fsnitz/ATLAS-ITk-MOPS-Hub-readout-prototype/Miscellaneous/Figures/PhysicaleLinkSetup.jpeg

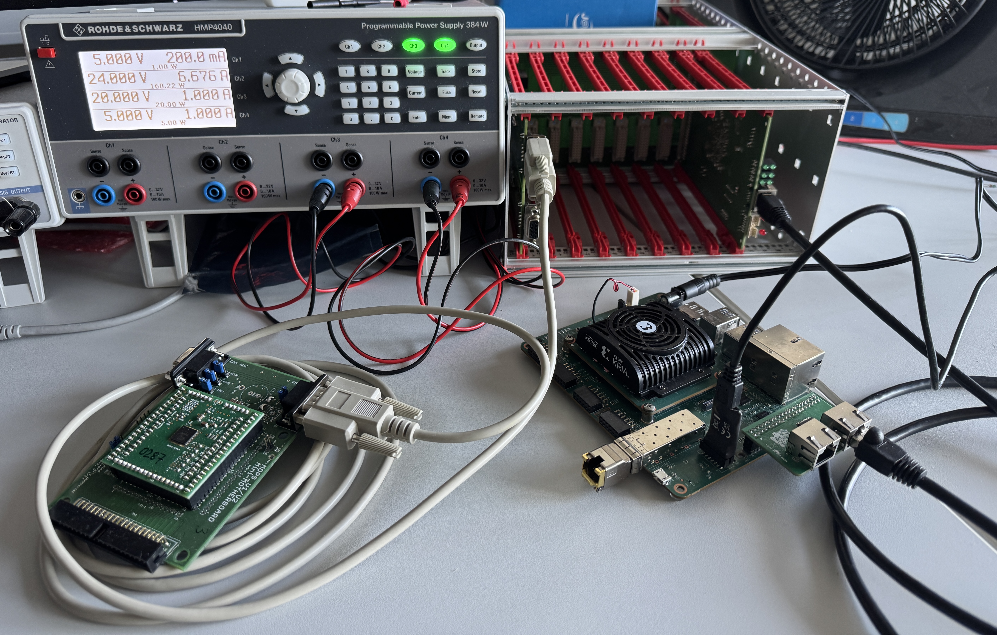
Miscellaneous/Figures/PhysicaleLinkSetup.jpeg
