fsnitz/ATLAS-ITk-MOPS-Hub-readout-prototype/Miscellaneous/Figures/backplane_3D.png

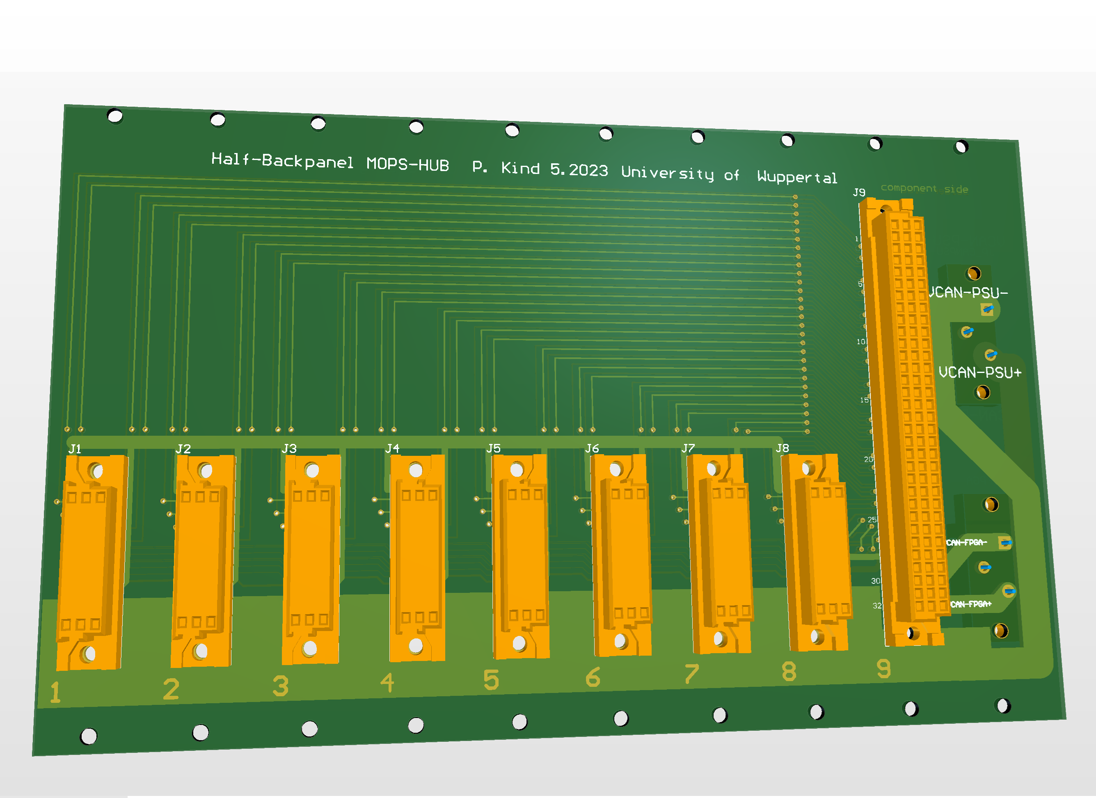
Miscellaneous/Figures/backplane_3D.png
