fsnitz/ATLAS-ITk-MOPS-Hub-readout-prototype/Miscellaneous/Figures/8b10b.png

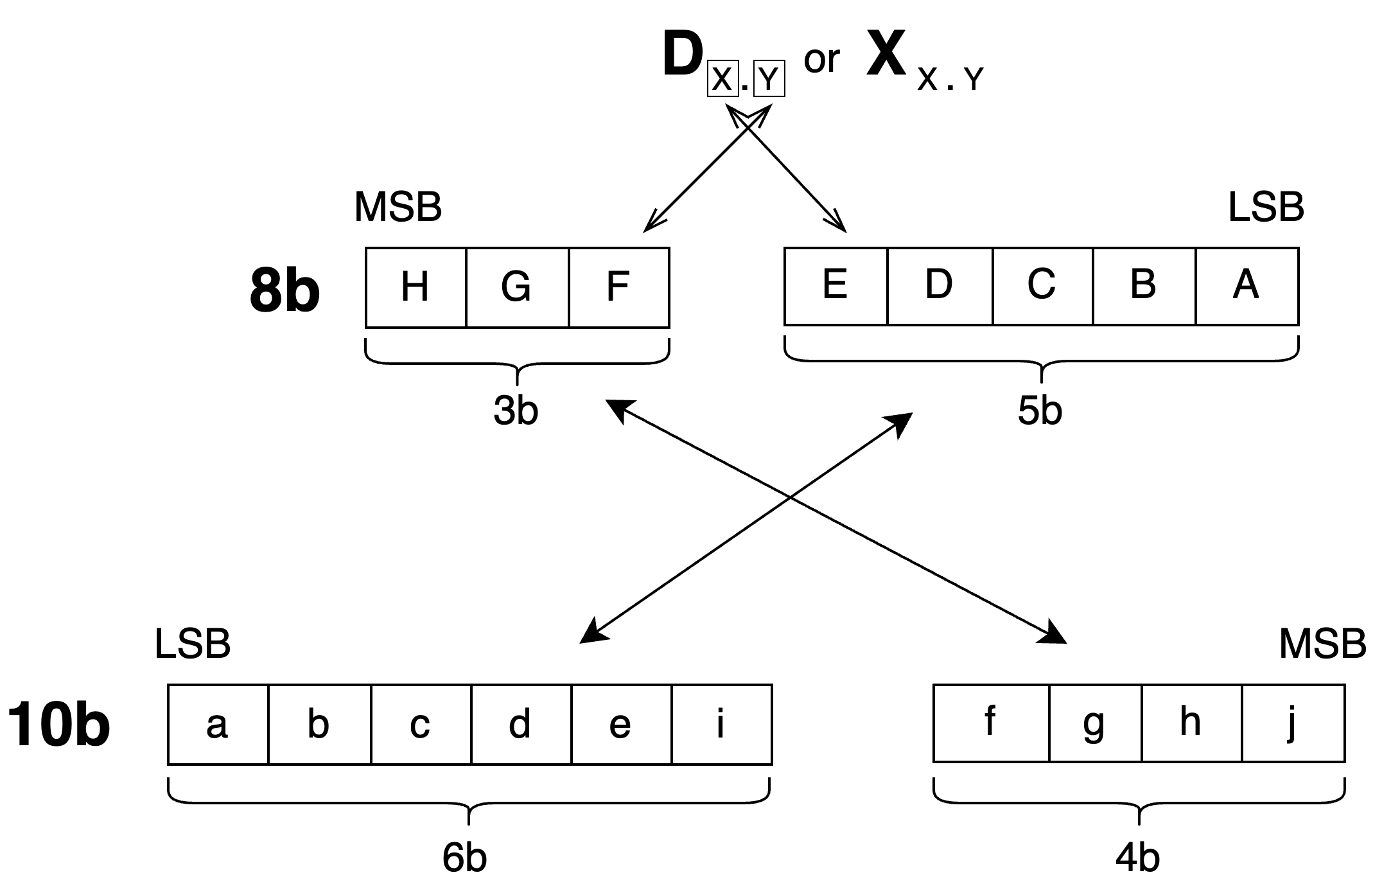
Miscellaneous/Figures/8b10b.png
