fsnitz/ATLAS-ITk-MOPS-Hub-readout-prototype/Miscellaneous/Figures/BaseAddressSetting.png

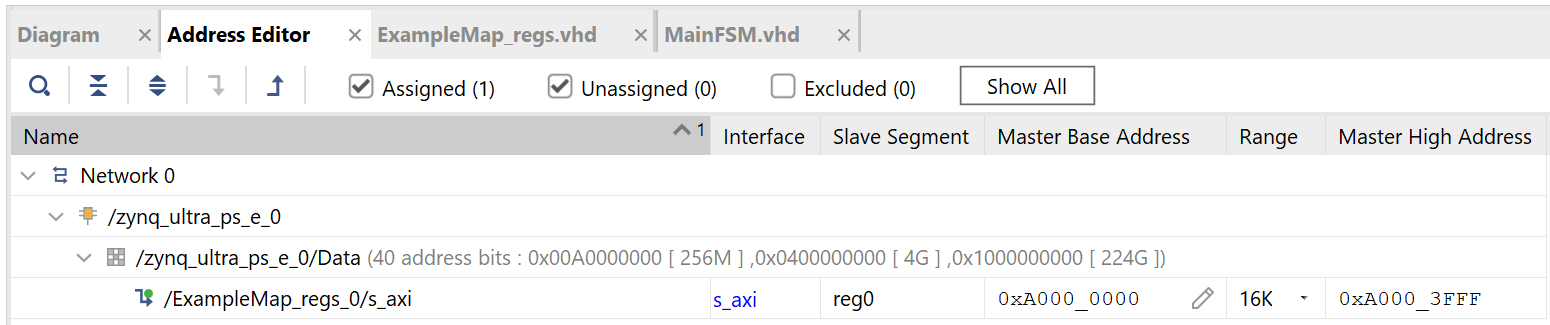
Miscellaneous/Figures/BaseAddressSetting.png
