fsnitz/ATLAS-ITk-MOPS-Hub-readout-prototype/Miscellaneous/Figures/BlockDiagramAirhdlExample.png

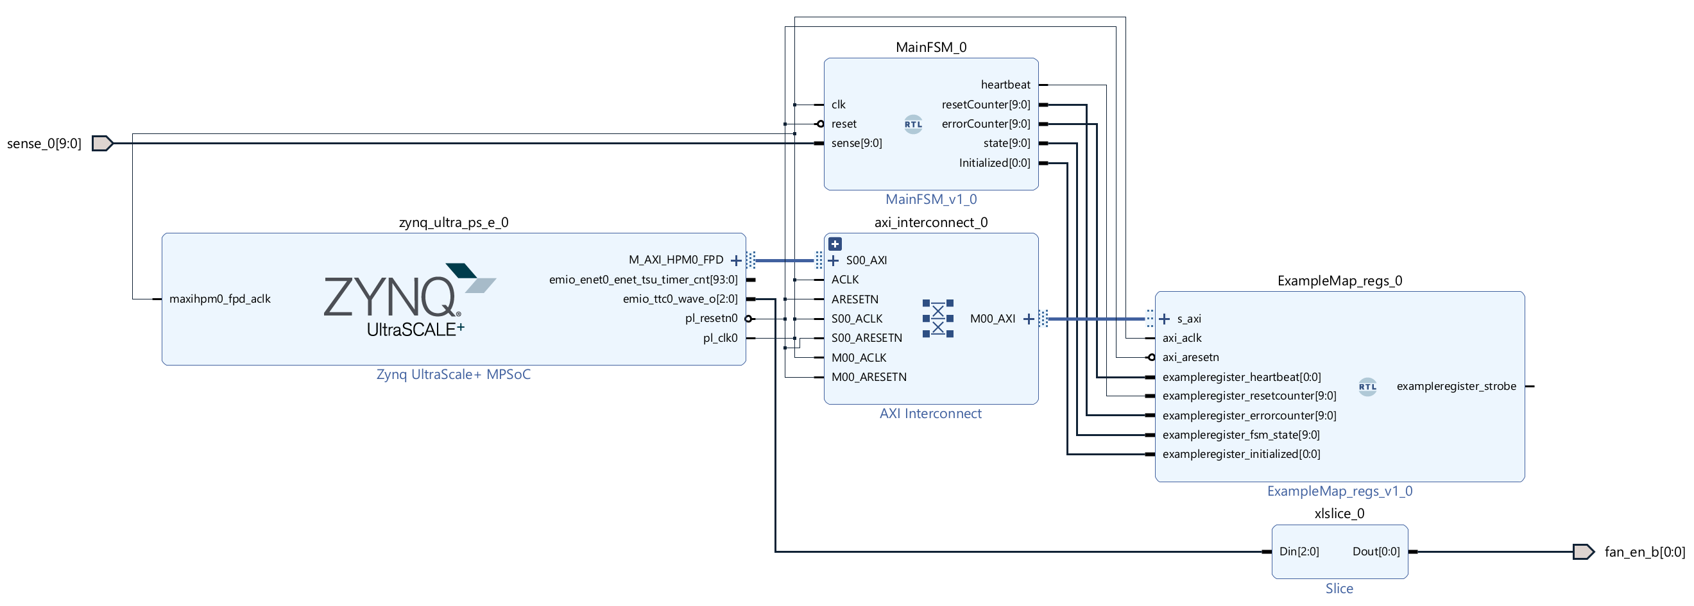
Miscellaneous/Figures/BlockDiagramAirhdlExample.png
