fsnitz/ATLAS-ITk-MOPS-Hub-readout-prototype/Miscellaneous/Figures/CIC_3d.png

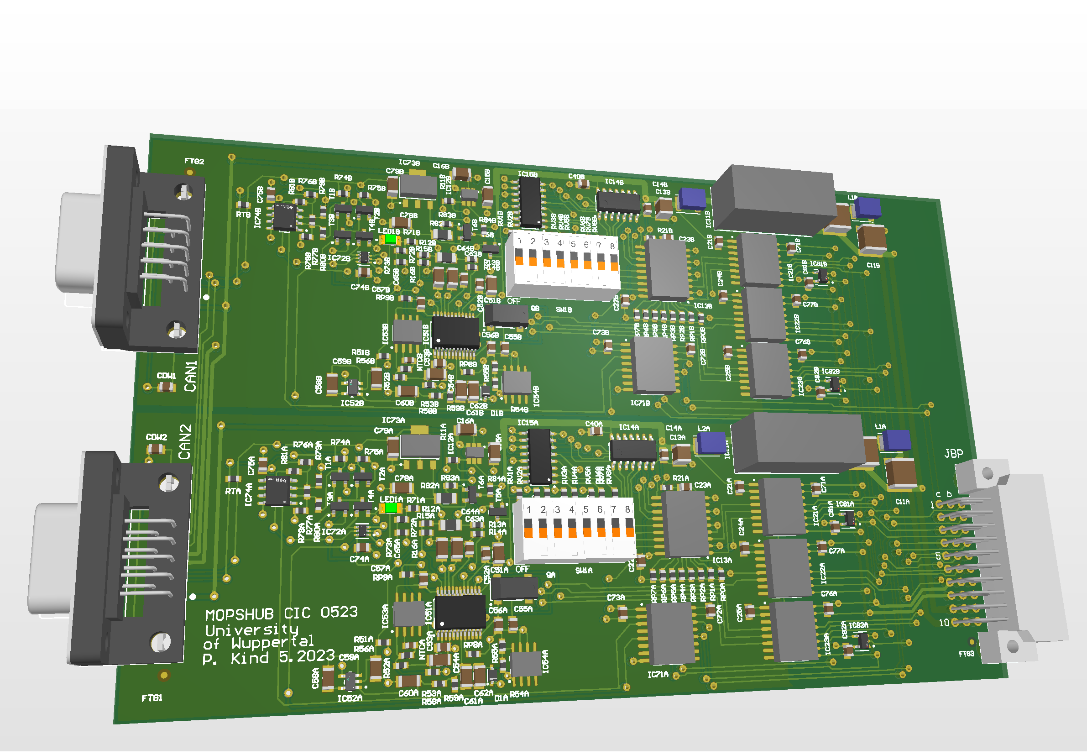
Miscellaneous/Figures/CIC_3d.png
