fsnitz/ATLAS-ITk-MOPS-Hub-readout-prototype/Miscellaneous/Figures/ClpsMultipleDrop.png

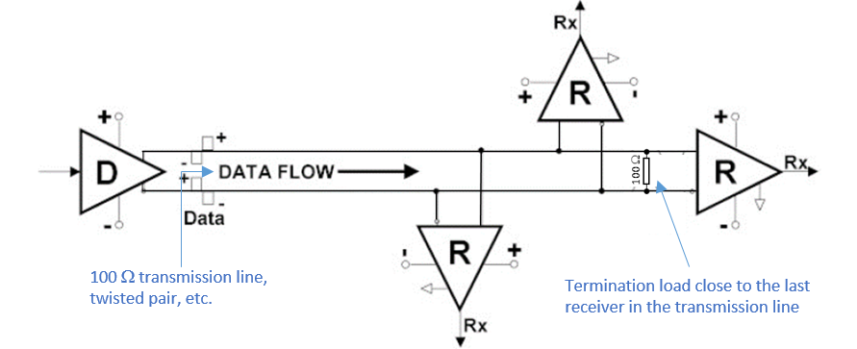
Miscellaneous/Figures/ClpsMultipleDrop.png
