fsnitz/ATLAS-ITk-MOPS-Hub-readout-prototype/Miscellaneous/Figures/ClpsSignalLevelsDefinition.png

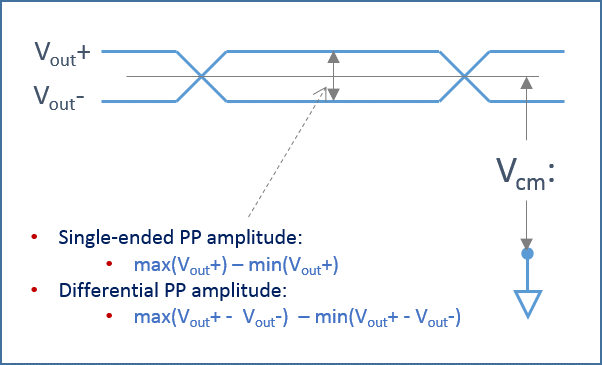
Miscellaneous/Figures/ClpsSignalLevelsDefinition.png
