fsnitz/ATLAS-ITk-MOPS-Hub-readout-prototype/Miscellaneous/Figures/CommonVoltageShift.png

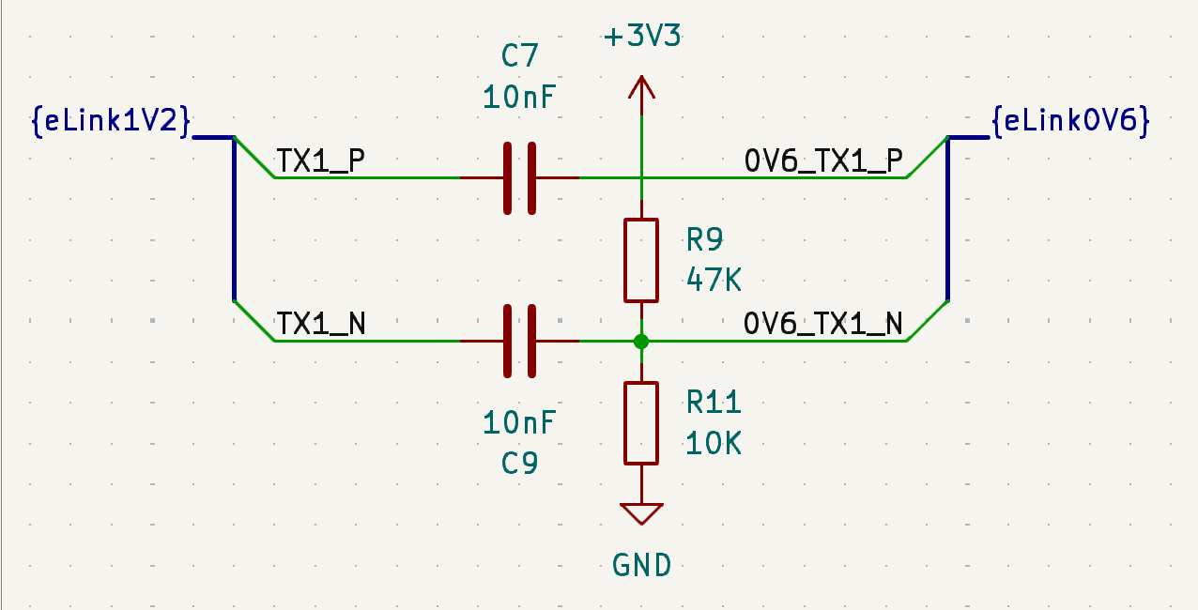
Miscellaneous/Figures/CommonVoltageShift.png
