fsnitz/ATLAS-ITk-MOPS-Hub-readout-prototype/Miscellaneous/Figures/crate_mopshub_top.png

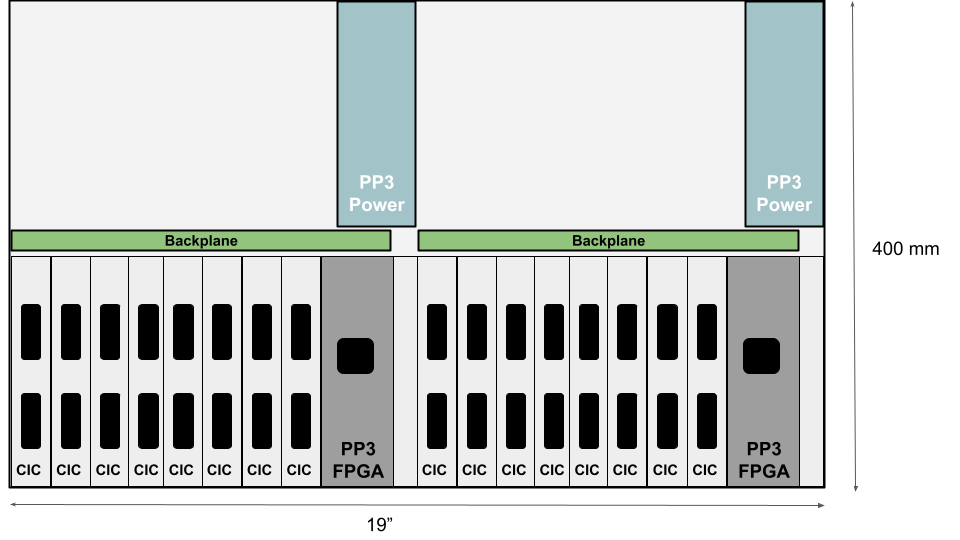
Miscellaneous/Figures/crate_mopshub_top.png
