fsnitz/ATLAS-ITk-MOPS-Hub-readout-prototype/Miscellaneous/Figures/eLinkHatRender.png

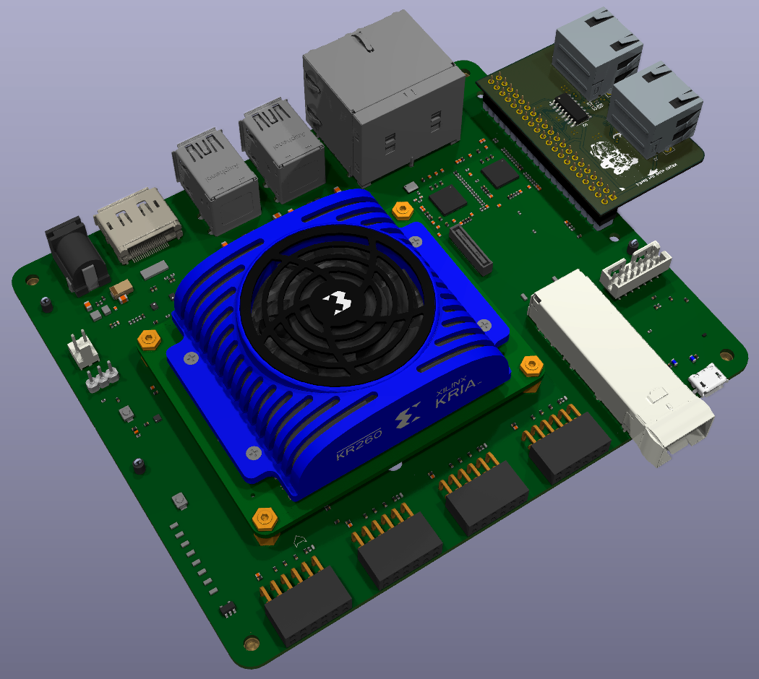
Miscellaneous/Figures/eLinkHatRender.png
