fsnitz/ATLAS-ITk-MOPS-Hub-readout-prototype/Miscellaneous/Figures/ExampleRegisterAirhdl.png

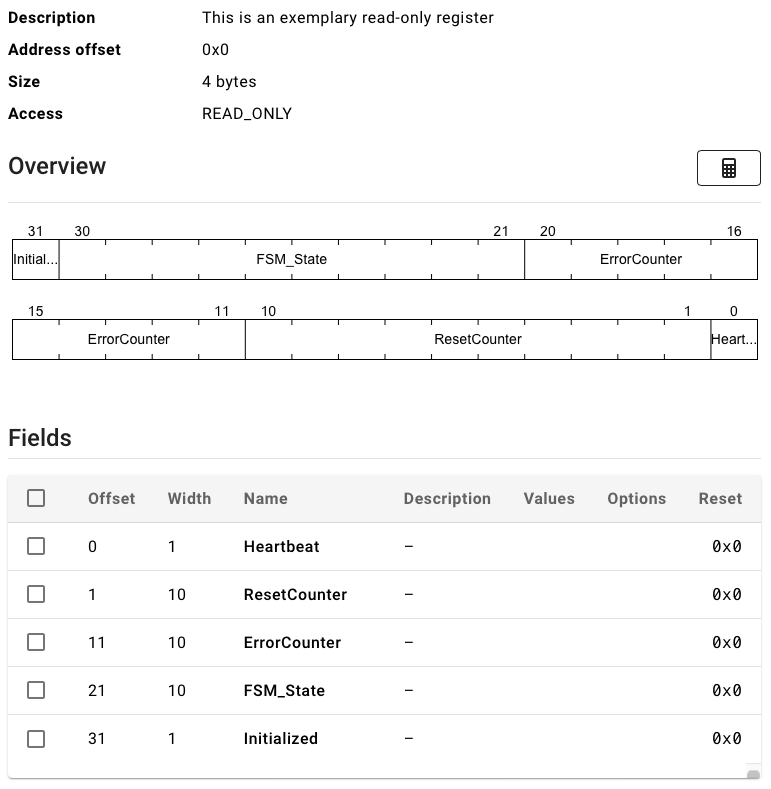
Miscellaneous/Figures/ExampleRegisterAirhdl.png
