fsnitz/ATLAS-ITk-MOPS-Hub-readout-prototype/Miscellaneous/Figures/IDDR.jpeg

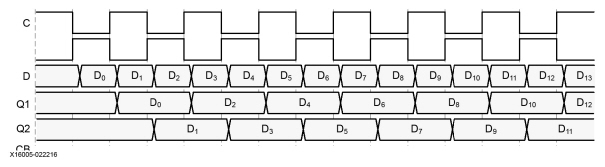
Miscellaneous/Figures/IDDR.jpeg
