fsnitz/ATLAS-ITk-MOPS-Hub-readout-prototype/Miscellaneous/Figures/IlaAfterChangeTo40MHz.png

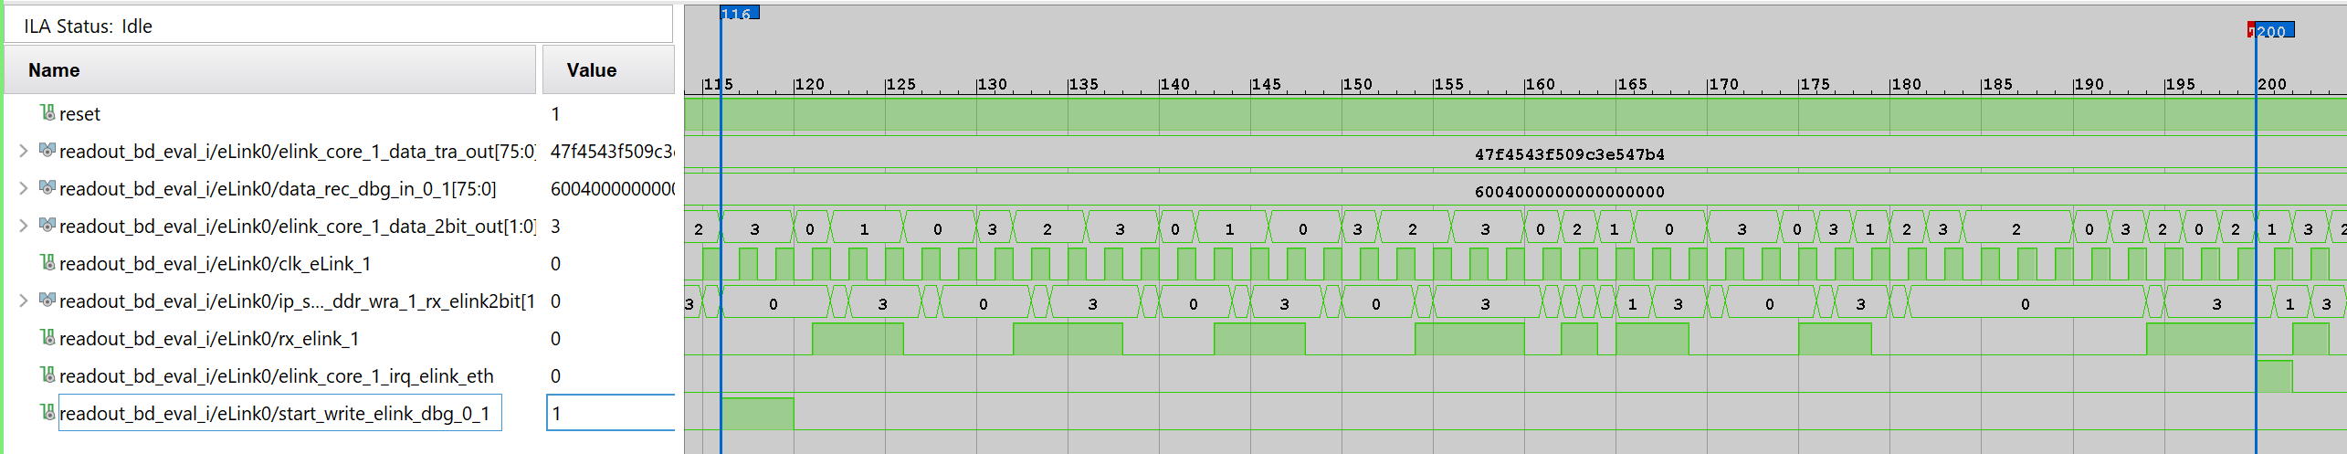
Miscellaneous/Figures/IlaAfterChangeTo40MHz.png
