fsnitz/ATLAS-ITk-MOPS-Hub-readout-prototype/Miscellaneous/Figures/IlaWithTimingError.png

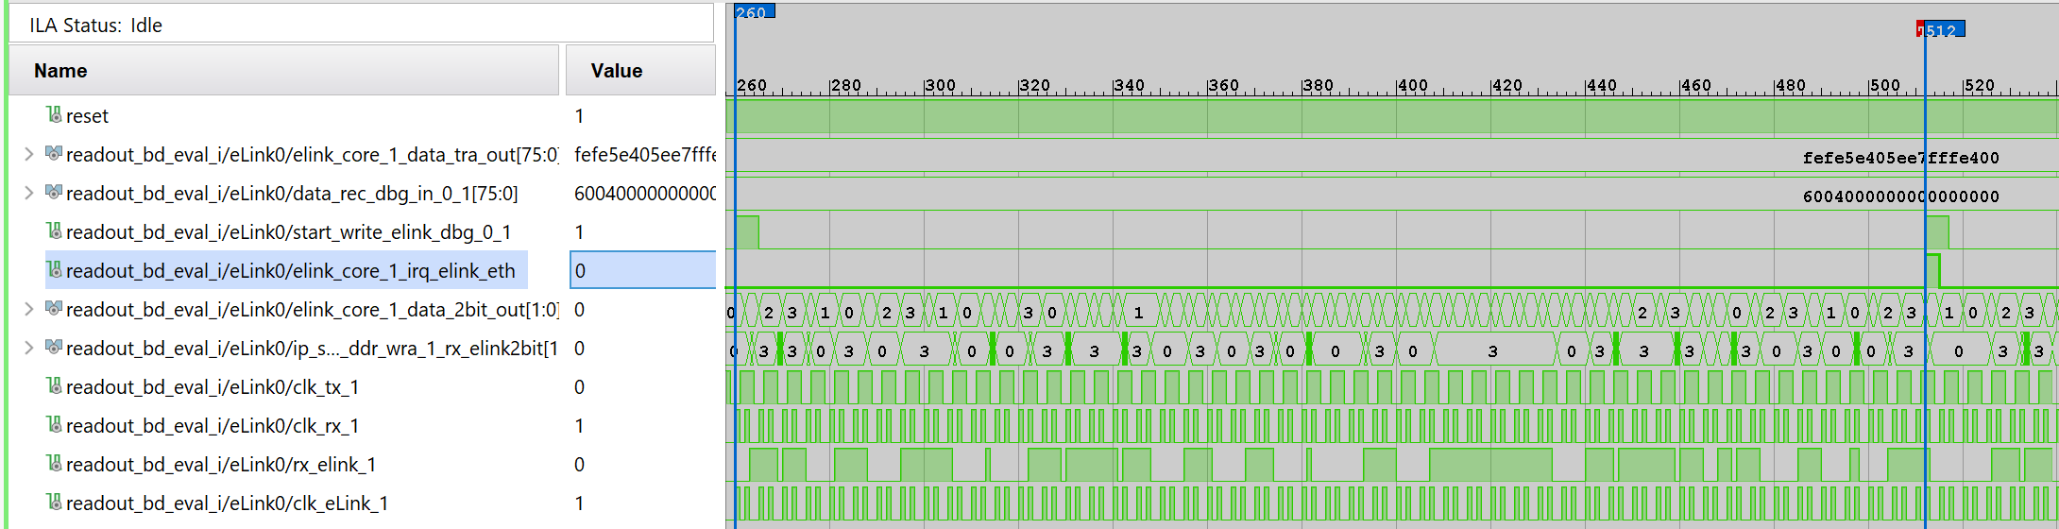
Miscellaneous/Figures/IlaWithTimingError.png
