fsnitz/ATLAS-ITk-MOPS-Hub-readout-prototype/Miscellaneous/Figures/InnerDetector.png

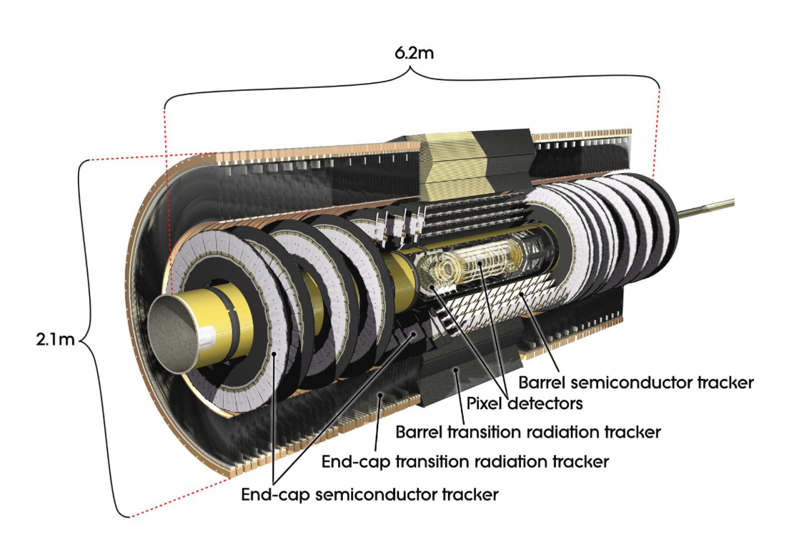
Miscellaneous/Figures/InnerDetector.png
