fsnitz/ATLAS-ITk-MOPS-Hub-readout-prototype/Miscellaneous/Figures/Loopback_biasing.jpeg

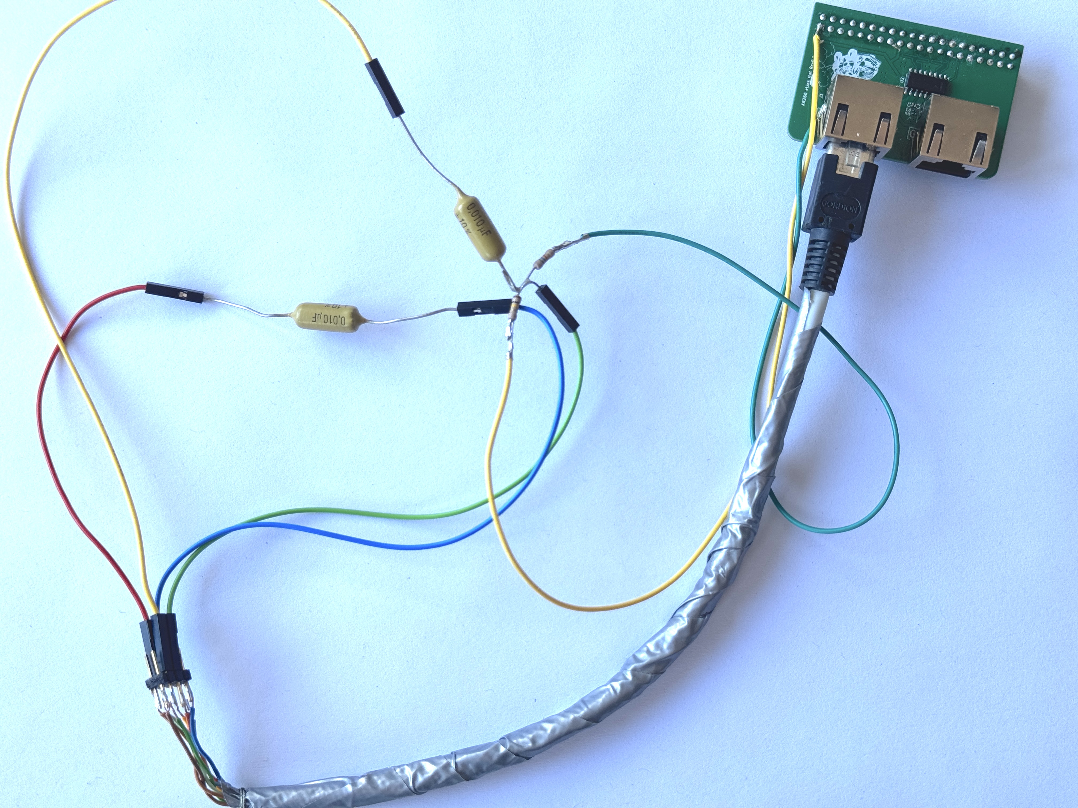
Miscellaneous/Figures/Loopback_biasing.jpeg
