fsnitz/ATLAS-ITk-MOPS-Hub-readout-prototype/Miscellaneous/Figures/ManagerConcept.png

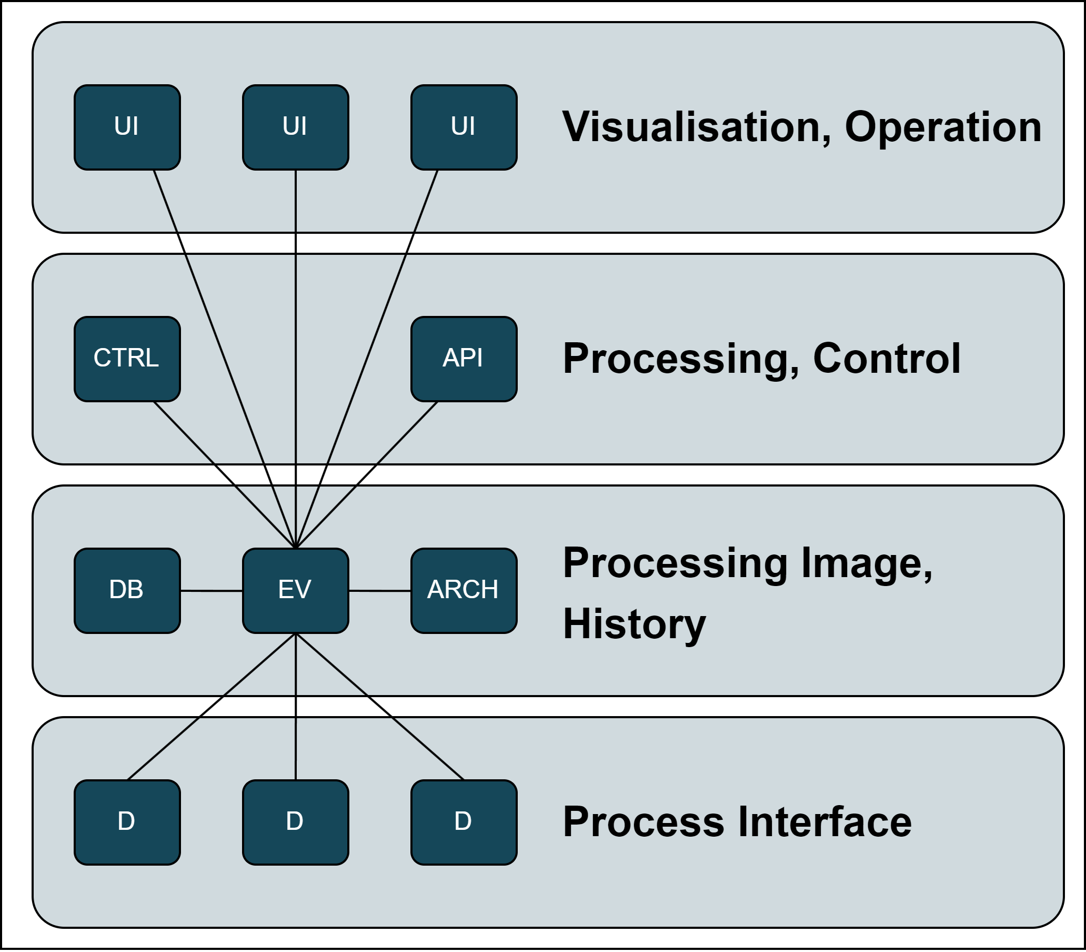
Miscellaneous/Figures/ManagerConcept.png
