fsnitz/ATLAS-ITk-MOPS-Hub-readout-prototype/Miscellaneous/Figures/MopsBlock.png

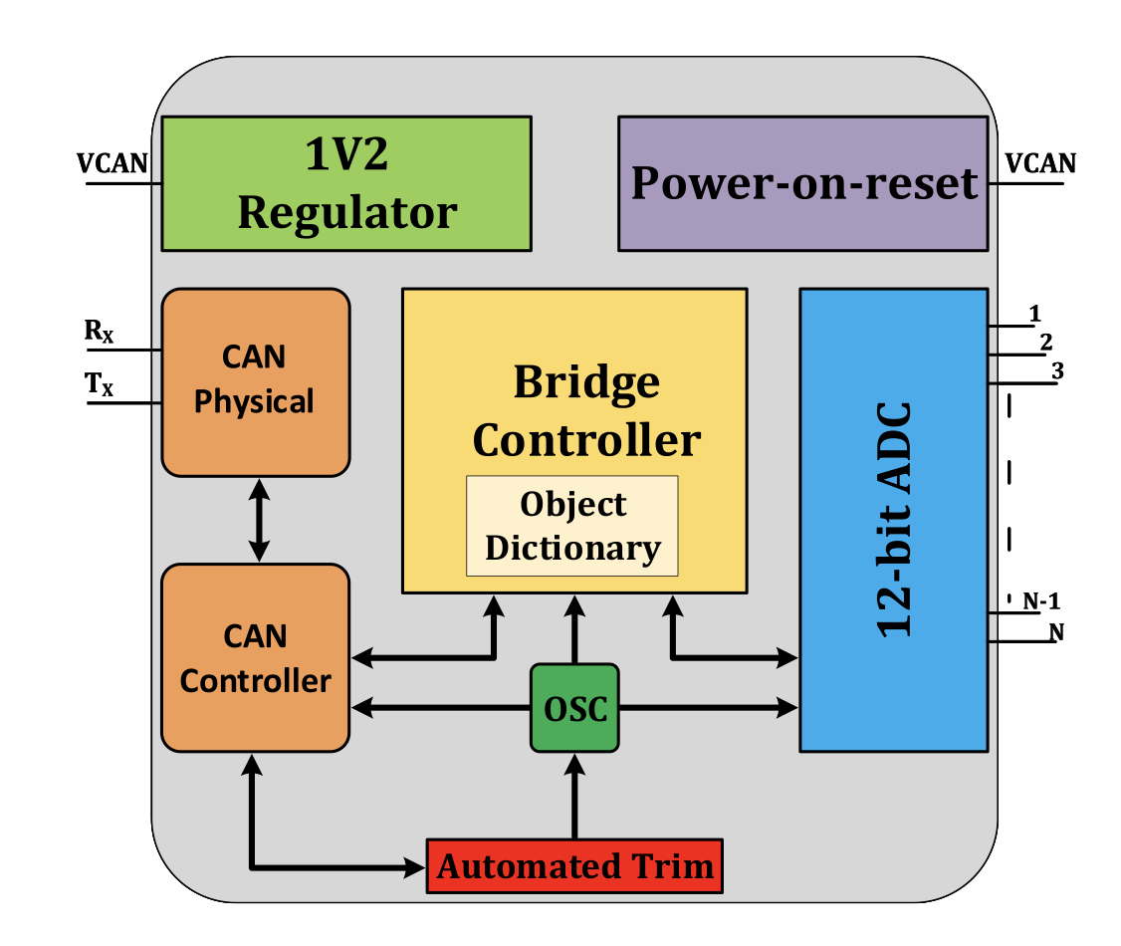
Miscellaneous/Figures/MopsBlock.png
