fsnitz/ATLAS-ITk-MOPS-Hub-readout-prototype/Miscellaneous/Figures/OpcUseCase.png

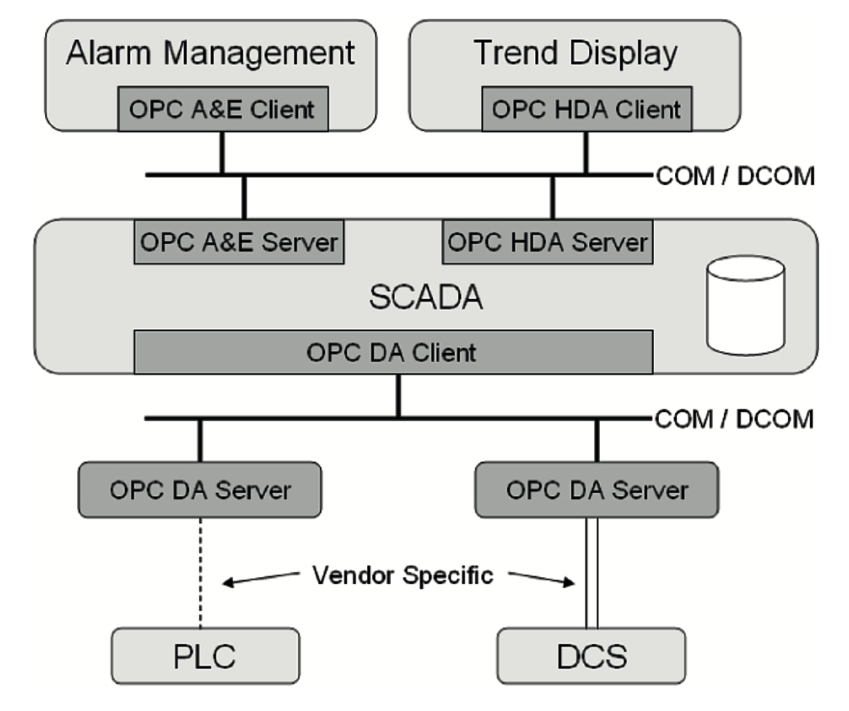
Miscellaneous/Figures/OpcUseCase.png
