fsnitz/ATLAS-ITk-MOPS-Hub-readout-prototype/Miscellaneous/Figures/OverviewScada.png

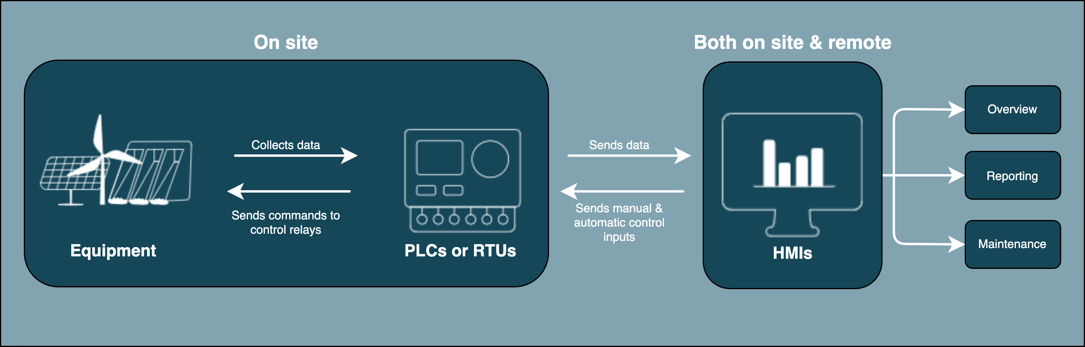
Miscellaneous/Figures/OverviewScada.png
