fsnitz/ATLAS-ITk-MOPS-Hub-readout-prototype/Miscellaneous/Figures/Pixel_DCS.png

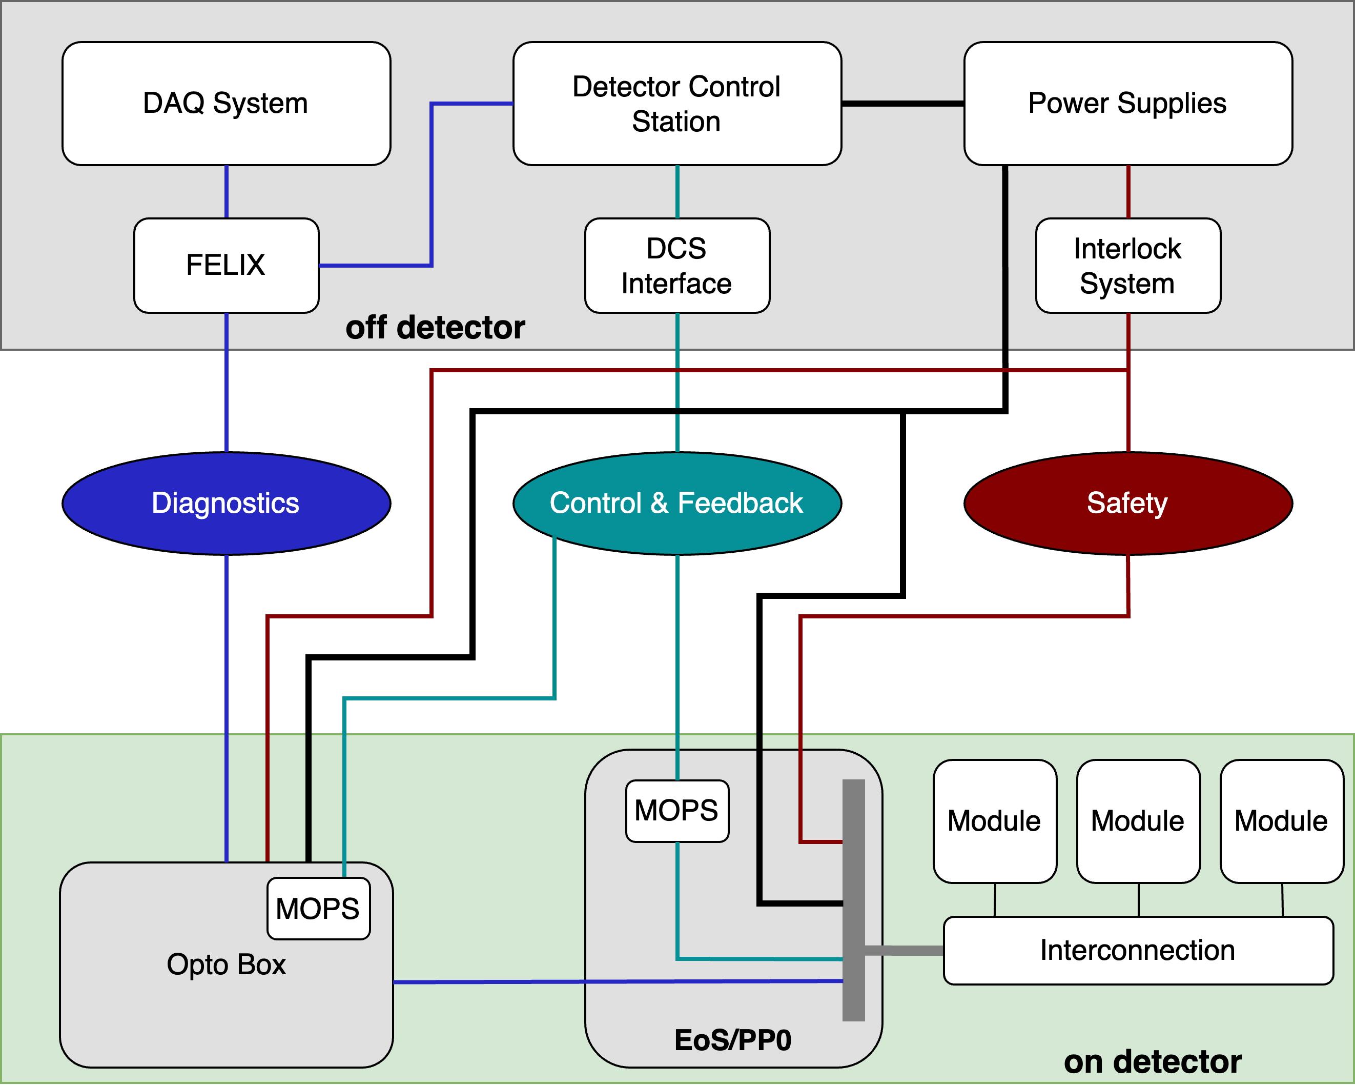
Miscellaneous/Figures/Pixel_DCS.png
