fsnitz/ATLAS-ITk-MOPS-Hub-readout-prototype/Miscellaneous/Figures/powercard_3d.png

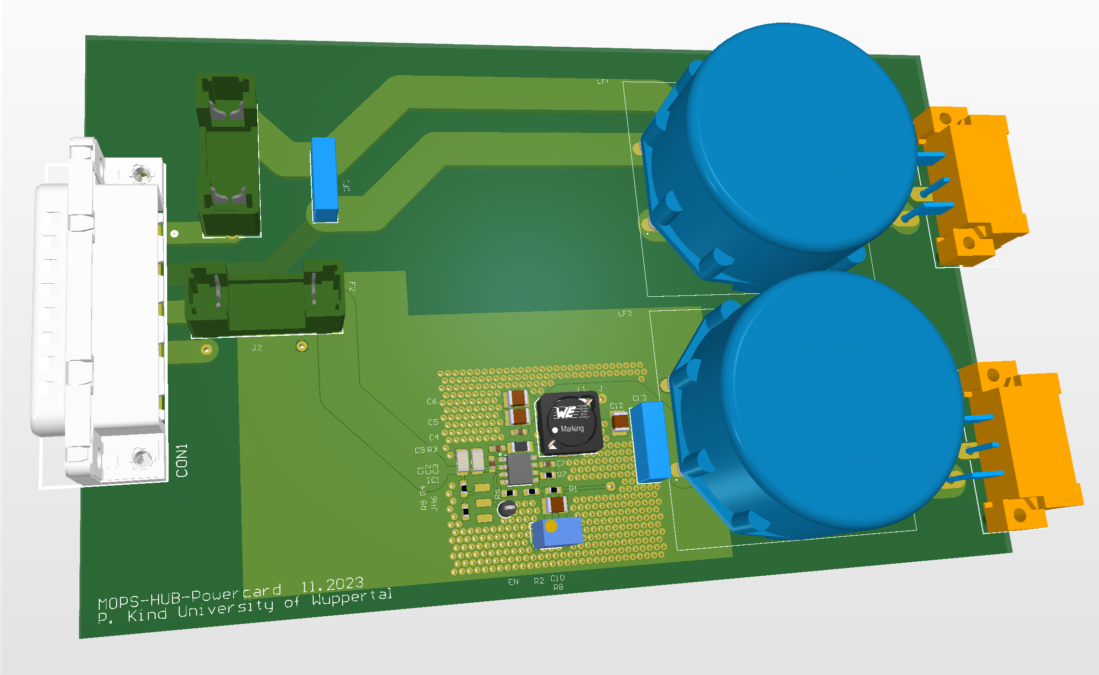
Miscellaneous/Figures/powercard_3d.png
