fsnitz/ATLAS-ITk-MOPS-Hub-readout-prototype/Miscellaneous/Figures/PP3_biasing.jpeg

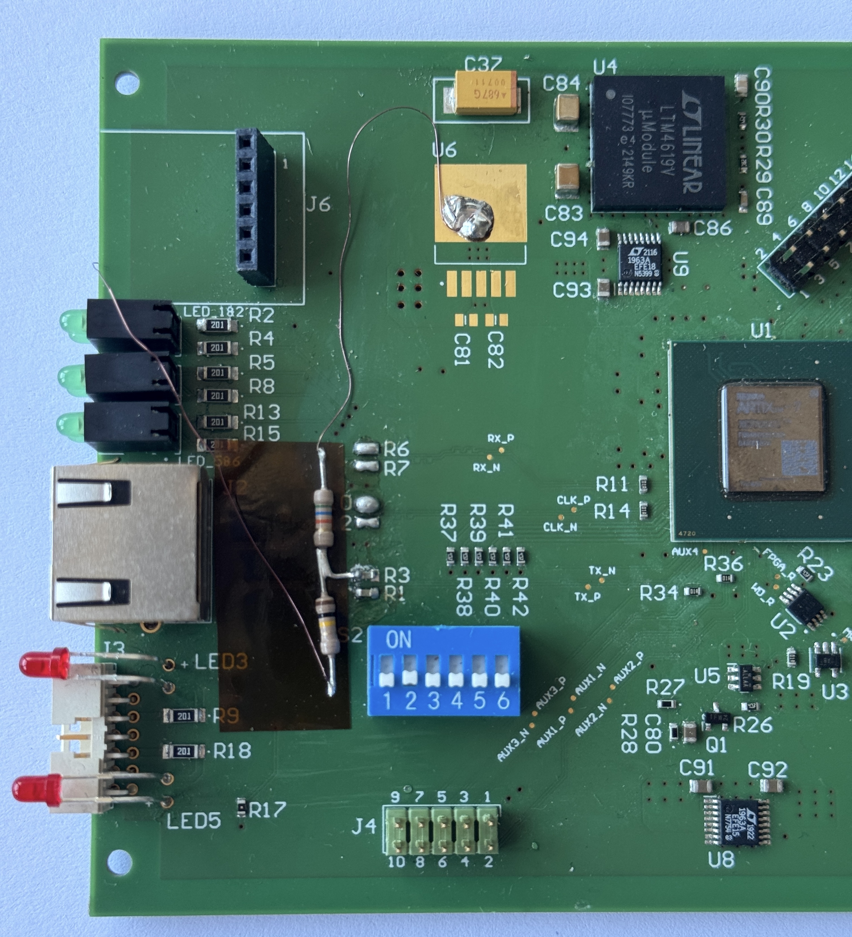
Miscellaneous/Figures/PP3_biasing.jpeg
