fsnitz/ATLAS-ITk-MOPS-Hub-readout-prototype/Miscellaneous/Figures/pp3_fpga_3D.png

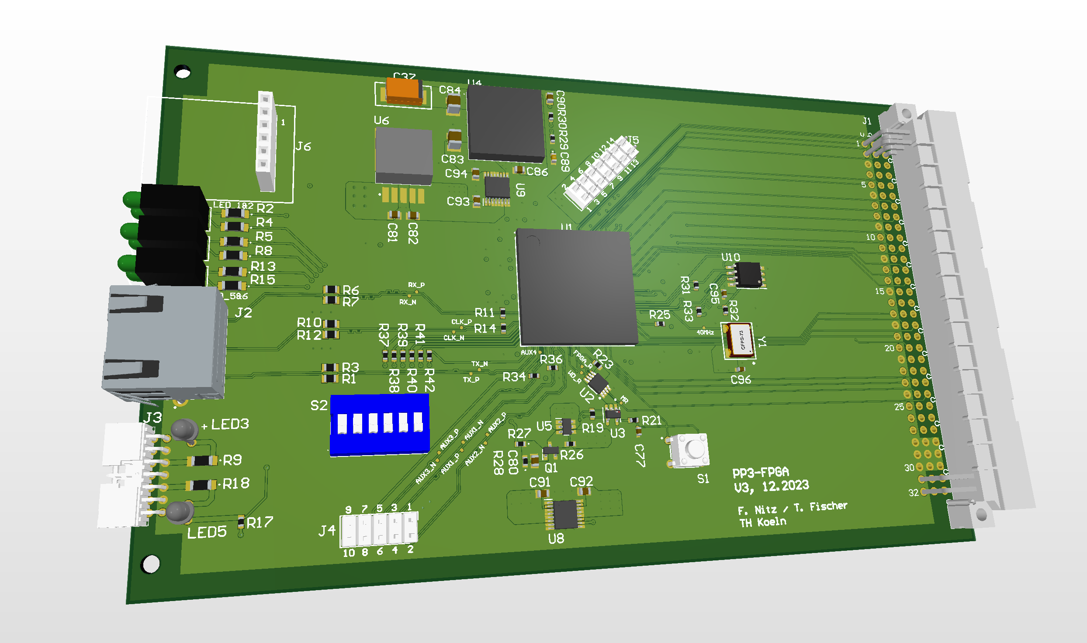
Miscellaneous/Figures/pp3_fpga_3D.png
