fsnitz/ATLAS-ITk-MOPS-Hub-readout-prototype/Miscellaneous/Figures/Readoutchain.png

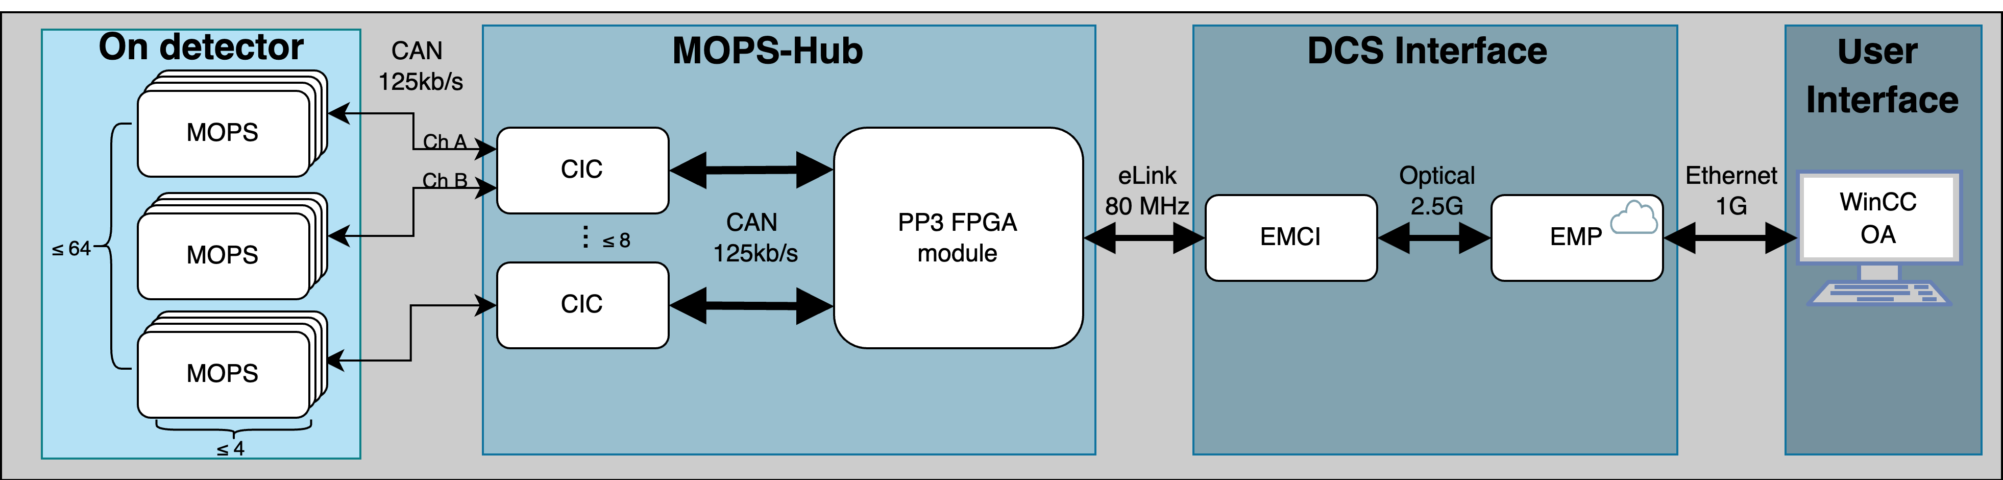
Miscellaneous/Figures/Readoutchain.png
