fsnitz/ATLAS-ITk-MOPS-Hub-readout-prototype/Miscellaneous/Figures/ReadoutchainKRIA.png

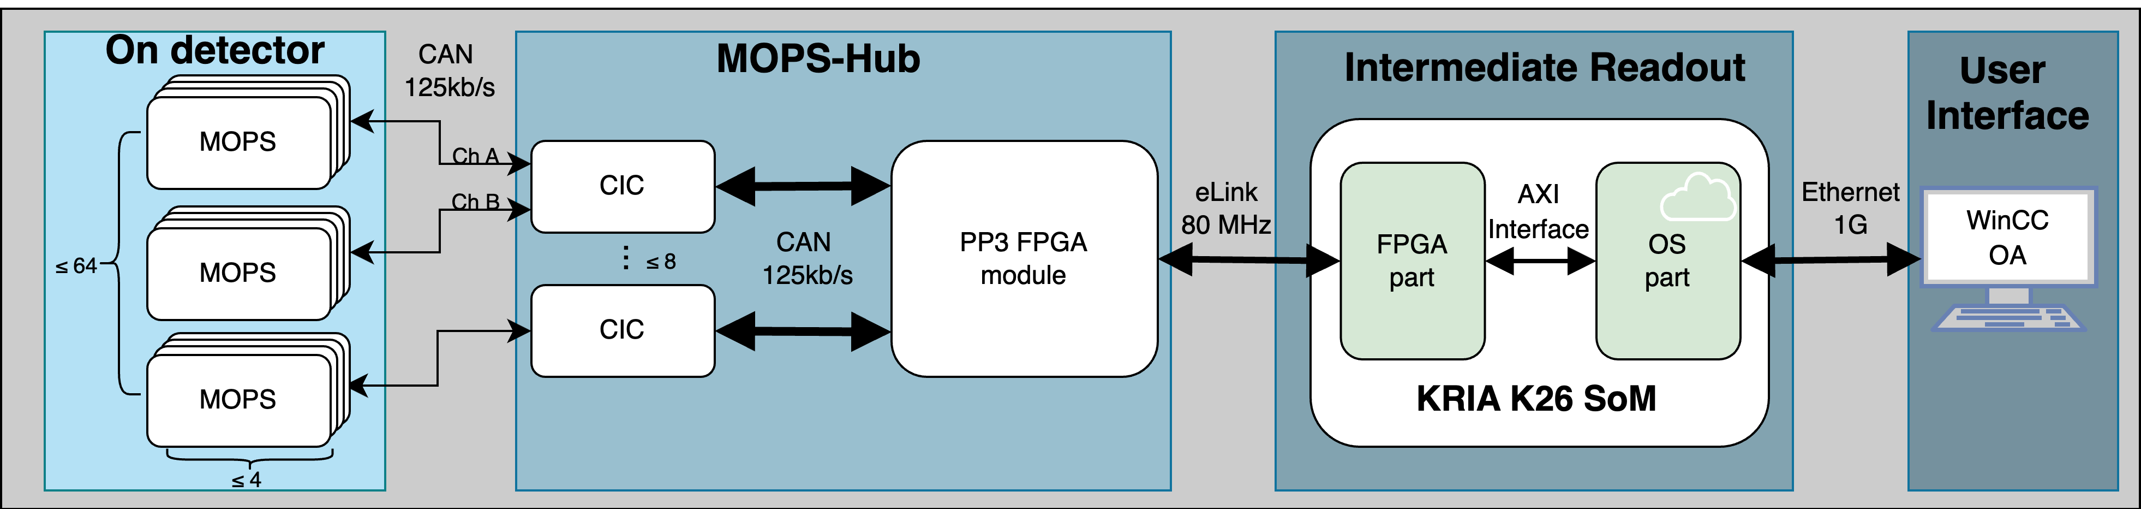
Miscellaneous/Figures/ReadoutchainKRIA.png
