fsnitz/ATLAS-ITk-MOPS-Hub-readout-prototype/Miscellaneous/Figures/ReadoutFirmwareBefor.png

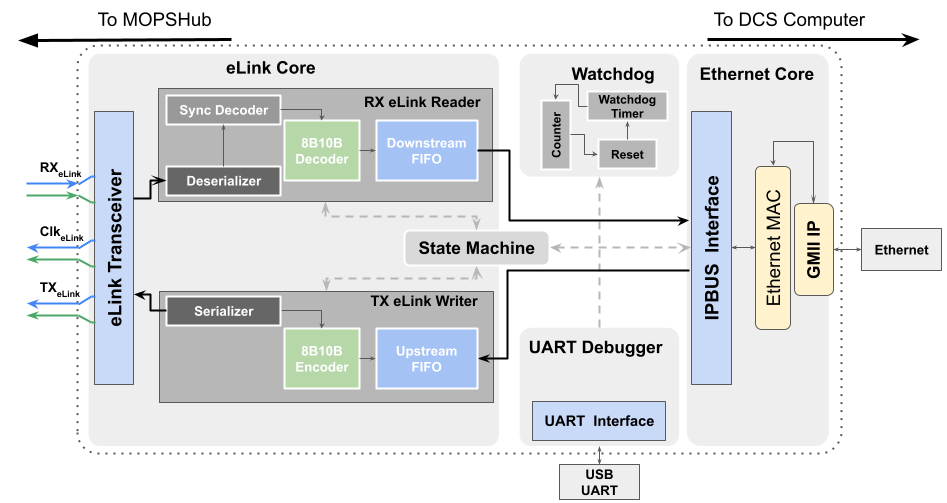
Miscellaneous/Figures/ReadoutFirmwareBefor.png
