fsnitz/ATLAS-ITk-MOPS-Hub-readout-prototype/Miscellaneous/Figures/Relationship.png

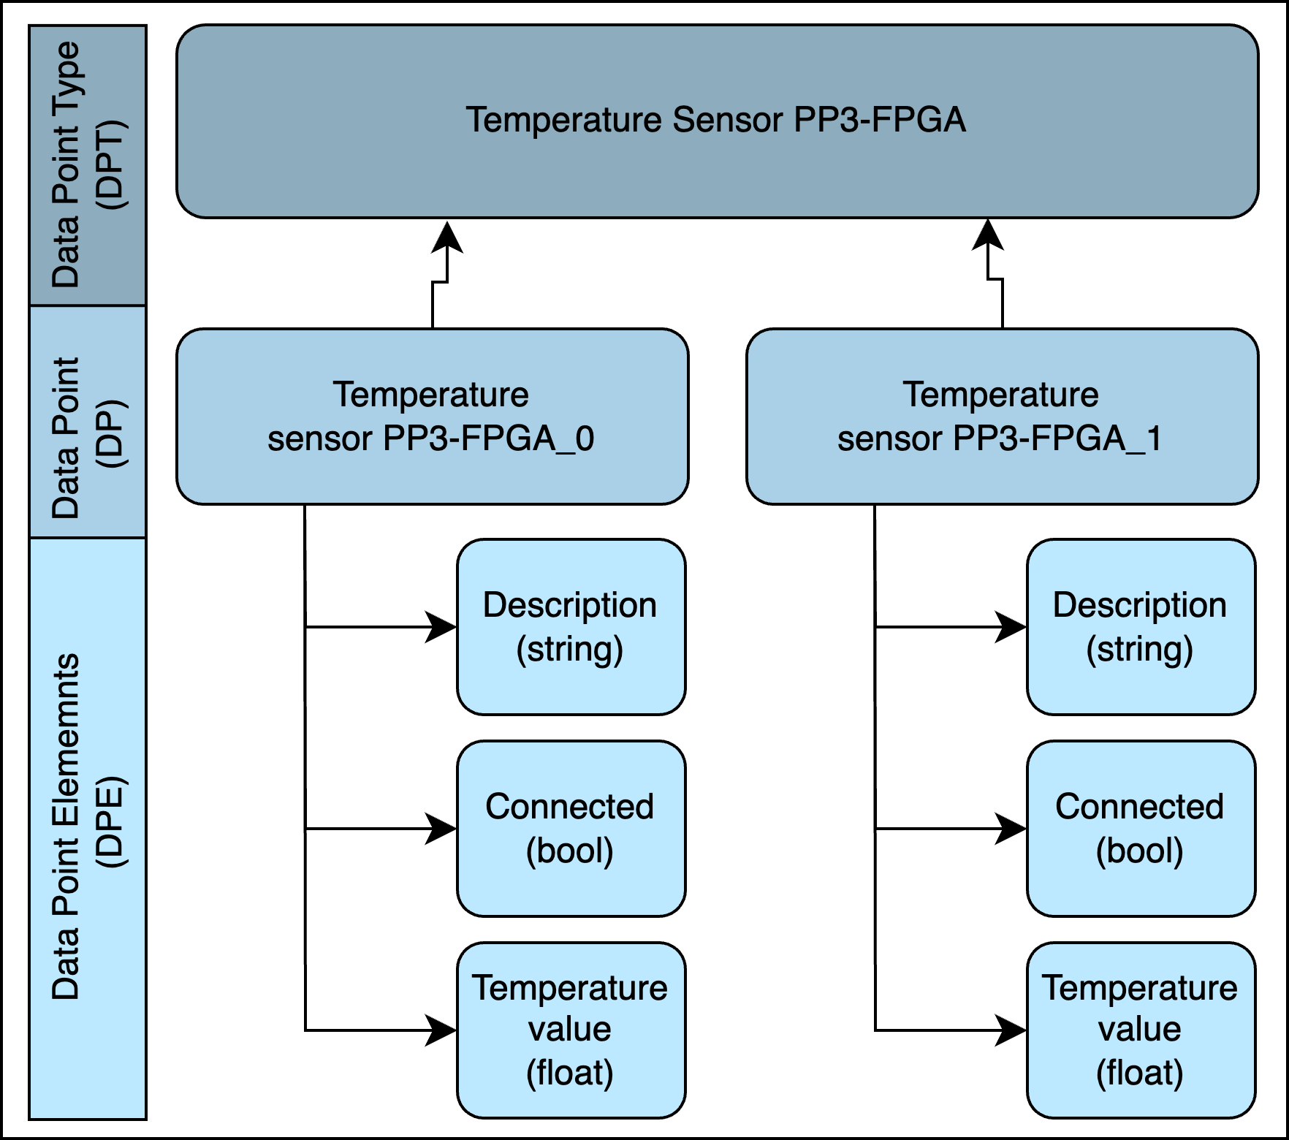
Miscellaneous/Figures/Relationship.png
