fsnitz/ATLAS-ITk-MOPS-Hub-readout-prototype/Miscellaneous/Figures/TimingReportError.png

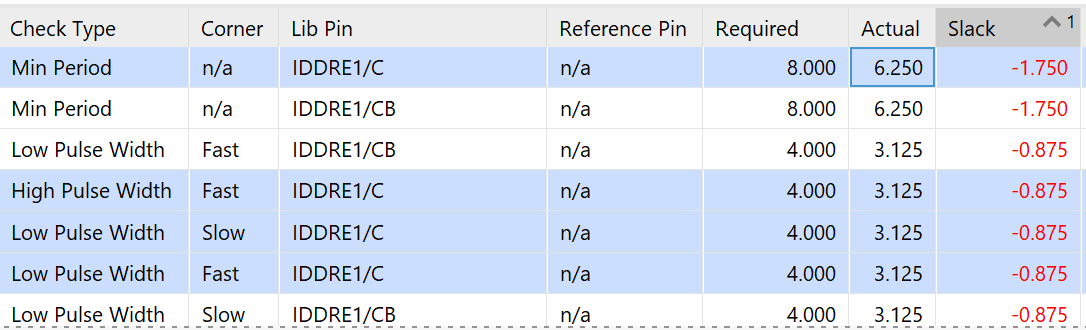
Miscellaneous/Figures/TimingReportError.png
