fsnitz/ATLAS-ITk-MOPS-Hub-readout-prototype/Miscellaneous/Figures/TX_CLK.png

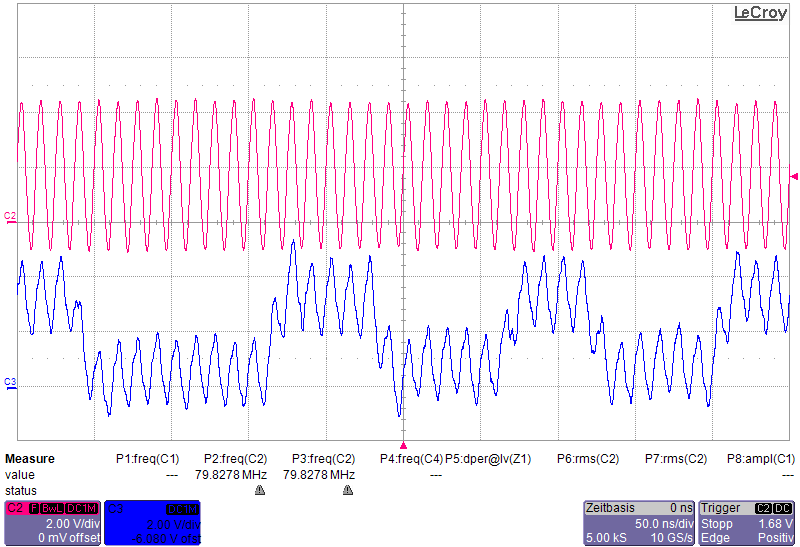
Miscellaneous/Figures/TX_CLK.png
