fsnitz/ATLAS-ITk-MOPS-Hub-readout-prototype/Miscellaneous/Figures/TX_CLK_40MHz.png

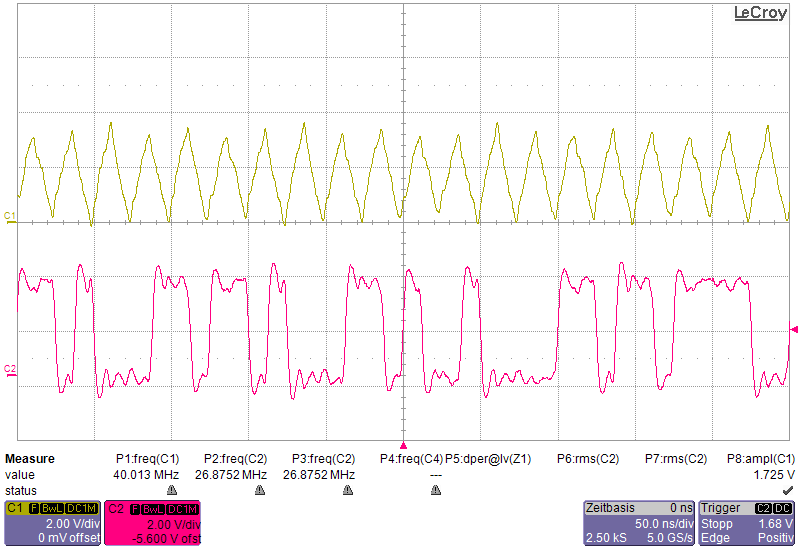
Miscellaneous/Figures/TX_CLK_40MHz.png
