fsnitz/ATLAS-ITk-MOPS-Hub-readout-prototype/Miscellaneous/Figures/TX_RX.png

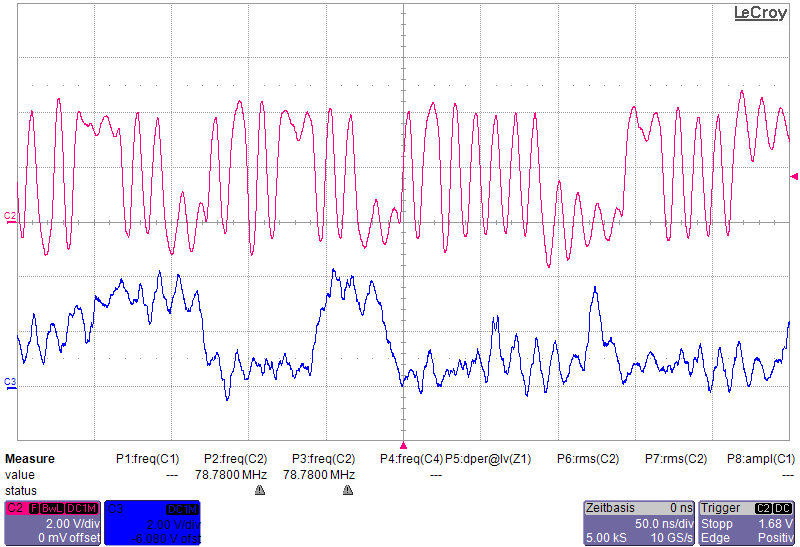
Miscellaneous/Figures/TX_RX.png
