fsnitz/ATLAS-ITk-MOPS-Hub-readout-prototype/Miscellaneous/Figures/TX_RX_BiasedToLVDS_40MHz.png

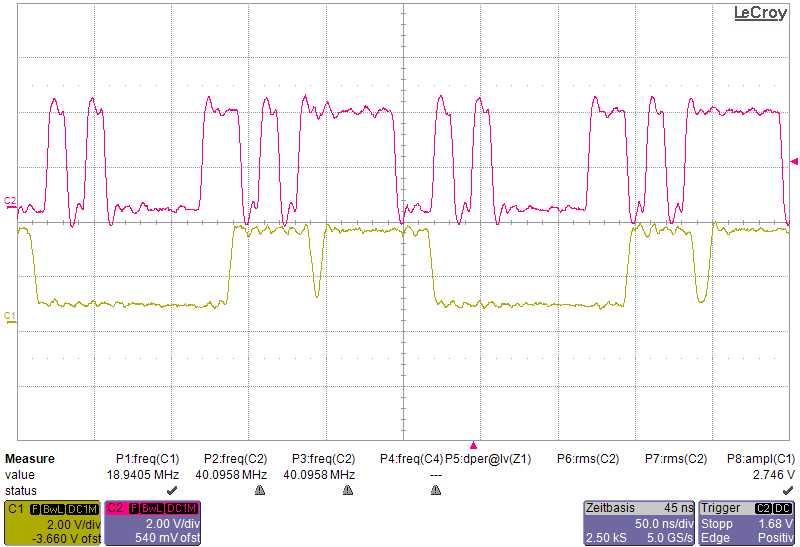
Miscellaneous/Figures/TX_RX_BiasedToLVDS_40MHz.png
