fsnitz/ATLAS-ITk-MOPS-Hub-readout-prototype/Hardware/KR260eLinkHat/rev02/KR260eLinkHatRev02_BOM.csv

Reference | Value | Description | Datasheet | Footprint | Mouser Part Number | Qty
C1,C2,C3,C4,C5,C6,C7,C8,C9,C10 | 10nF | Unpolarized capacitor | https://www.mouser.de/datasheet/2/447/UPY_NP0X5R_01005_4V_to_25V_V10-3003057.pdf | Capacitor_SMD:C_0201_0603Metric | 603-CC0201JX7R6BB103 | 10
J1 | PinSocket_2x20_P2.54mm | Vorhanden im Labor (Schrank 1) |  | ReadoutBoard_Footprints:RpiHat |  | 1
J2,J3 | RJ45_Shielded | 9x vorhanden in der PP3-FPGA Teilekiste | https://www.we-online.com/components/products/datasheet/615008140621.pdf | ReadoutBoard_Footprints:WR-MJ Modular Jack Horizontal Shielded_615008140621 | 710-615008140621 | 2
R1,R2 | 100R | Resistor | https://www.mouser.de/datasheet/2/315/AOA0000C304-1149620.pdf | Resistor_SMD:R_0201_0603Metric | 667-ERJ-1RKD1000C | 2
R3,R5,R6,R9,R10 | 47K | Resistor | https://www.mouser.de/datasheet/2/447/PYu_RE_105_RoHS_L_6-3003059.pdf | Resistor_SMD:R_0201_0603Metric | 603-RE0201BRE0710KL | 5
R4,R7,R8,R11,R12 | 10K | Resistor | https://www.mouser.de/datasheet/2/447/PYu_RE_105_RoHS_L_6-3003059.pdf | Resistor_SMD:R_0201_0603Metric | 603-RE0201BRE0747KL | 5
R13,R15 | 100K | Resistor | https://www.mouser.de/datasheet/2/447/PYu_RE_105_RoHS_L_6-3003059.pdf | Resistor_SMD:R_0201_0603Metric | 603-RE0201BRE0710KL | 2
R14,R16 | 56K | Resistor | https://www.mouser.de/datasheet/2/447/PYu_RE_105_RoHS_L_6-3003059.pdf | Resistor_SMD:R_0201_0603Metric | 603-RE0201BRE0747KL | 2
U2 | SN65LVDS047DR | Quad LVDS Differential Line Driver, 400Mbps, SOIC-16 | http://www.ti.com/lit/ds/symlink/sn65lvds047.pdf | Package_SO:SOIC-16_3.9x9.9mm_P1.27mm | 595-SN65LVDS047DR | 1
U1 | SN65LVDS050DR | Dual LVDS Transmitter/Receiver | http://www.ti.com/lit/gpn/sn65lvds050 | SOIC127P600X175-16N | 595-SN65LVDS050DR | 1
