fsnitz/ATLAS-ITk-MOPS-Hub-readout-prototype/Miscellaneous/BlockDesignPrints/ExampleProject.pdf

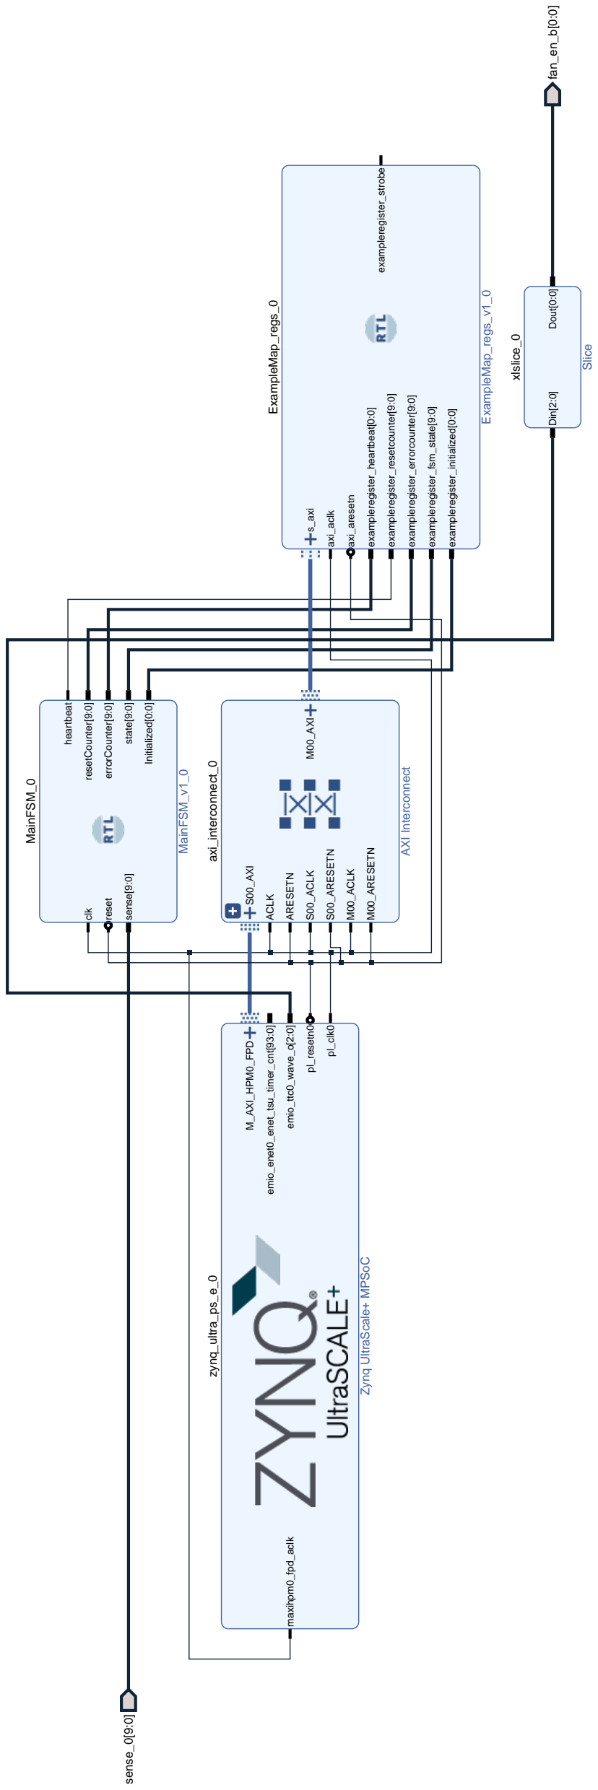
[picture p44: figure]
ExampleMap_regs_0; ExampleMap_regs_v1_0; s_axi; axi_aclk; axi_aresetn; exampleregister_strobe; exampleregister_heartbeat[0:0]; exampleregister_resetcounter[9:0]; exampleregister_errorcounter[9:0]; exampleregister_fsm_state[9:0]; exampleregister_initialized[0:0]; MainFSM_0; MainFSM_v1_0; heartbeat; resetCounter[9:0]; errorCounter[9:0]; state[9:0]; Initialized[0:0]; clk; reset; sense[9:0]; axi_interconnect_0; AXI Interconnect; S00_AXI; M00_AXI; ACLK; ARESETN; S00_ACLK; S00_ARESETN; M00_ACLK; M00_ARESETN; fan_en_b[0:0]; sense_0[9:0]; xlslice_0; Slice; Din[2:0] Dout[0:0]; zynq_ultra_ps_e_0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
