fsnitz/ATLAS-ITk-MOPS-Hub-readout-prototype/Miscellaneous/Figures/eLink_Test_40Mhz_closeUp.png

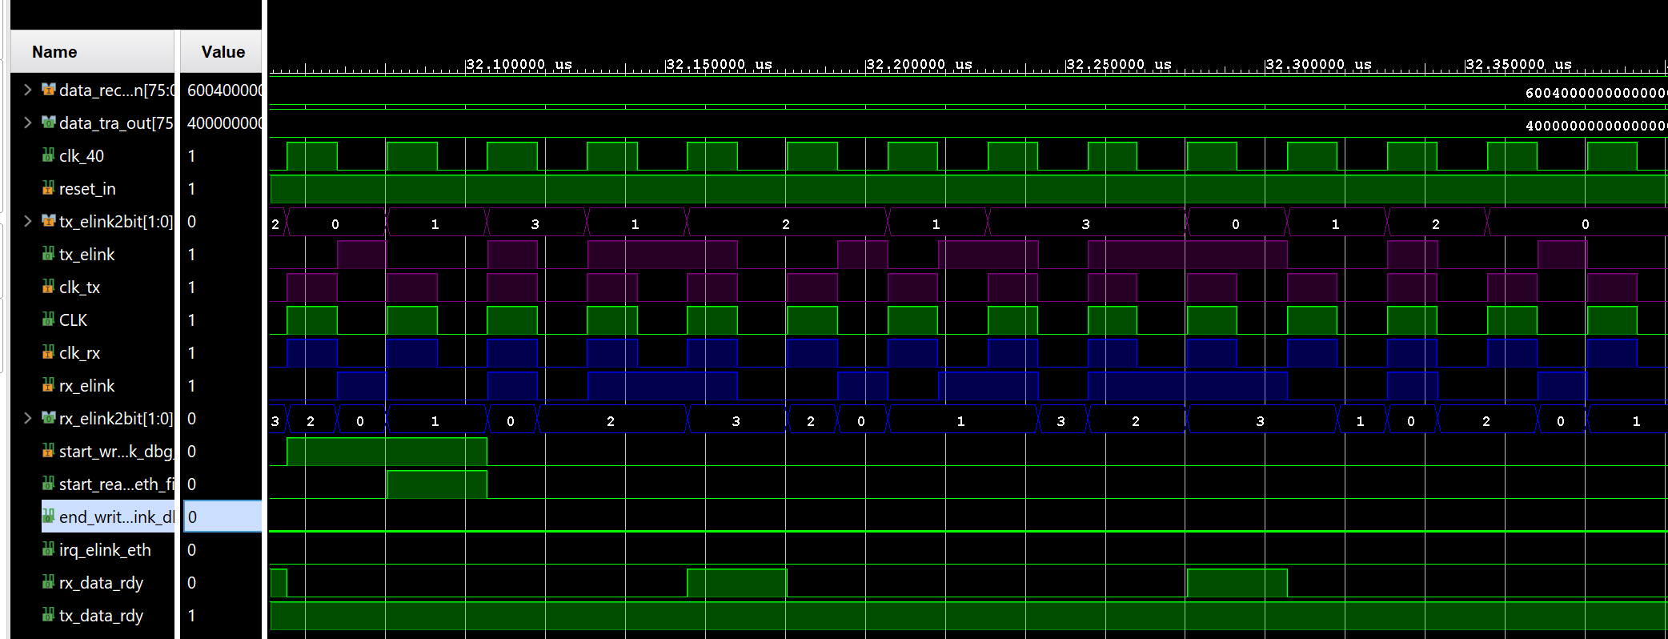
Miscellaneous/Figures/eLink_Test_40Mhz_closeUp.png
