fsnitz/ATLAS-ITk-MOPS-Hub-readout-prototype/Miscellaneous/Figures/eLink_Test_160Mhz.png

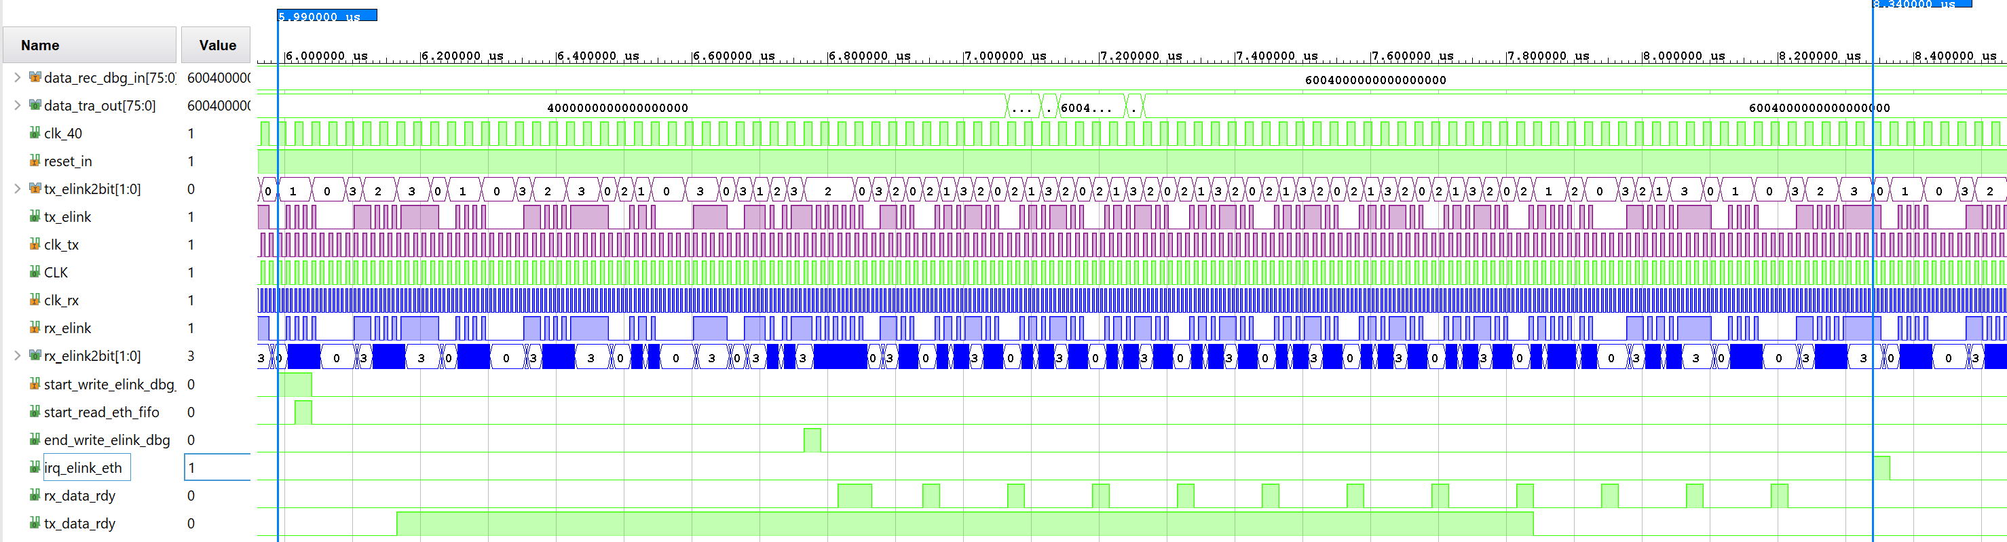
Miscellaneous/Figures/eLink_Test_160Mhz.png
