fsnitz/ATLAS-ITk-MOPS-Hub-readout-prototype/Hardware/MOPS-Hub_Readout_board/MOPS-Hub_Readout_board.pdf

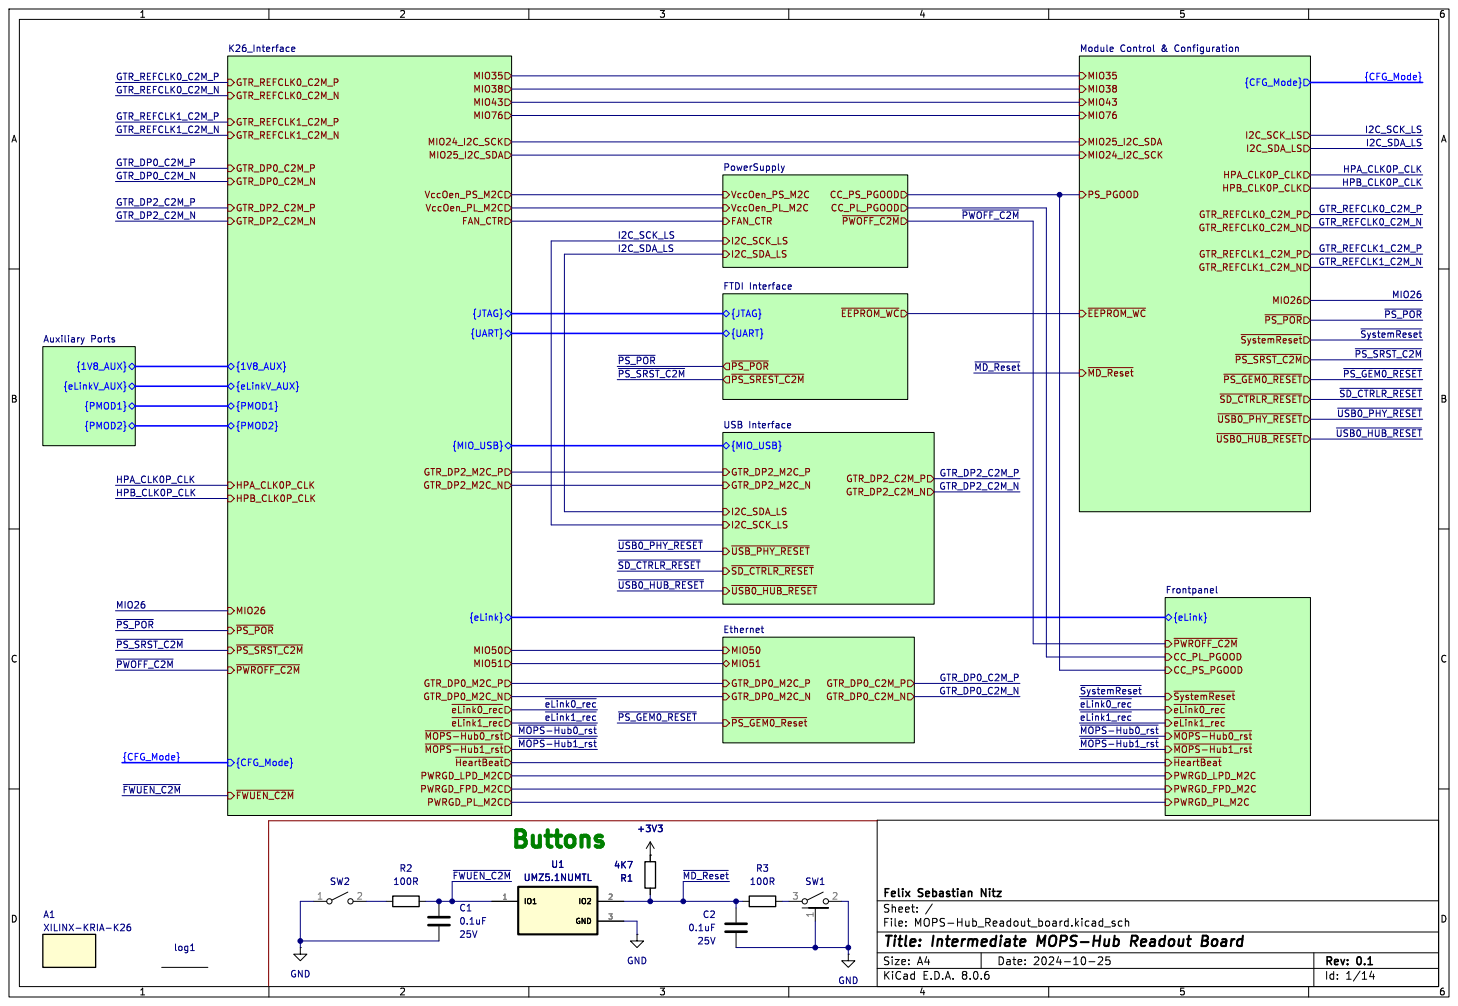
[picture p50: page 1]

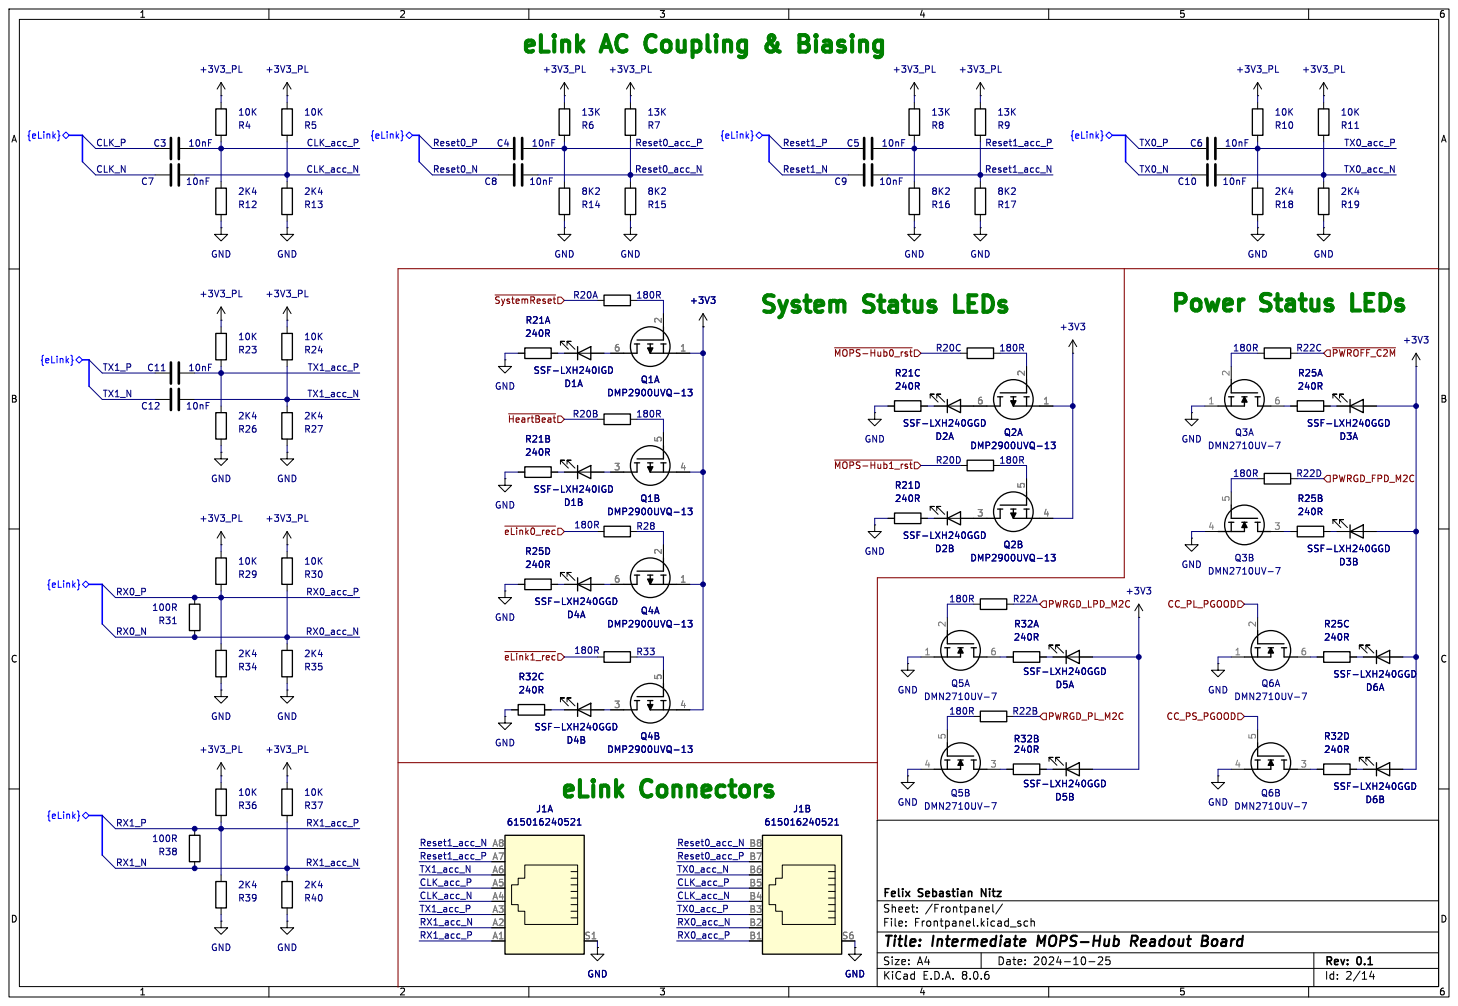
[picture p51: page 2]

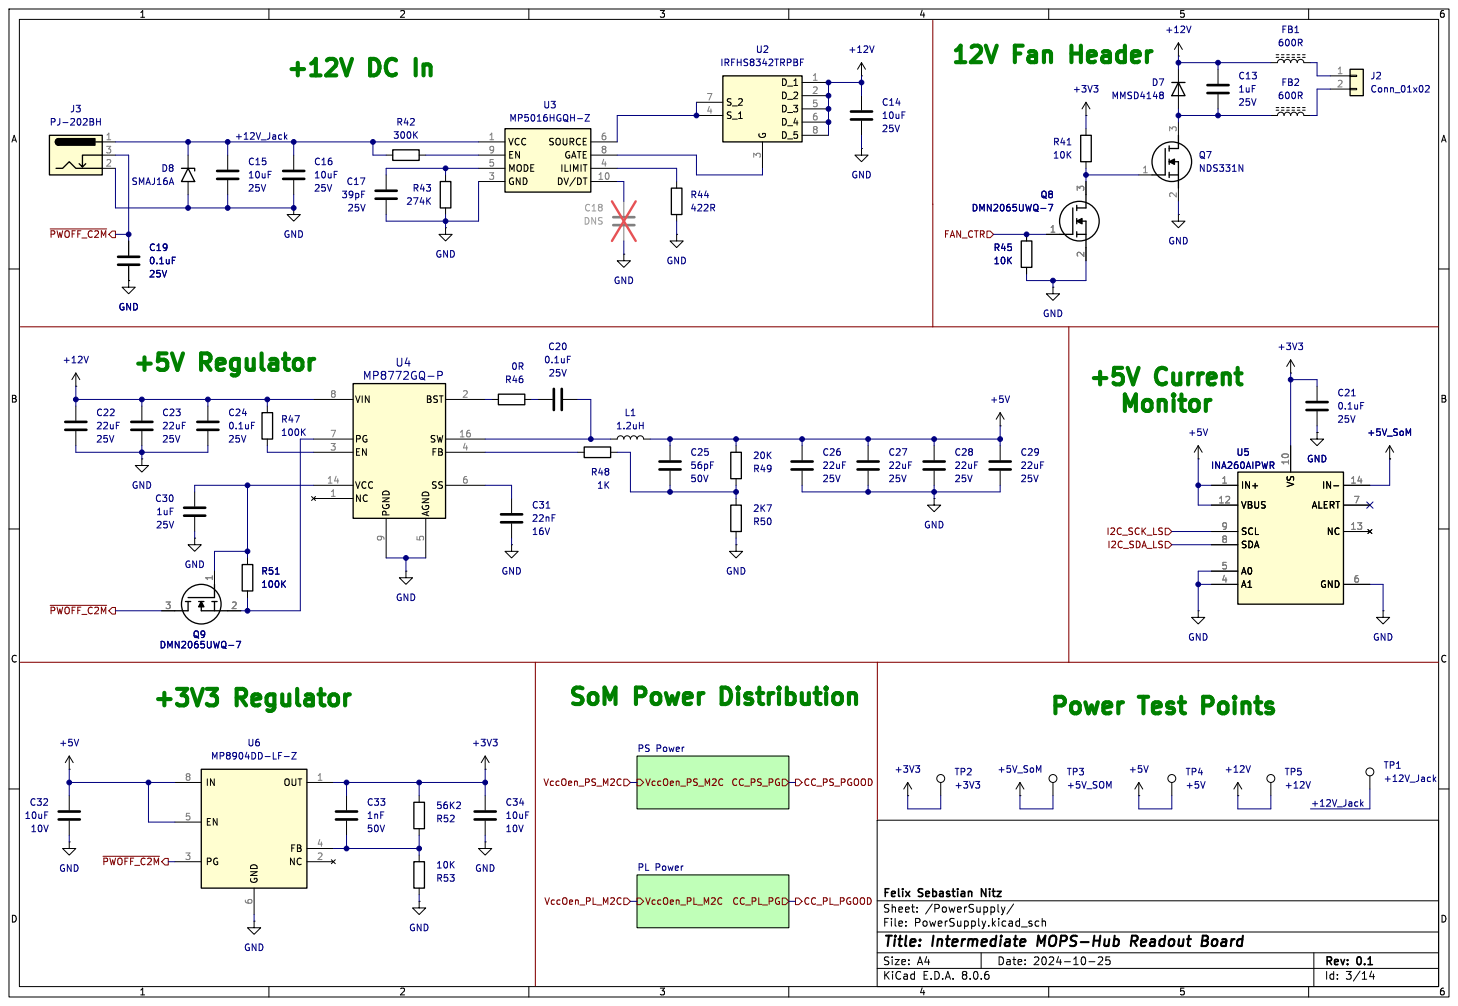
[picture p52: page 3]

5 SS 6 PG 7 VIN 8 PGND

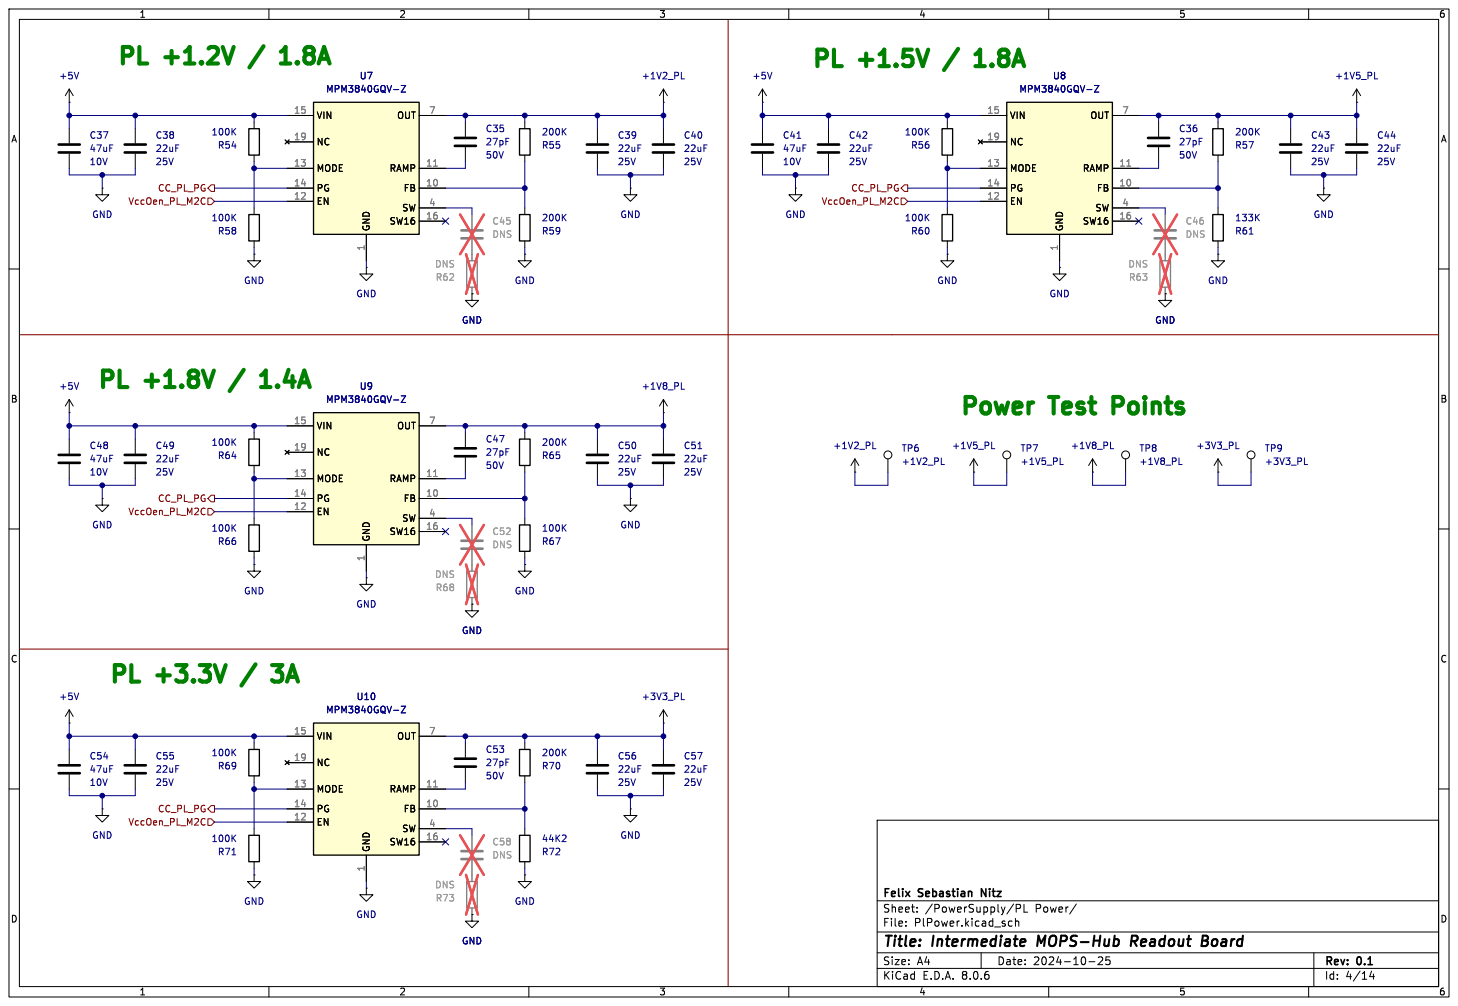
[picture p53: page 4]

1 FB 10 RAMP 11 EN 12 MODE 13 PG 14 VIN 15 SW16 16 NC 19 SW 4 OUT 7 U7 MPM3840GQV-Z R55 C35 200K

1 FB 10 RAMP 11 EN 12 MODE 13 PG 14 VIN 15 SW16 16 NC 19 SW 4 OUT 7 U8 MPM3840GQV-Z
+1V2_PL GND

1 FB 10 RAMP 11 EN 12 MODE 13 PG 14 VIN 15 SW16 16 NC 19 SW 4 OUT 7 R62 DNS R68 DNS GND

1 FB 10 RAMP 11 EN 12 MODE 13 PG 14 VIN 15 SW16 16 NC 19 SW 4 OUT 7 R63 DNS GND GND

1 FB 10 RAMP 11 EN 12 MODE 13 PG 14 VIN 15 SW16 16 NC 19 SW 4 OUT 7 U9 MPM3840GQV-Z R54 C38 100K

1 FB 10 RAMP 11 EN 12 MODE 13 PG 14 VIN 15 SW16 16 NC 19 SW 4 OUT 7 C46 DNS C52 DNS GND

1 FB 10 RAMP 11 EN 12 MODE 13 PG 14 VIN 15 SW16 16 NC 19 SW 4 OUT 7 U10 MPM3840GQV-Z GND

1 FB 10 RAMP 11 EN 12 MODE 13 PG 14 VIN 15 SW16 16 NC 19 SW 4 OUT 7 C58 DNS R73 DNS

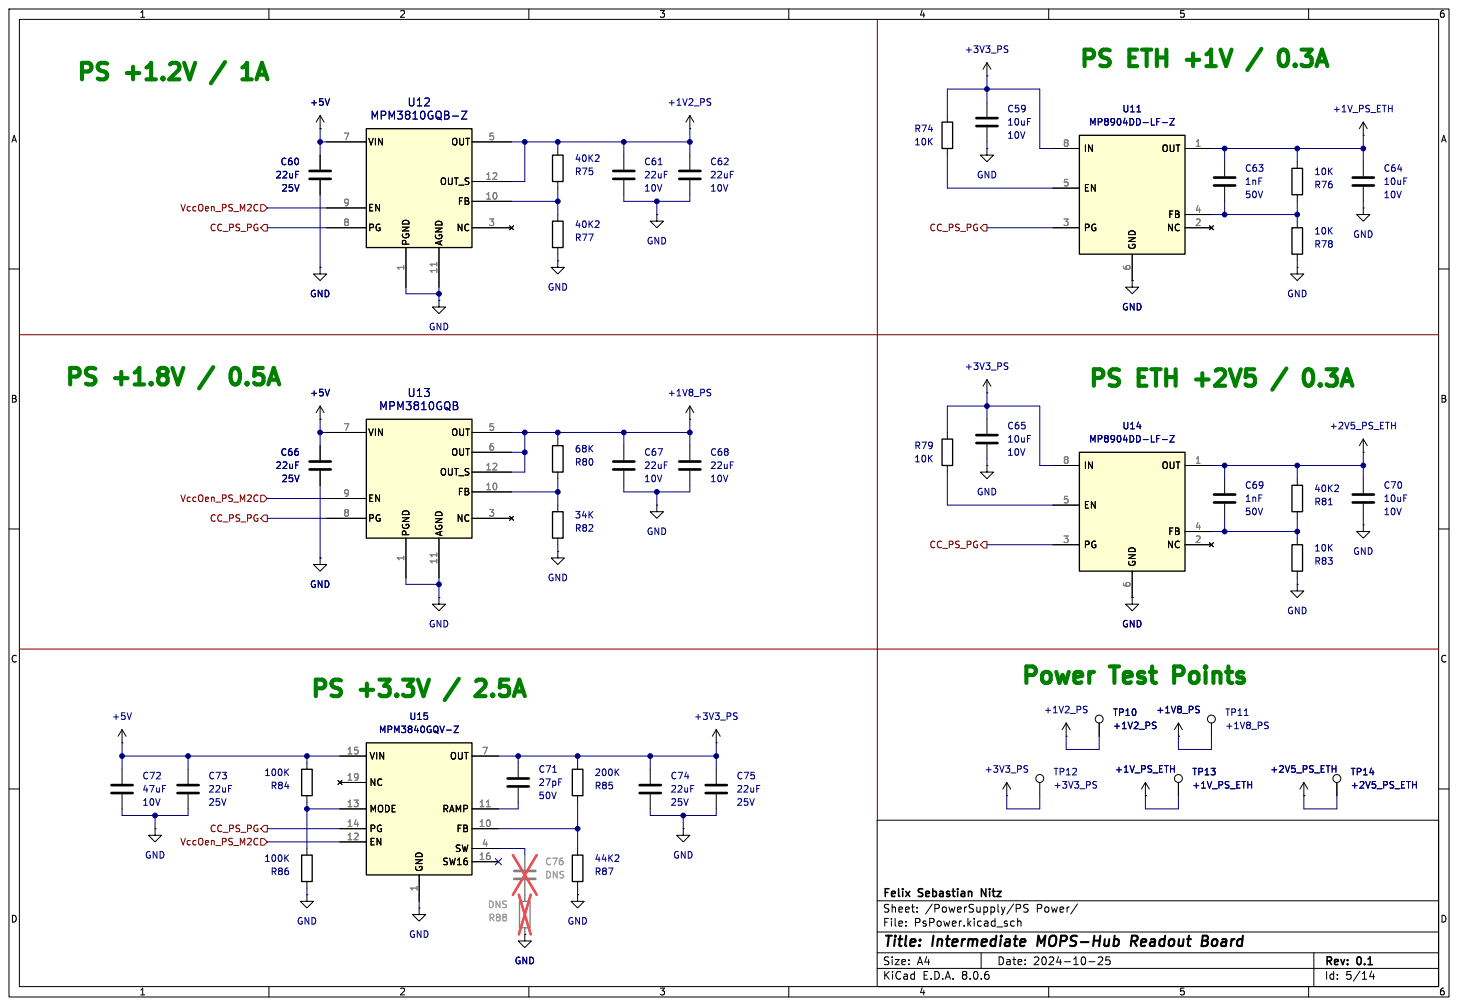
[picture p54: page 5]

1 FB 10 AGND 11 OUT_S 12 NC 3 OUT 5 VIN 7 PG 8 EN 9 U12 MPM3810GQB-Z PGND

1 FB 10 AGND 11 OUT_S 12 NC 3 OUT 5 VIN 7 PG 8 EN 9 GND

1 FB 10 AGND 11 OUT_S 12 NC 3 OUT 5 OUT 6 VIN 7 PG 8 EN 9 U13 MPM3810GQB

1 FB 10 AGND 11 OUT_S 12 NC 3 OUT 5 OUT 6 VIN 7 PG 8 EN 9 GND

1 FB 10 RAMP 11 EN 12 MODE 13 PG 14 VIN 15 SW16 16 NC 19 SW 4 OUT 7 C66

1 FB 10 RAMP 11 EN 12 MODE 13 PG 14 VIN 15 SW16 16 NC 19 SW 4 OUT 7 U15 MPM3840GQV-Z R81

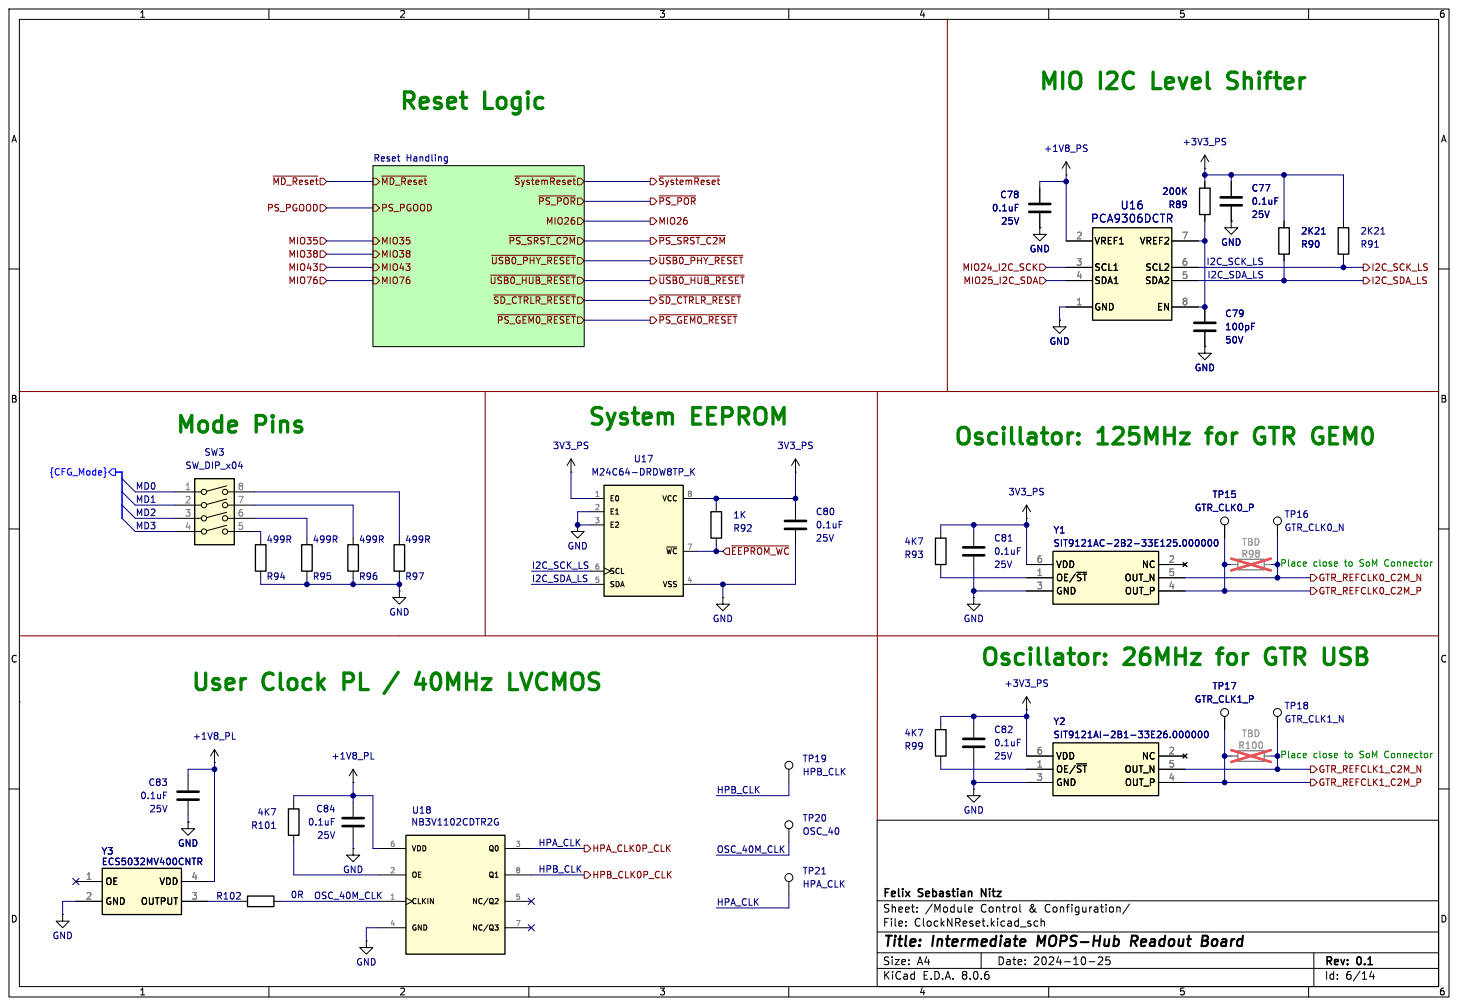
[picture p55: page 6]

Place close to SoM Connector Mode Pins

Place close to SoM Connector System EEPROM

User Clock PL / 40MHz LVCMOS

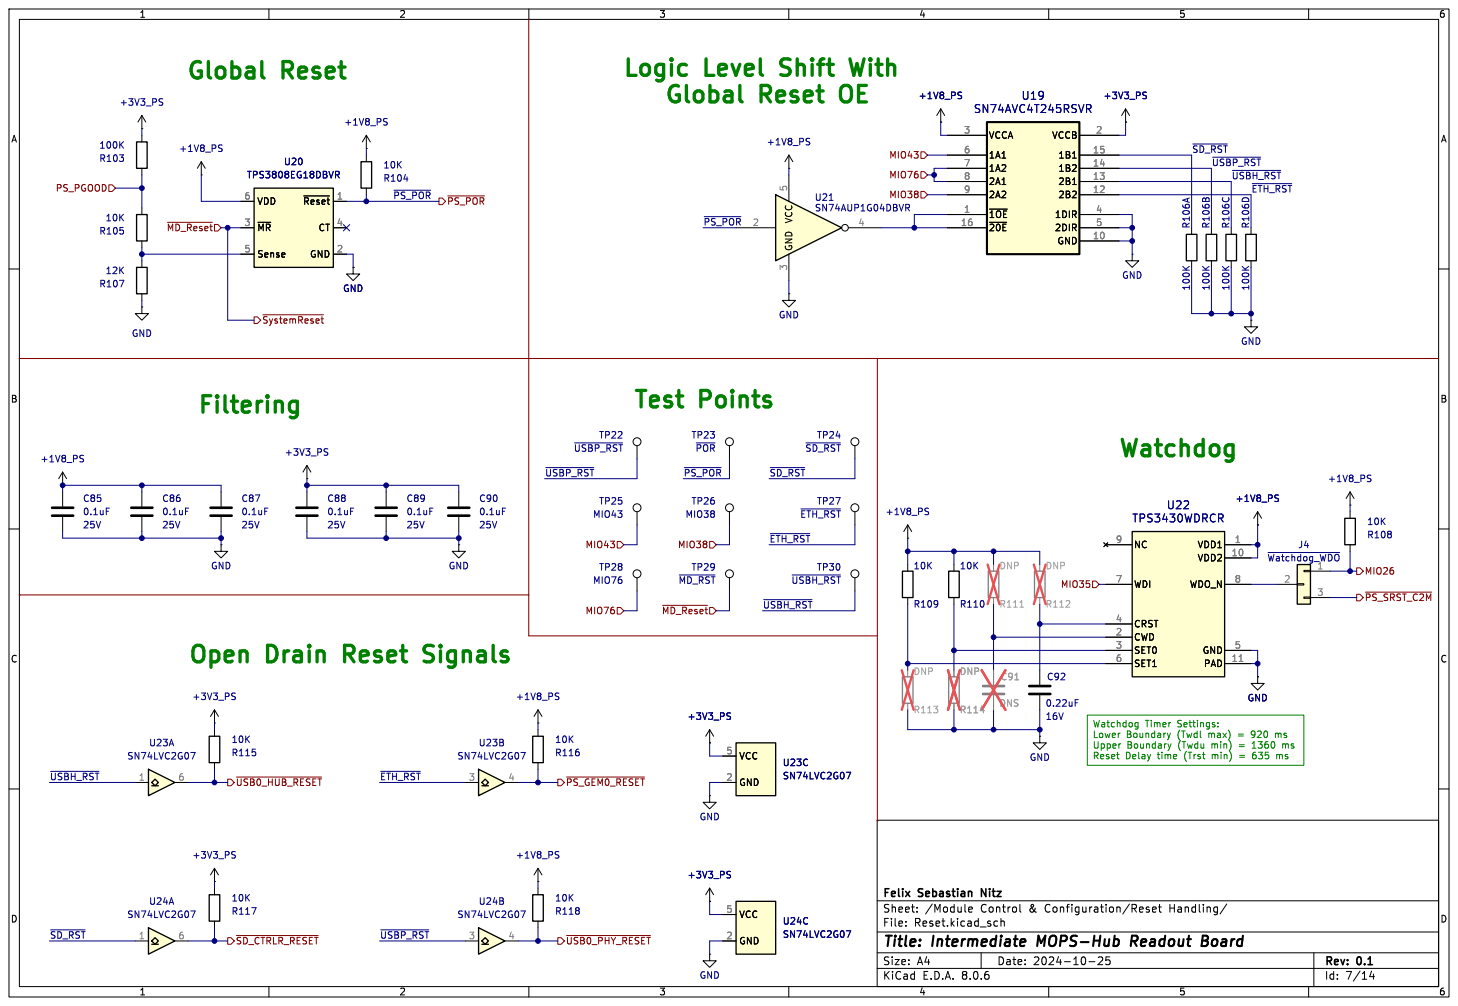
[picture p56: page 7]

Logic Level Shift With
Global Reset OE

Watchdog Timer Settings: Lower Boundary (Twdl max) = 920 ms Upper Boundary (Twdu min) = 1360 ms Reset Delay time (Trst min) = 635 ms U22 TPS3430WDRCR

Open Drain Reset Signals

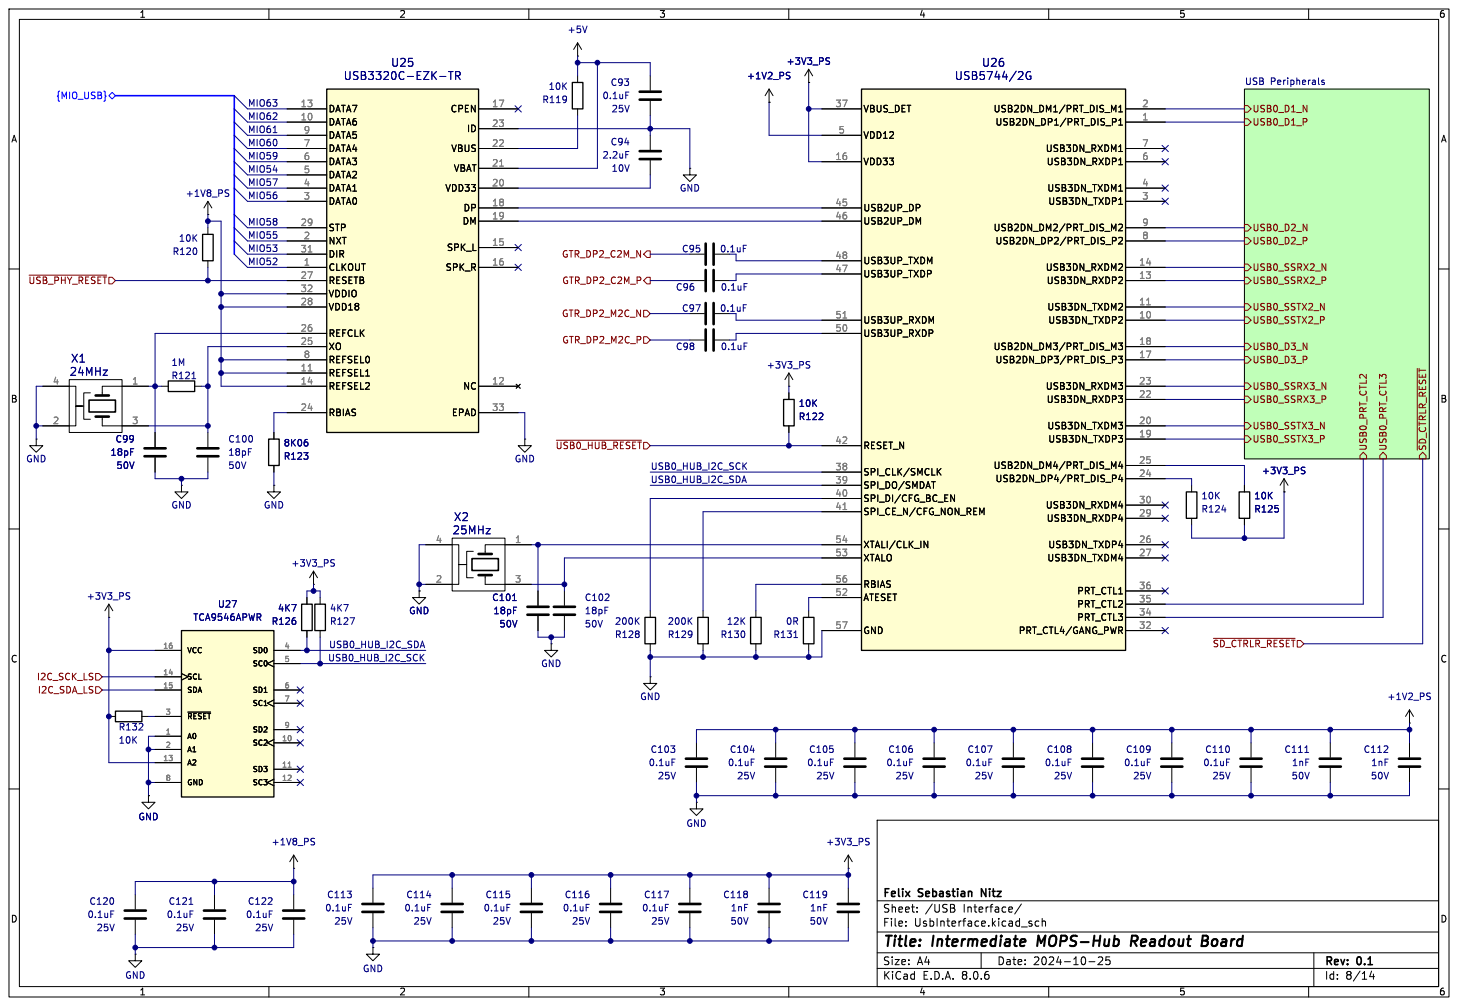
[picture p57: page 8]

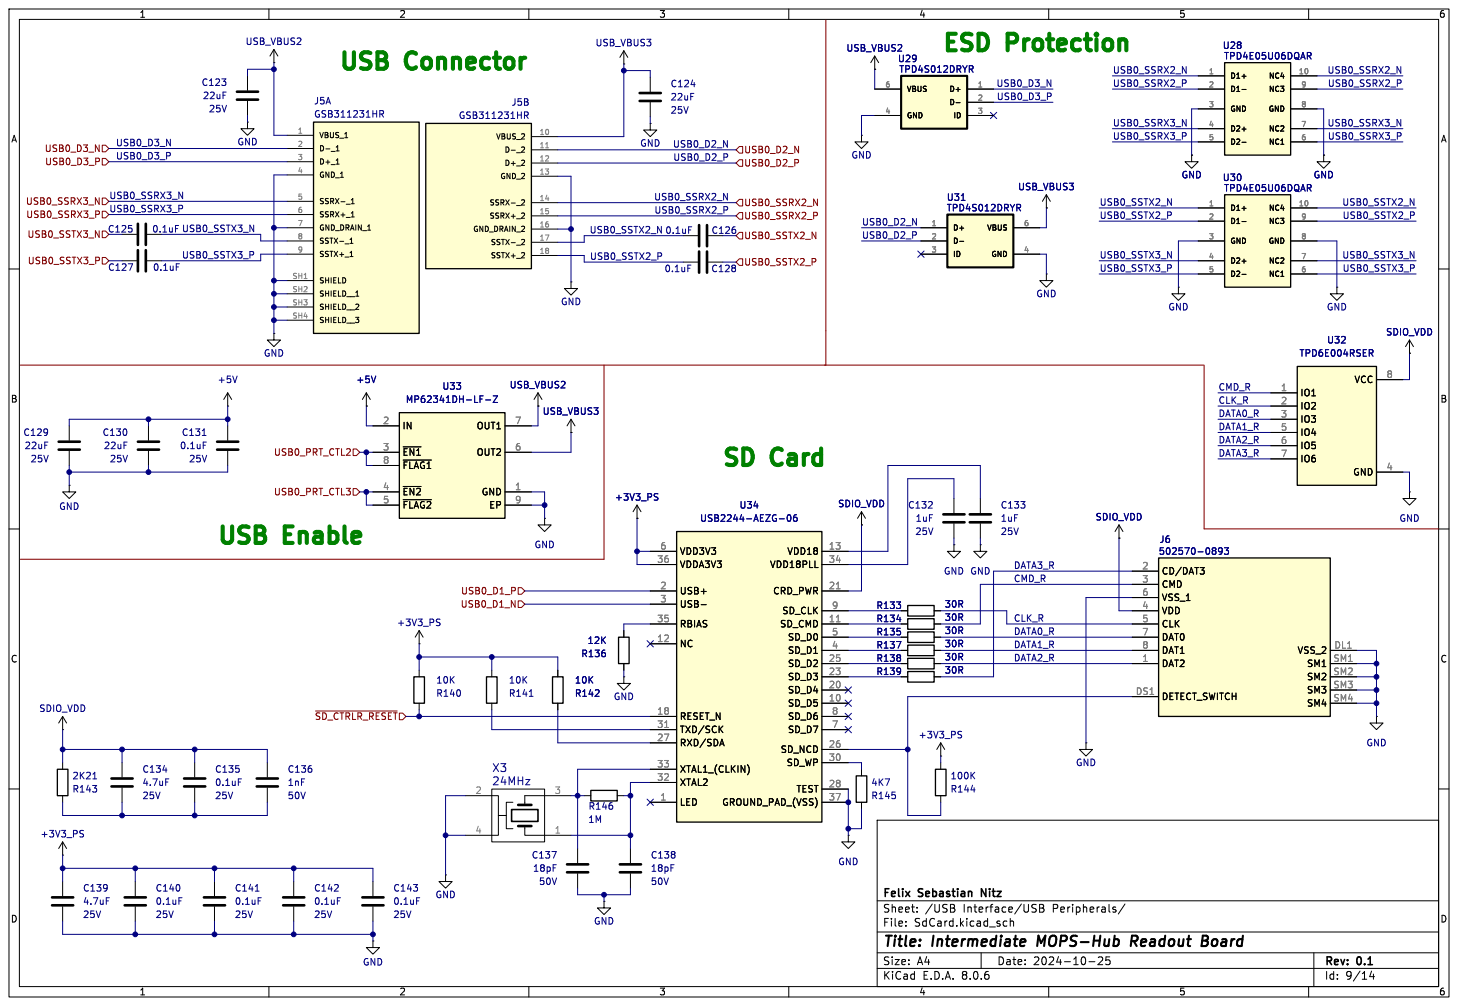
[picture p58: page 9]

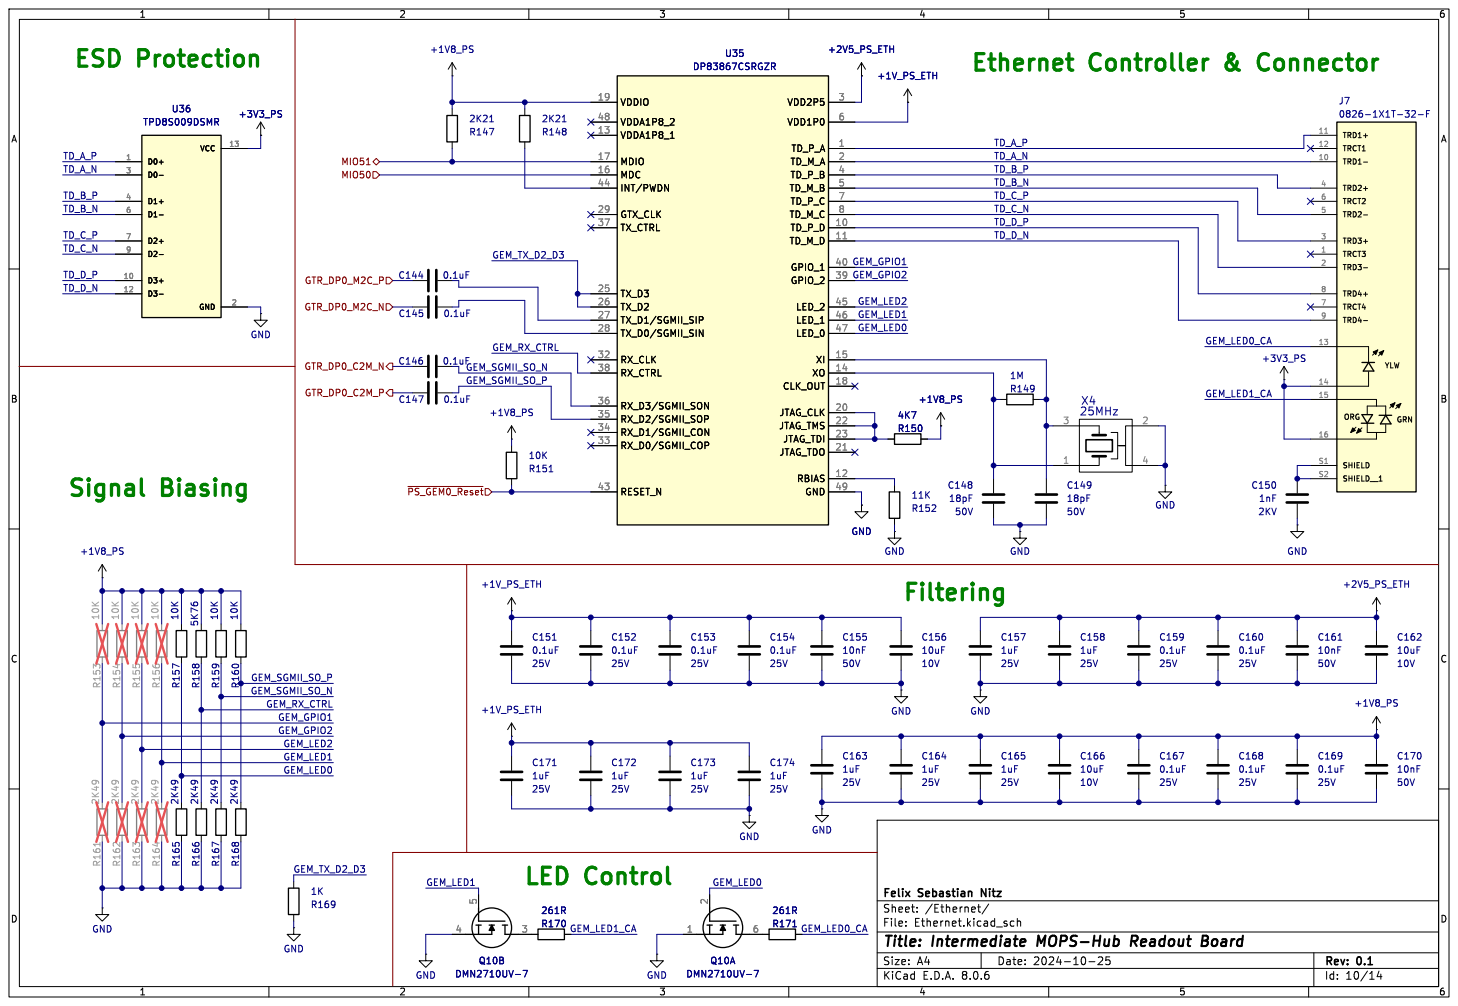
[picture p59: page 10]

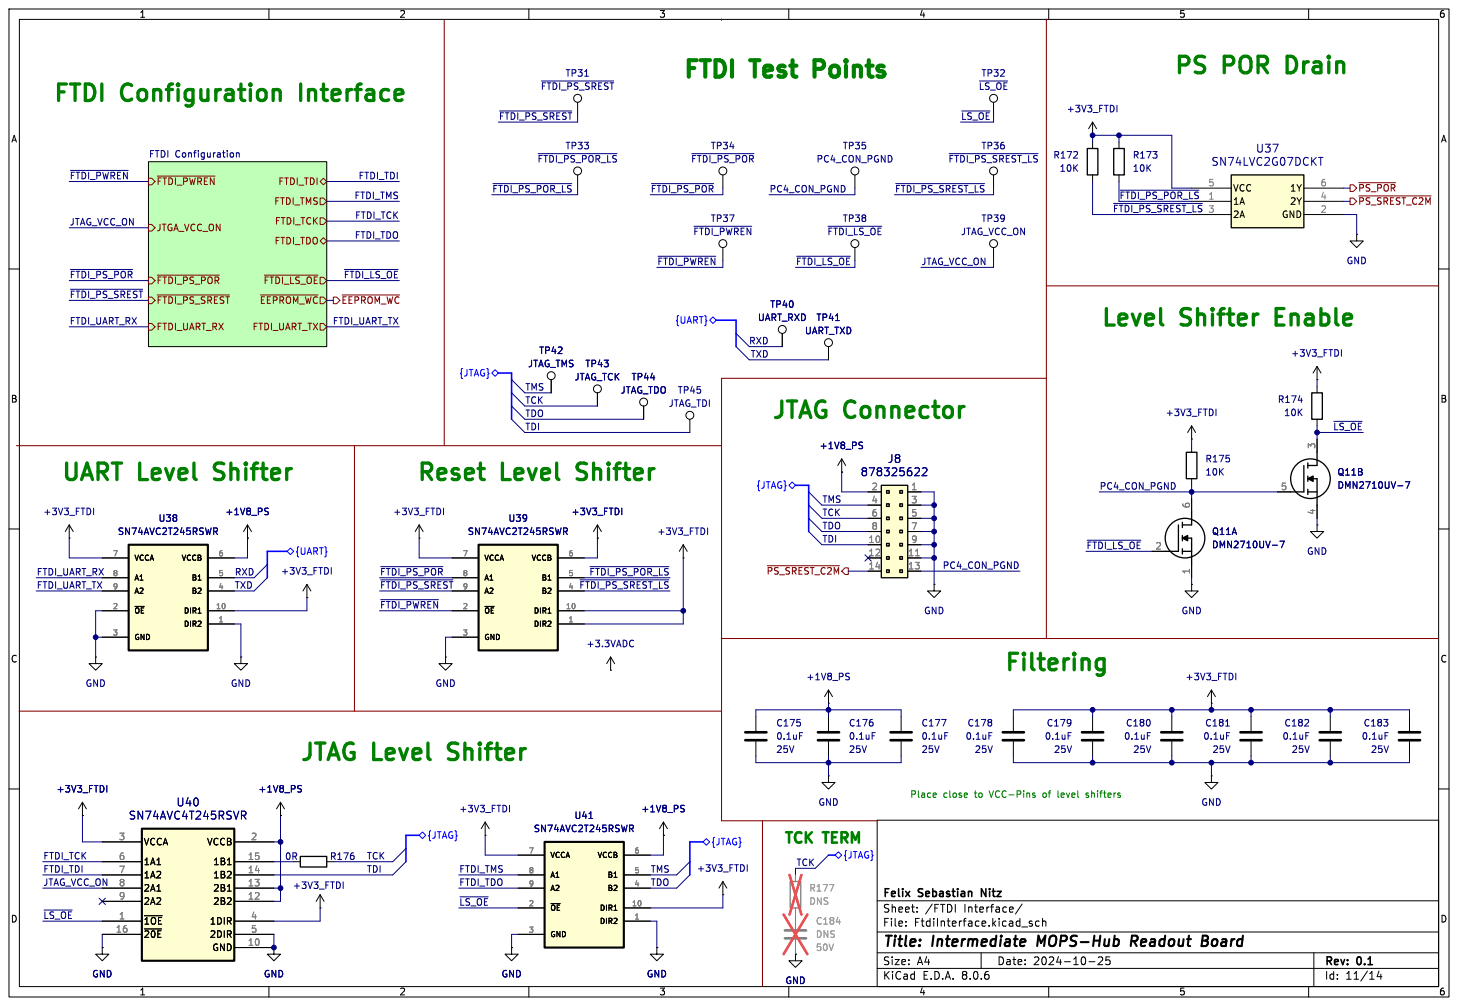
[picture p60: page 11]

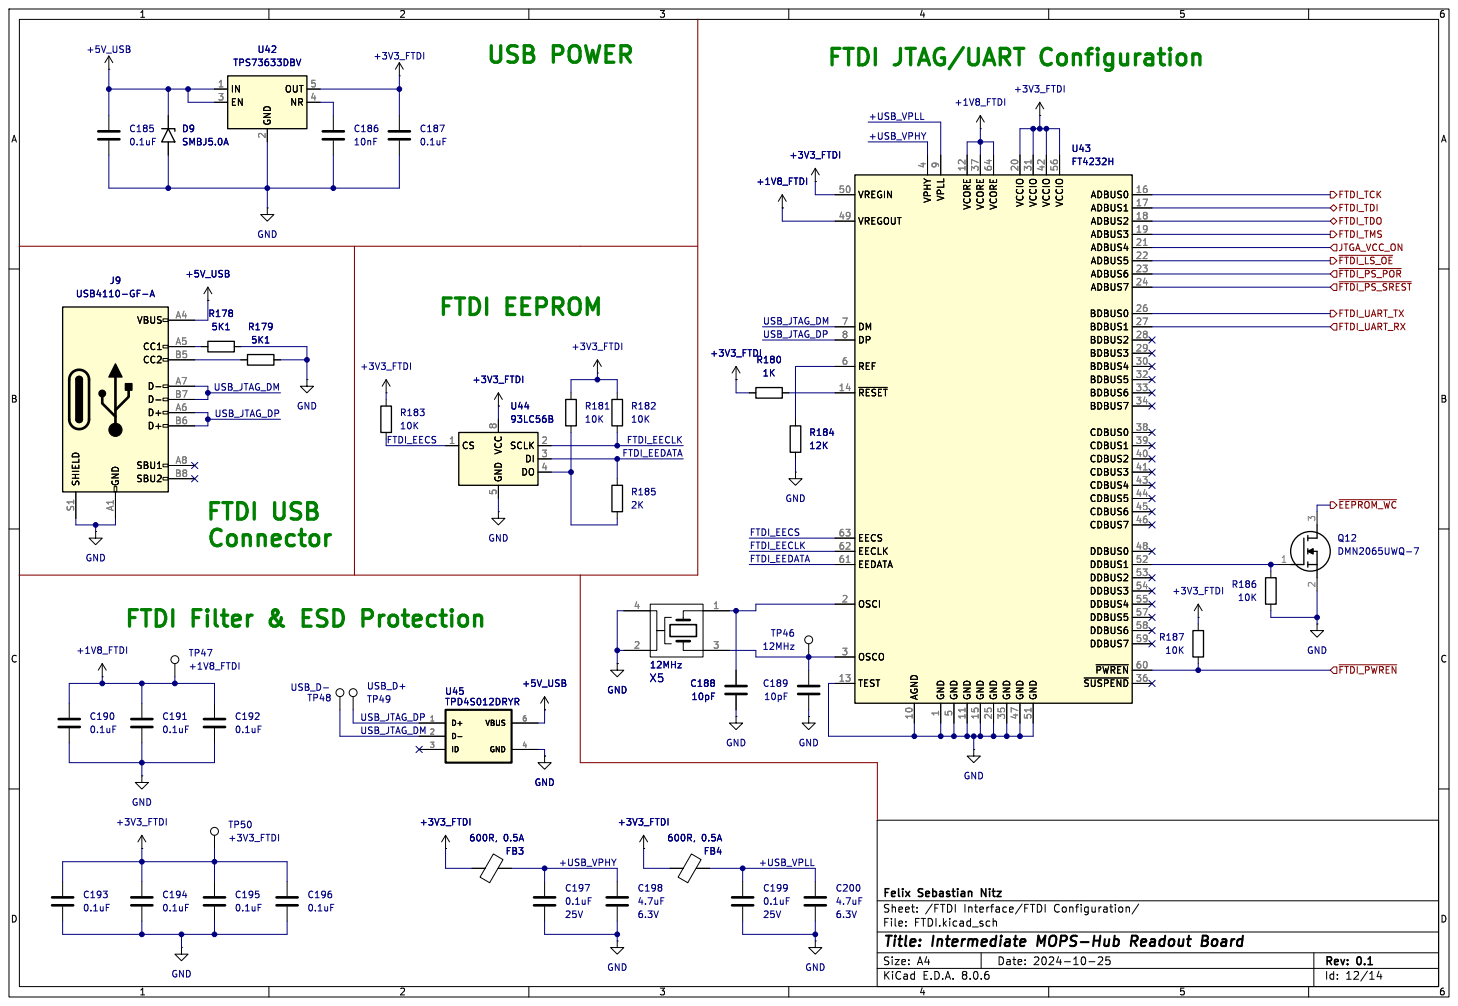
[picture p61: page 12]

2 EN 3 NR 4 OUT 5 U42 TPS73633DBV GND

2 EN 3 NR 4 OUT 5 U43 FT4232H GND

1 AGND 10 GND 11 VCORE 12 TEST 13 ~{RESET} 14 GND 15 ADBUS0 16 ADBUS1 17 ADBUS2 18 ADBUS3 19 OSCI 2 VCCIO 20 ADBUS4 21 ADBUS5 22 ADBUS6 23 ADBUS7 24 GND 25 BDBUS0 26 BDBUS1 27 BDBUS2 28 BDBUS3 29 OSCO 3 BDBUS4 30 VCCIO 31 BDBUS5 32 BDBUS6 33 BDBUS7 34 GND 35

4 CDBUS2 40 CDBUS3 41 VCCIO 42 CDBUS4 43 CDBUS5 44 CDBUS6 45 CDBUS7 46 GND 47 DDBUS0 48 VREGOUT 49 GND

5 VREGIN 50 GND 51 DDBUS1 52 DDBUS2 53 DDBUS3 54 DDBUS4 55 VCCIO 56 DDBUS5 57 DDBUS6 58 DDBUS7 59 REF 6 ~{PWREN}60 EEDATA 61 EECLK 62 EECS 63 VCORE 64 DM 7 DP 8 VPLL

FTDI Filter & ESD Protection

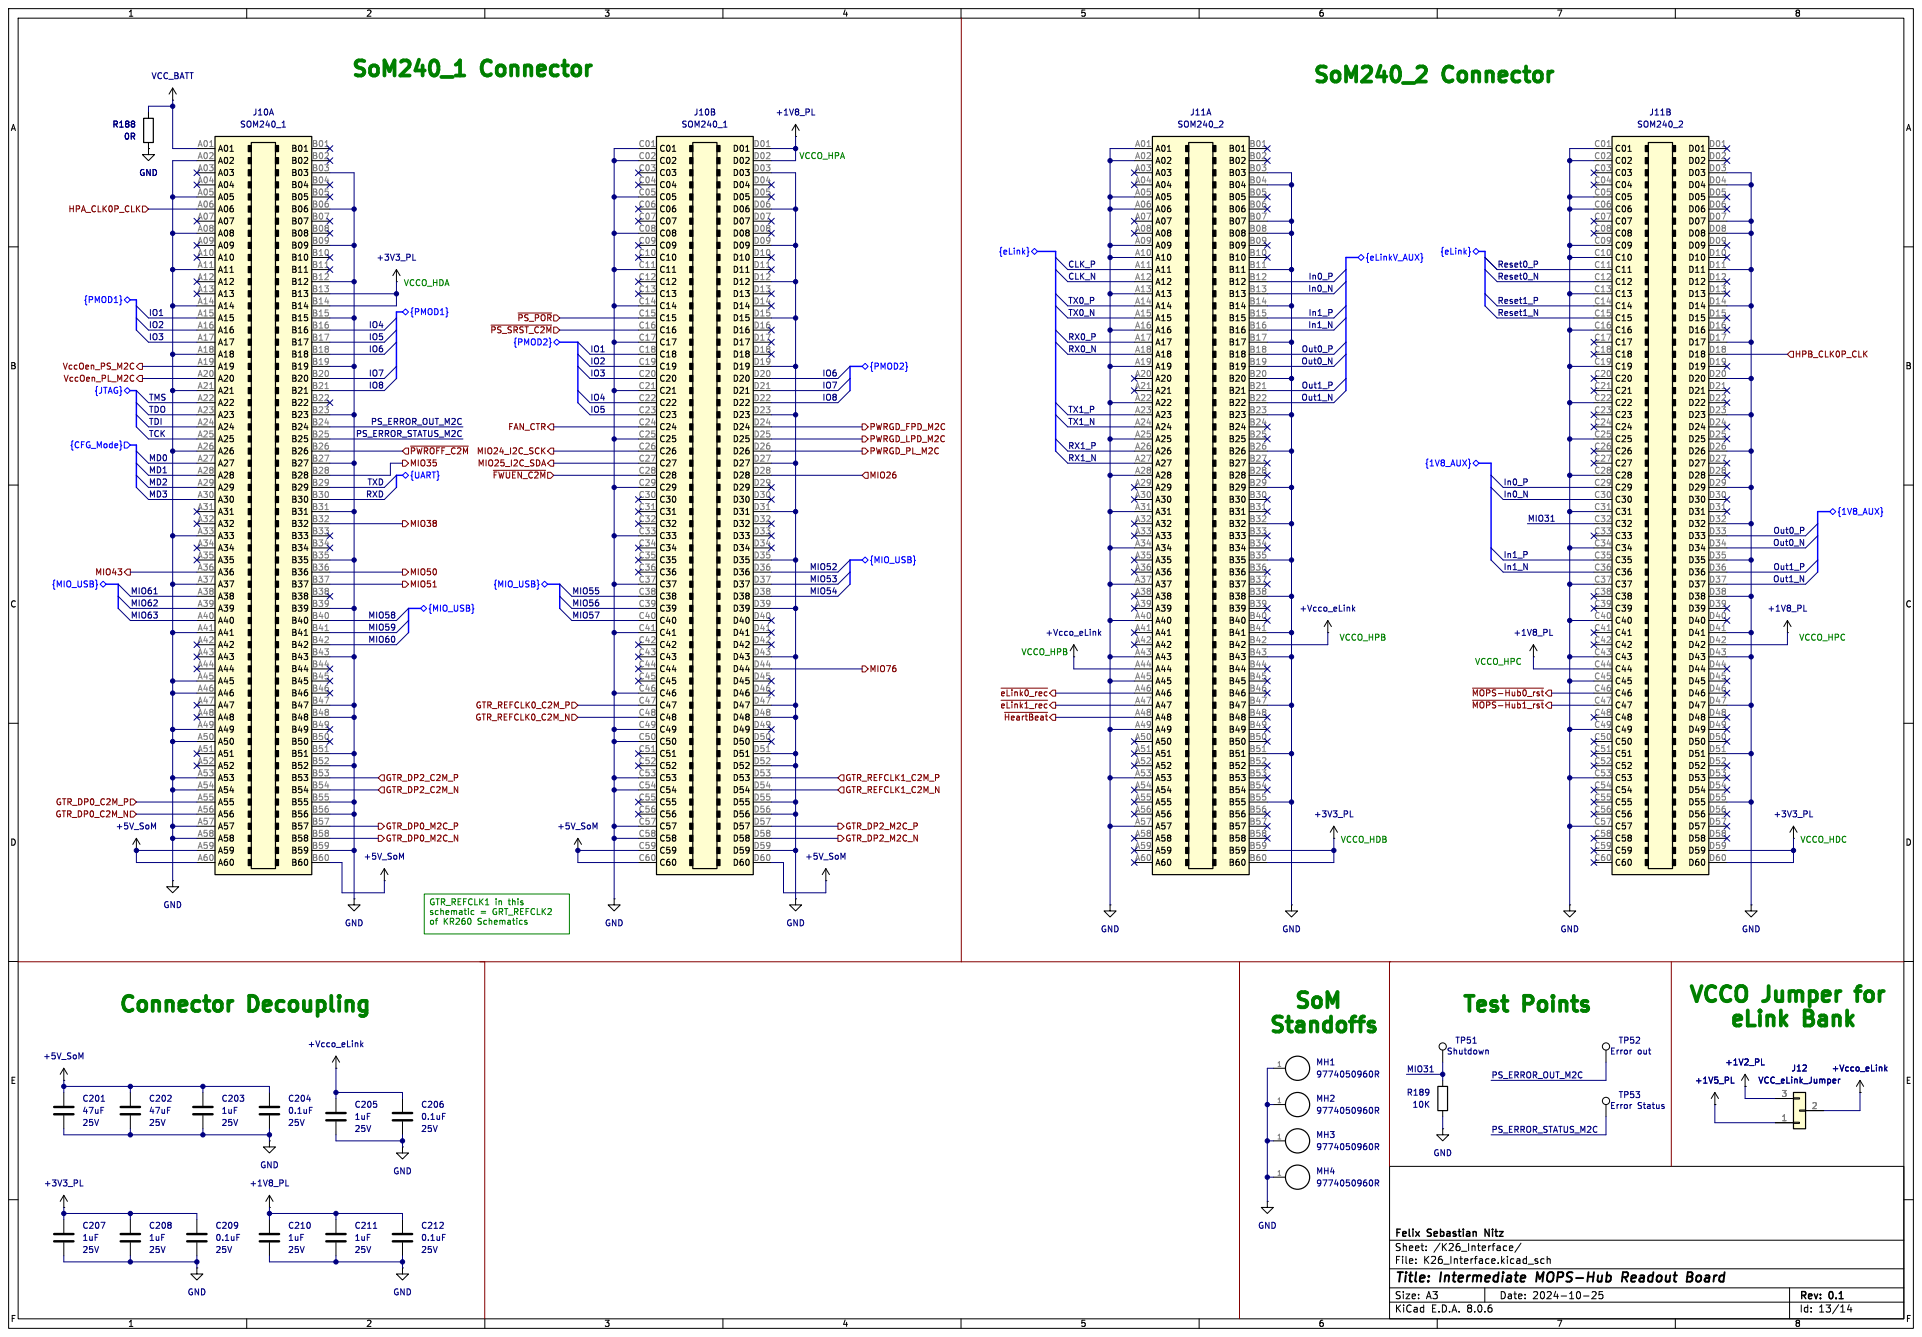
[picture p62: page 13]

TP52 Error out TP53 Error Status TP51 Shutdown

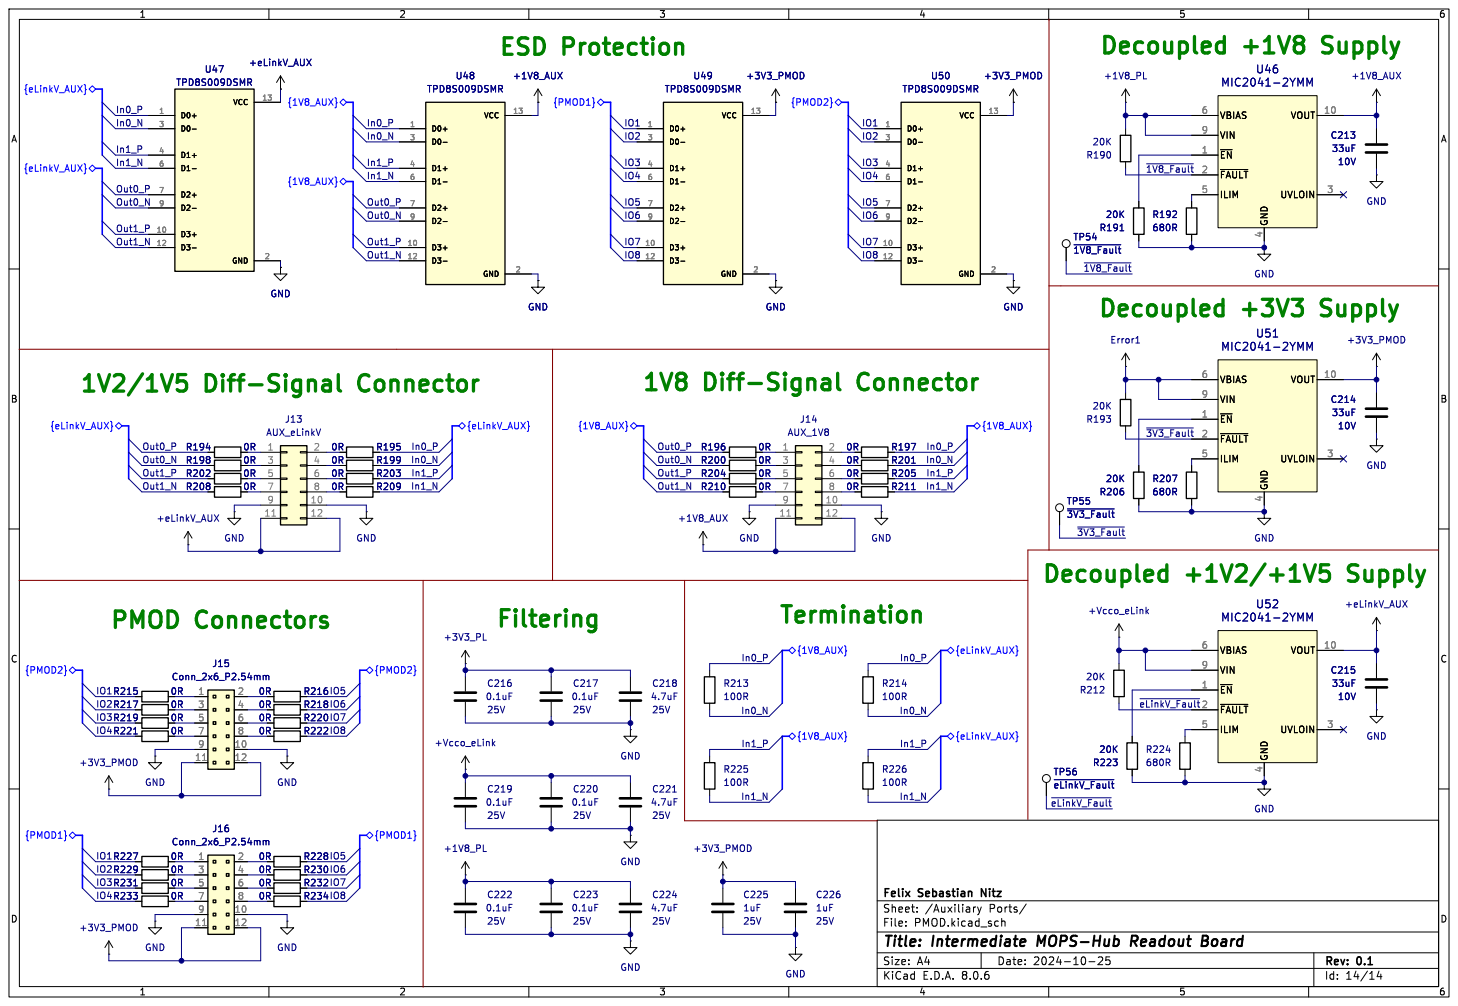
[picture p63: page 14]
