fsnitz/ATLAS-ITk-MOPS-Hub-readout-prototype/Miscellaneous/BlockDesignPrints/PLtoPS_BD.pdf

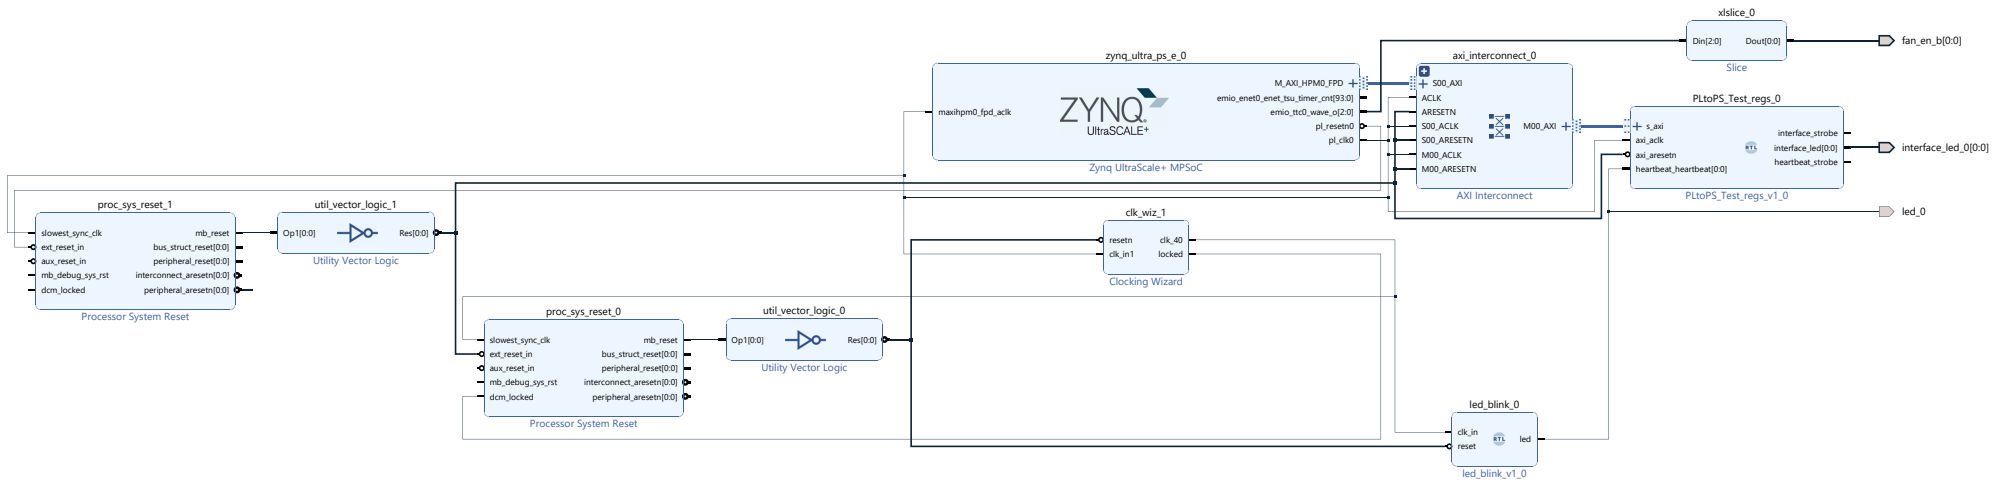
[picture p64: page 1]
PLtoPS_Test_regs_0 PLtoPS_Test_regs_v1_0 s_axi axi_aclk axi_aresetn; interface_strobe interface_led[0:0] heartbeat_strobe heartbeat_heartbeat[0:0] axi_interconnect_0 AXI Interconnect S00_AXI; M00_AXI ACLK ARESETN S00_ACLK S00_ARESETN M00_ACLK M00_ARESETN clk_wiz_1 Clocking Wizard resetn clk_in1; clk_40 locked; fan_en_b[0:0] interface_led_0[0:0] led_blink_0 led_blink_v1_0 clk_in reset; led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
