fsnitz/ATLAS-ITk-MOPS-Hub-readout-prototype/Hardware/KR260eLinkHat/rev02/KR260eLinkHatSchematics_Rev02.pdf

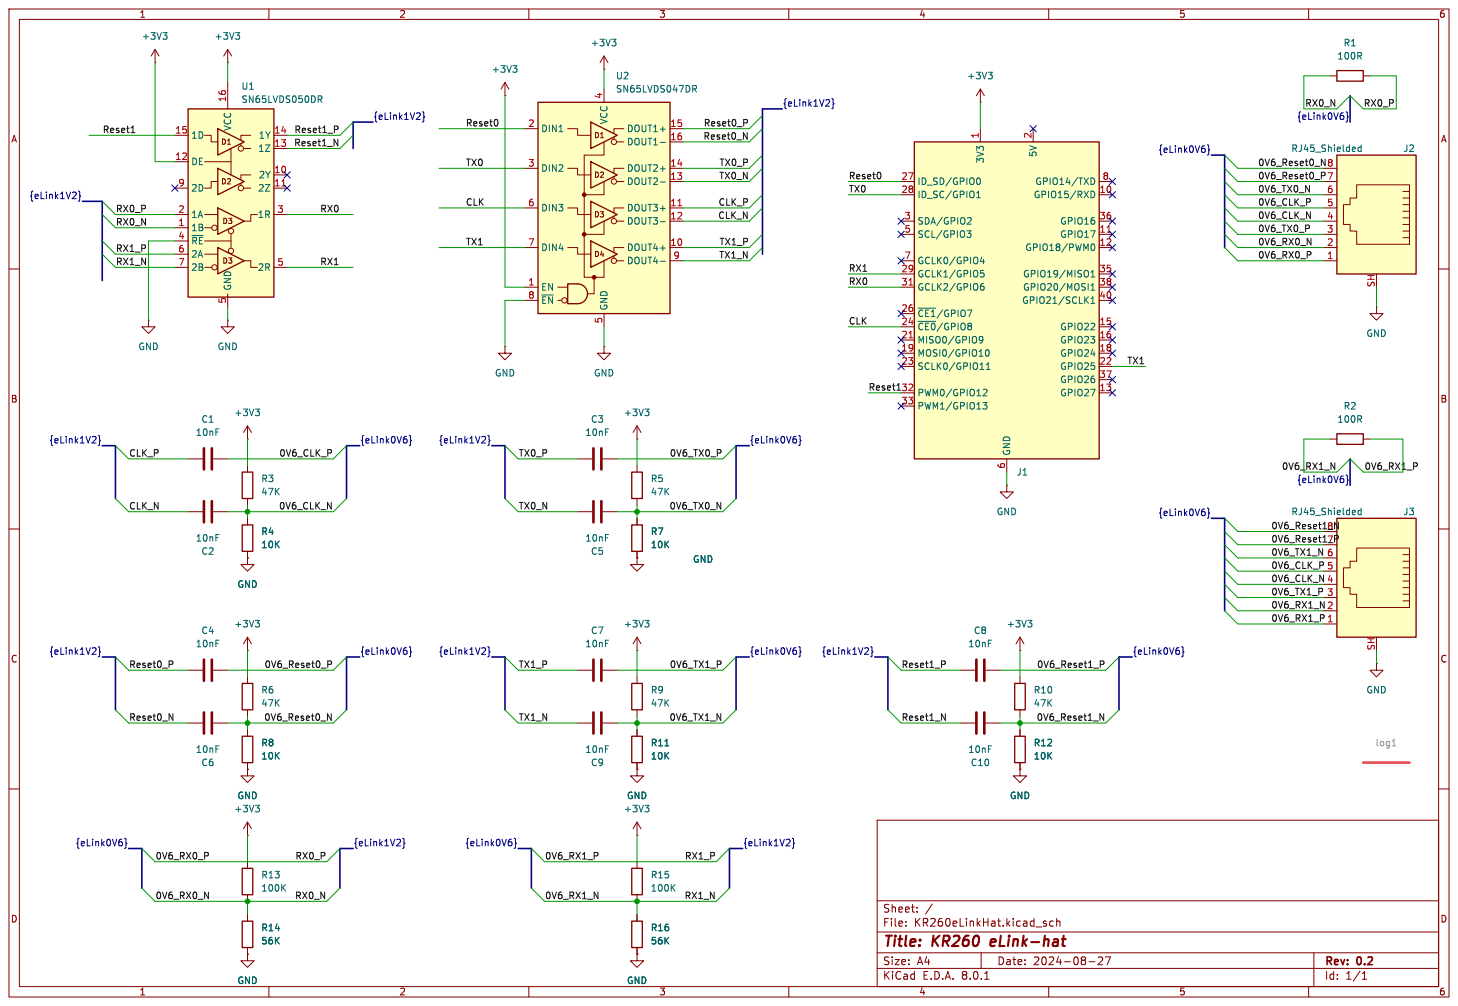
[picture p65: page 1]

Id: 1/1 Title: KR260 eLink-hat File: KR260eLinkHat.kicad_sch Sheet: / GND
