fsnitz/ATLAS-ITk-MOPS-Hub-readout-prototype/Miscellaneous/BlockDesignPrints/eLink0.pdf

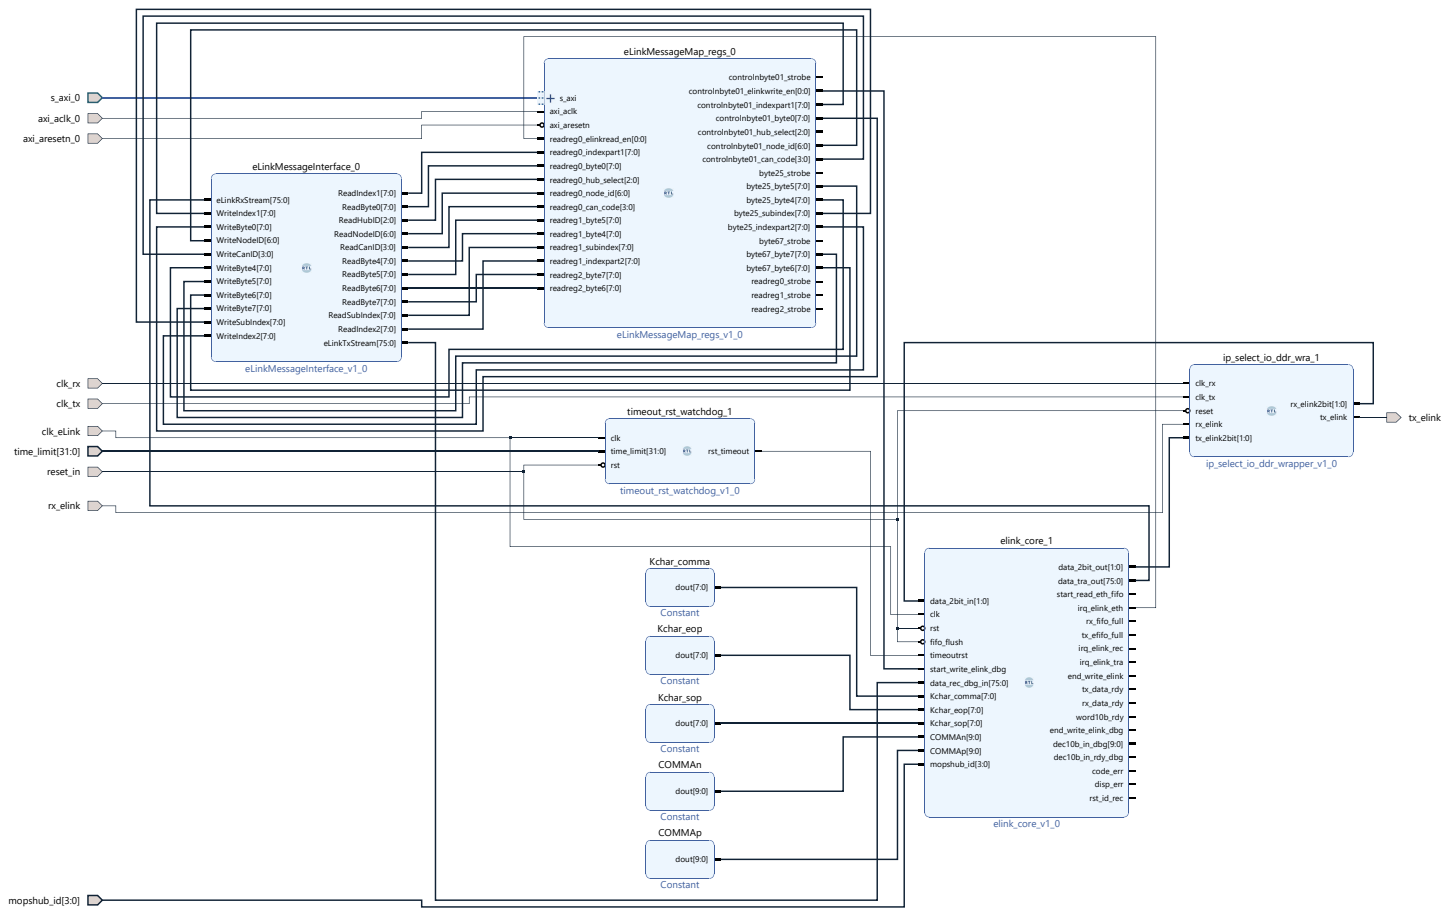
[picture p66: page 1]
s_axi_0 axi_aclk_0 axi_aresetn_0 clk_rx clk_tx clk_eLink time_limit[31:0] reset_in rx_elink mopshub_id[3:0]; eLinkMessageInterface_0 eLinkMessageInterface_v1_0 eLinkRxStream[75:0]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
