fsnitz/ATLAS-ITk-MOPS-Hub-readout-prototype/Miscellaneous/BlockDesignPrints/eLinkStrippedBD.pdf

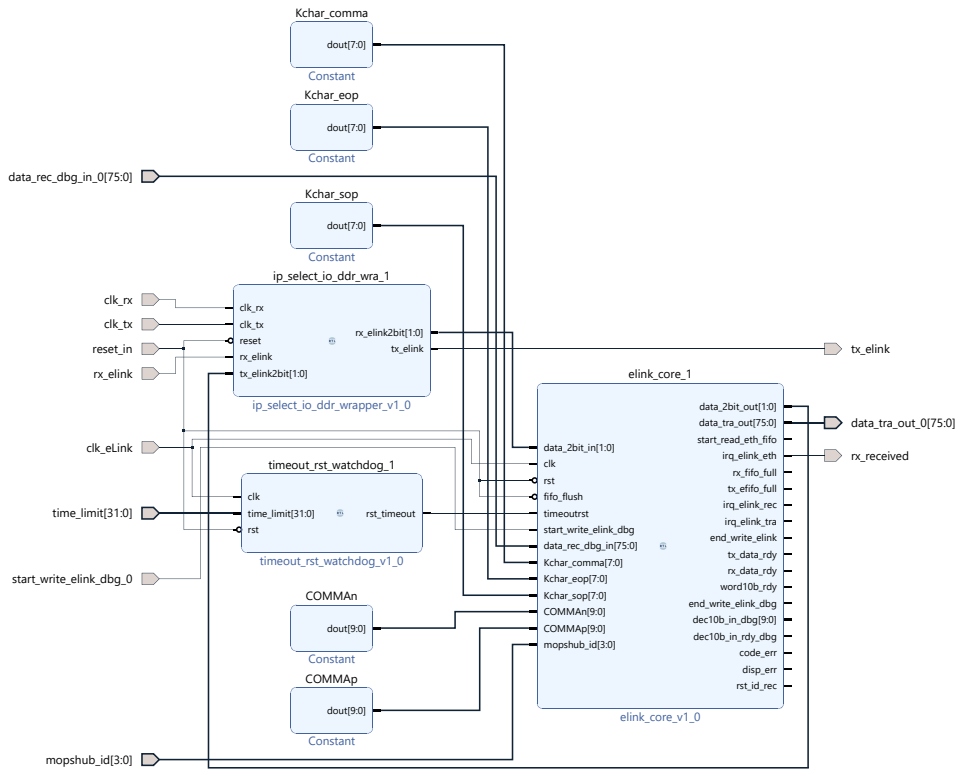
[picture p67: page 1]
data_rec_dbg_in_0[75:0] clk_rx clk_tx reset_in rx_elink clk_eLink time_limit[31:0] start_write_elink_dbg_0 mopshub_id[3:0]; Kchar_comma Constant dout[7:0] Kchar_eop Constant dout[7:0] Kchar_sop Constant dout[7:0] ip_select_io_ddr_wra_1 ip_select_io_ddr_wrapper_v1_0 clk_rx clk_tx reset rx_elink; rx_elink2bit[1:0] tx_elink2bit[1:0]; tx_elink timeout_rst_watchdog_1 timeout_rst_watchdog_v1_0 clk time_limit[31:0] rst; rst_timeout COMMAn Constant dout[9:0] COMMAp Constant dout[9:0]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
