fsnitz/ATLAS-ITk-MOPS-Hub-readout-prototype/Miscellaneous/BlockDesignPrints/eLinkTestBD.pdf

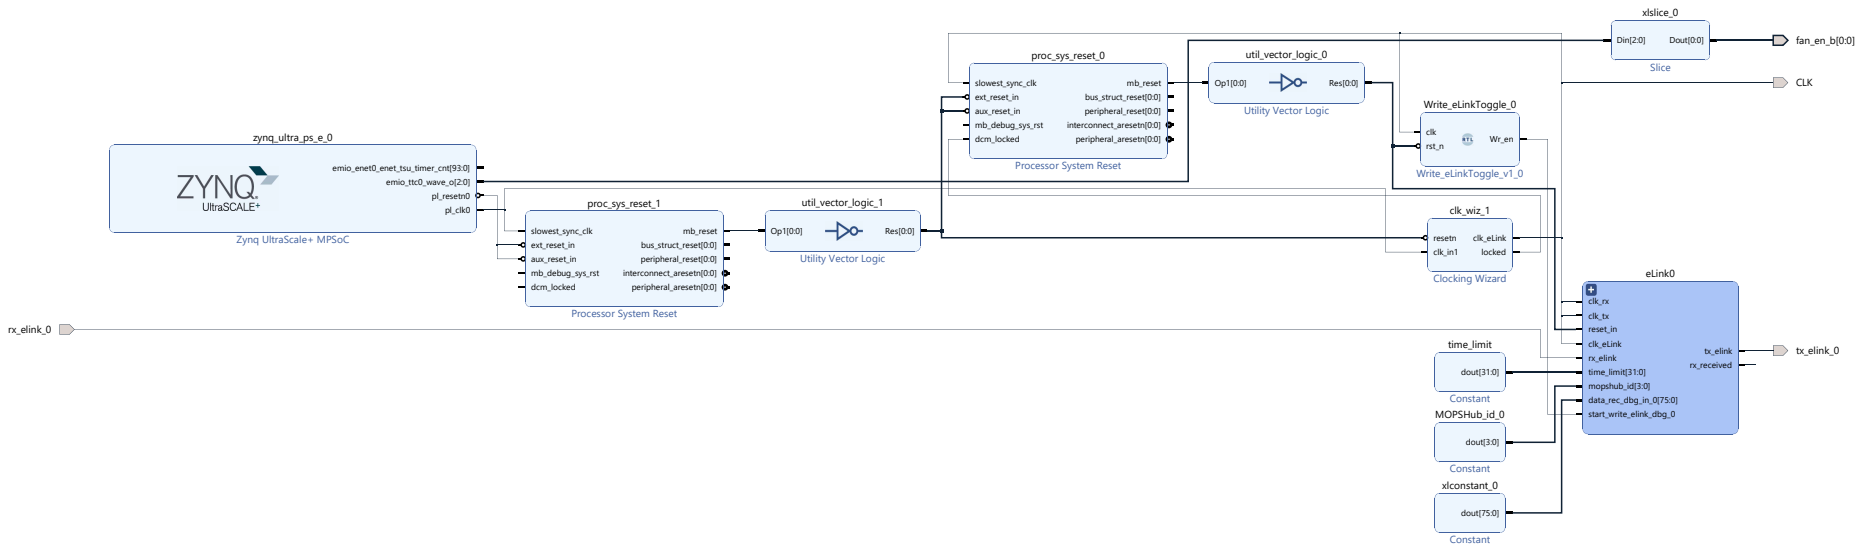
[picture p68: page 1]
MOPSHub_id_0 Constant dout[3:0] Write_eLinkToggle_0 Write_eLinkToggle_v1_0 clk rst_n; Wr_en clk_wiz_1 Clocking Wizard resetn clk_in1; clk_eLink locked; eLink0; tx_elink clk_rx clk_tx reset_in clk_eLink rx_elink time_limit[31:0] mopshub_id[3:0] data_rec_dbg_in_0[75:0] start_write_elink_dbg_0; rx_received; fan_en_b[0:0] CLK rx_elink_0; tx_elink_0 proc_sys_reset_0 Processor System Reset slowest_sync_clk ext_reset_in aux_reset_in mb_debug_sys_rst dcm_locked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
