fsnitz/ATLAS-ITk-MOPS-Hub-readout-prototype/Miscellaneous/BlockDesignPrints/eLinkTestBDAlt2.pdf

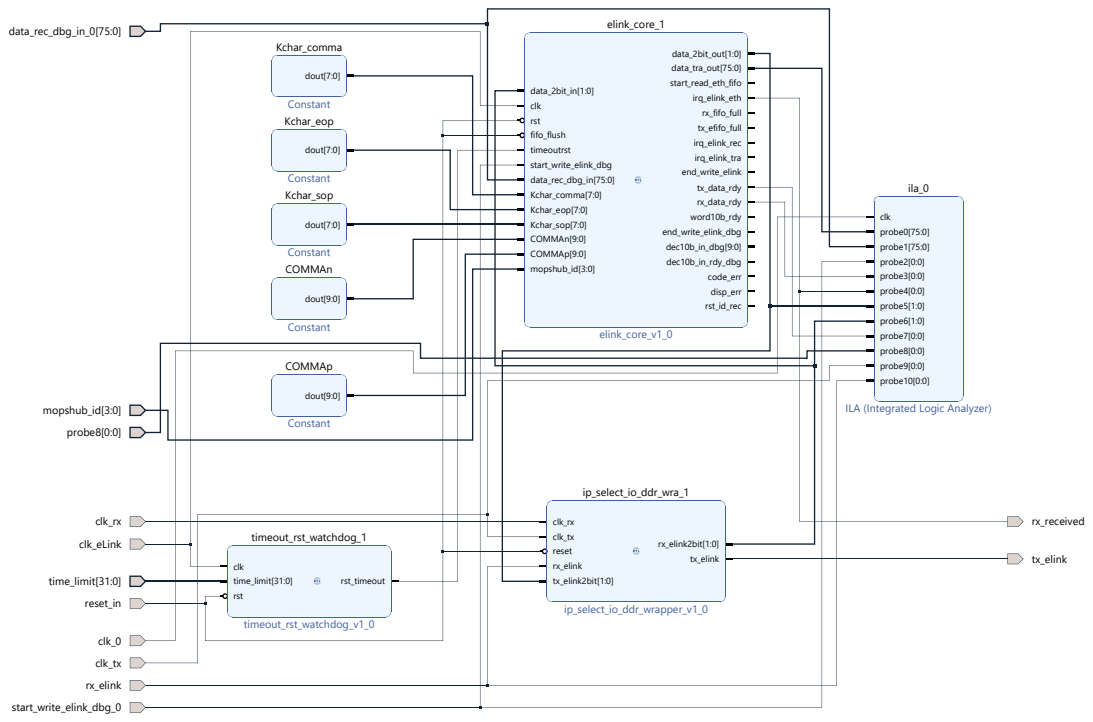
[picture p69: page 1]
data_rec_dbg_in_0[75:0] mopshub_id[3:0] probe8[0:0] clk_rx clk_eLink time_limit[31:0] reset_in clk_0 clk_tx rx_elink start_write_elink_dbg_0; Kchar_comma Constant dout[7:0] Kchar_eop Constant dout[7:0] Kchar_sop Constant dout[7:0] COMMAn Constant dout[9:0] COMMAp Constant dout[9:0] timeout_rst_watchdog_1 timeout_rst_watchdog_v1_0 clk time_limit[31:0] rst; rst_timeout; elink_core_1 elink_core_v1_0 data_2bit_in[1:0]; data_2bit_out[1:0] data_tra_out[75:0] start_read_eth_fifo irq_elink_eth clk rst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
