fsnitz/ATLAS-ITk-MOPS-Hub-readout-prototype/Miscellaneous/BlockDesignPrints/InitialBD.pdf

### gig_ethernet_pcs_pma_0

### sfp_0

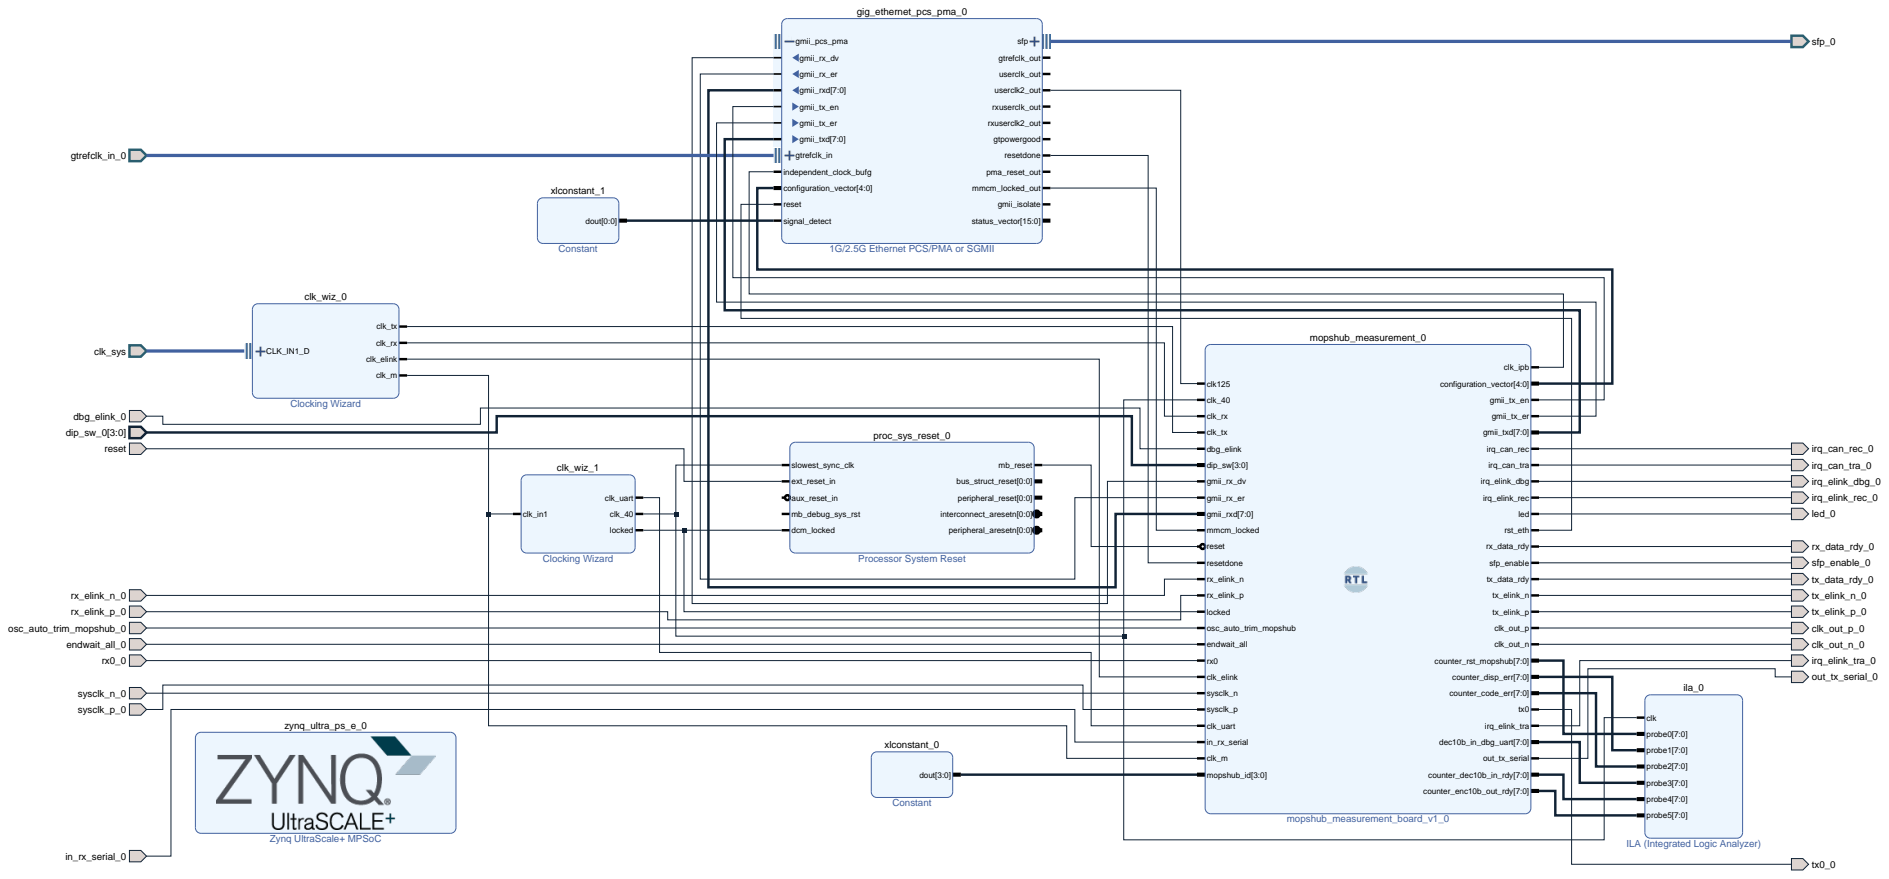
[picture p71: page 1]
gtrefclk_in_0; clk_sys; dbg_elink_0 dip_sw_0[3:0] reset; rx_elink_n_0 rx_elink_p_0 osc_auto_trim_mopshub_0 endwait_all_0 rx0_0; sysclk_n_0 sysclk_p_0; in_rx_serial_0; clk_wiz_0; Clocking Wizard; CLK_IN1_D; clk_tx; clk_rx; clk_elink; clk_m; zynq_ultra_ps_e_0; xlconstant_1; Constant; dout[0:0]; clk_wiz_1; clk_in1; clk_uart; clk_40; locked; gmii_pcs_pma; gmii_rx_dv; gmii_rx_er; gmii_rxd[7:0]; gmii_tx_en; gmii_tx_er; gmii_txd[7:0]; sfp; gtrefclk_in; gtrefclk_out; independent_clock_bufg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

1G/2.5G Ethernet PCS/PMA or SGMII

Processor System Reset

Zynq UltraScale+ MPSoC

ILA (Integrated Logic Analyzer)
