fsnitz/ATLAS-ITk-MOPS-Hub-readout-prototype/Miscellaneous/BlockDesignPrints/InitialBDstripped.pdf

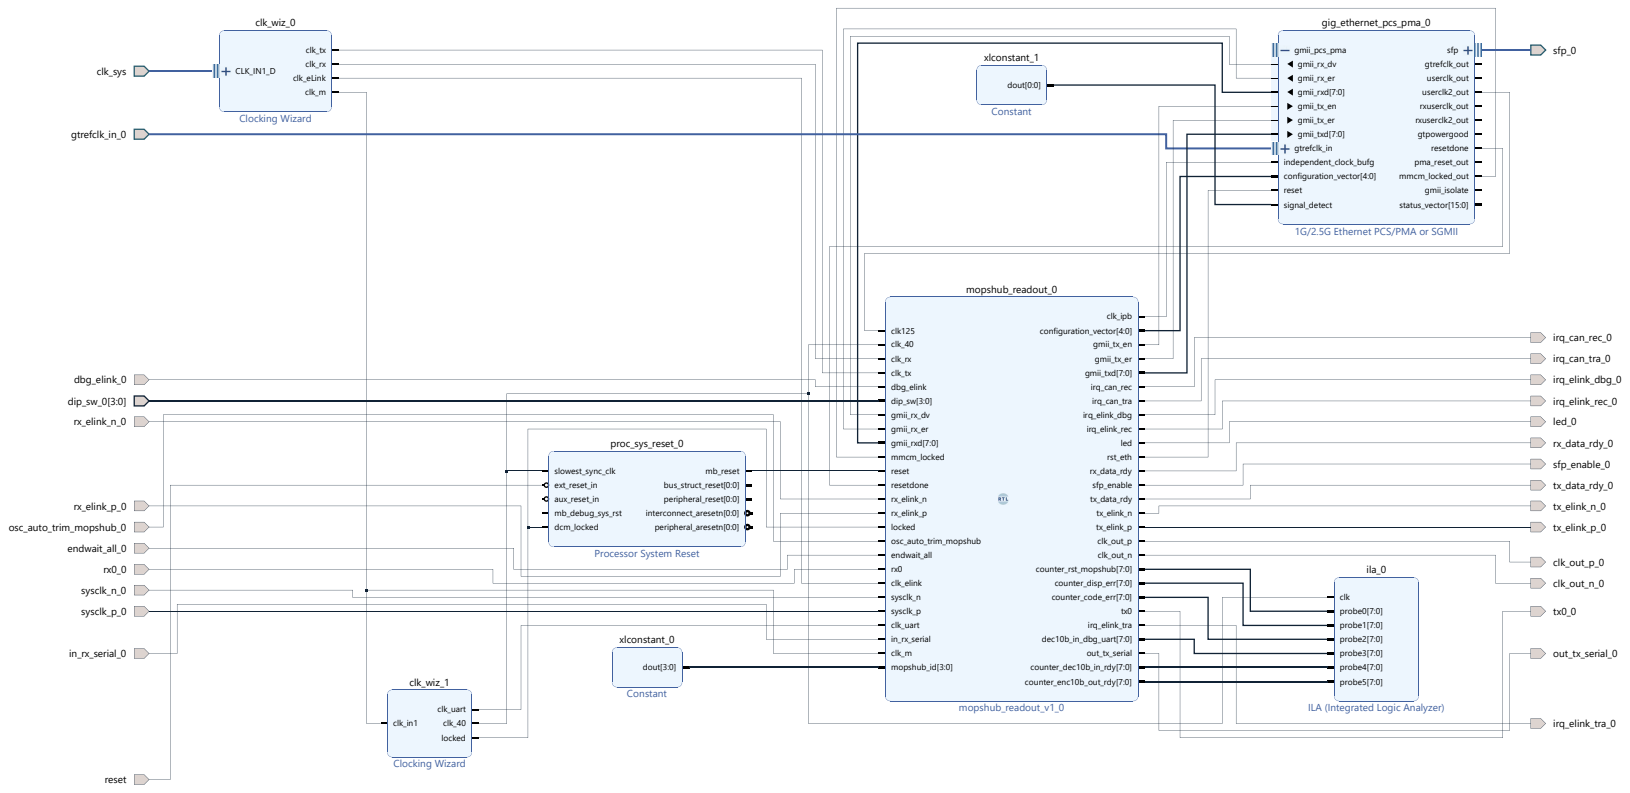
[picture p72: page 1]
clk_sys gtrefclk_in_0 dbg_elink_0 dip_sw_0[3:0] rx_elink_n_0 rx_elink_p_0 osc_auto_trim_mopshub_0 endwait_all_0 rx0_0 sysclk_n_0 sysclk_p_0 in_rx_serial_0 reset; clk_wiz_0 Clocking Wizard CLK_IN1_D; clk_tx clk_rx clk_eLink clk_m; clk_wiz_1 Clocking Wizard clk_in1; clk_uart clk_40 locked; proc_sys_reset_0 Processor System Reset slowest_sync_clk ext_reset_in aux_reset_in mb_debug_sys_rst dcm_locked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
