fsnitz/ATLAS-ITk-MOPS-Hub-readout-prototype/Miscellaneous/BlockDesignPrints/SystemOverview.pdf

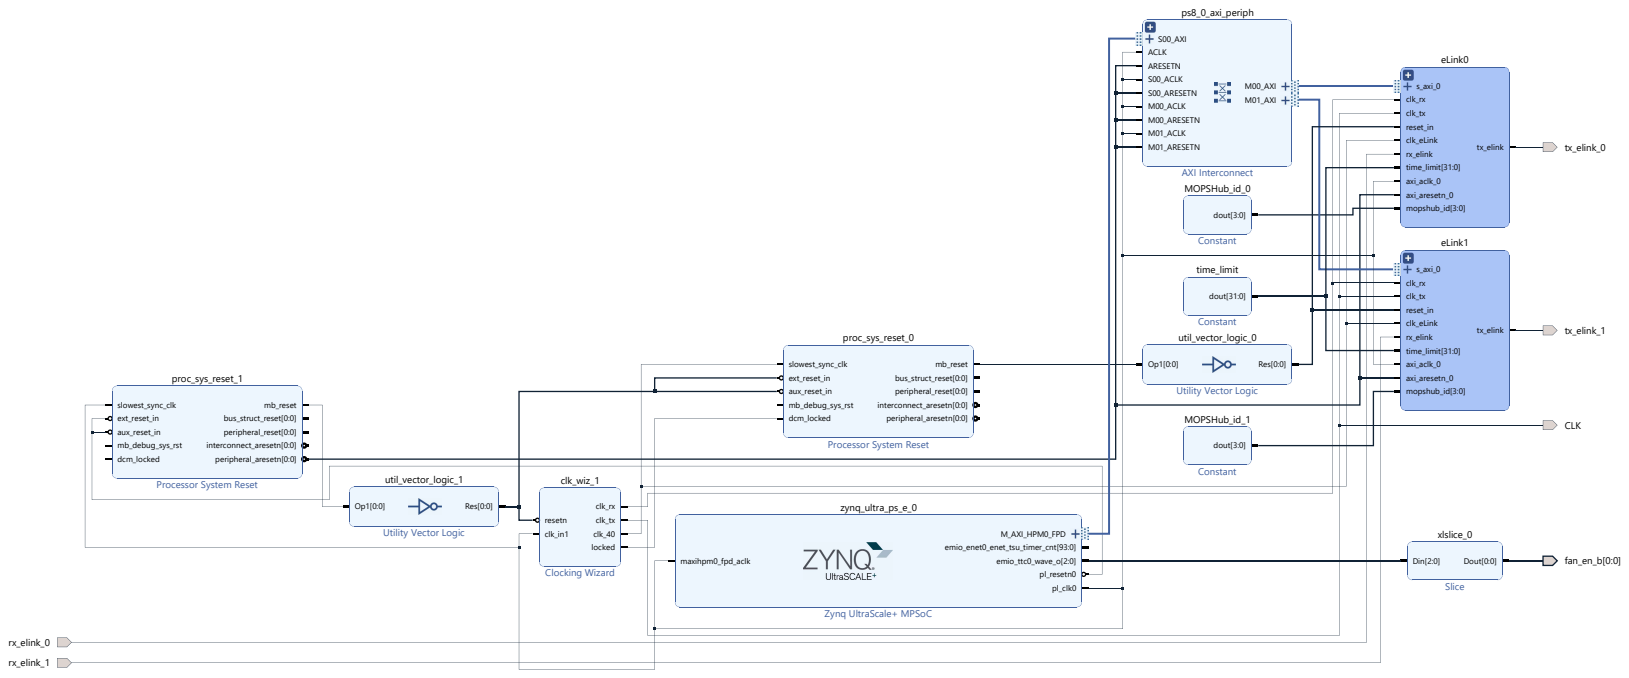
[picture p73: page 1]
MOPSHub_id_0 Constant dout[3:0] MOPSHub_id_1 Constant dout[3:0] clk_wiz_1 Clocking Wizard resetn clk_in1; clk_rx clk_tx clk_40 locked; eLink0 s_axi_0; tx_elink clk_rx clk_tx reset_in clk_eLink rx_elink time_limit[31:0] axi_aclk_0 axi_aresetn_0 mopshub_id[3:0] eLink1 s_axi_0; tx_elink clk_rx clk_tx reset_in clk_eLink rx_elink time_limit[31:0] axi_aclk_0 axi_aresetn_0 mopshub_id[3:0]; fan_en_b[0:0] CLK rx_elink_0 rx_elink_1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
