fsnitz/ATLAS-ITk-MOPS-Hub-readout-prototype/Miscellaneous/BlockDesignPrints/SystemOverviewWithPLtoPS.pdf

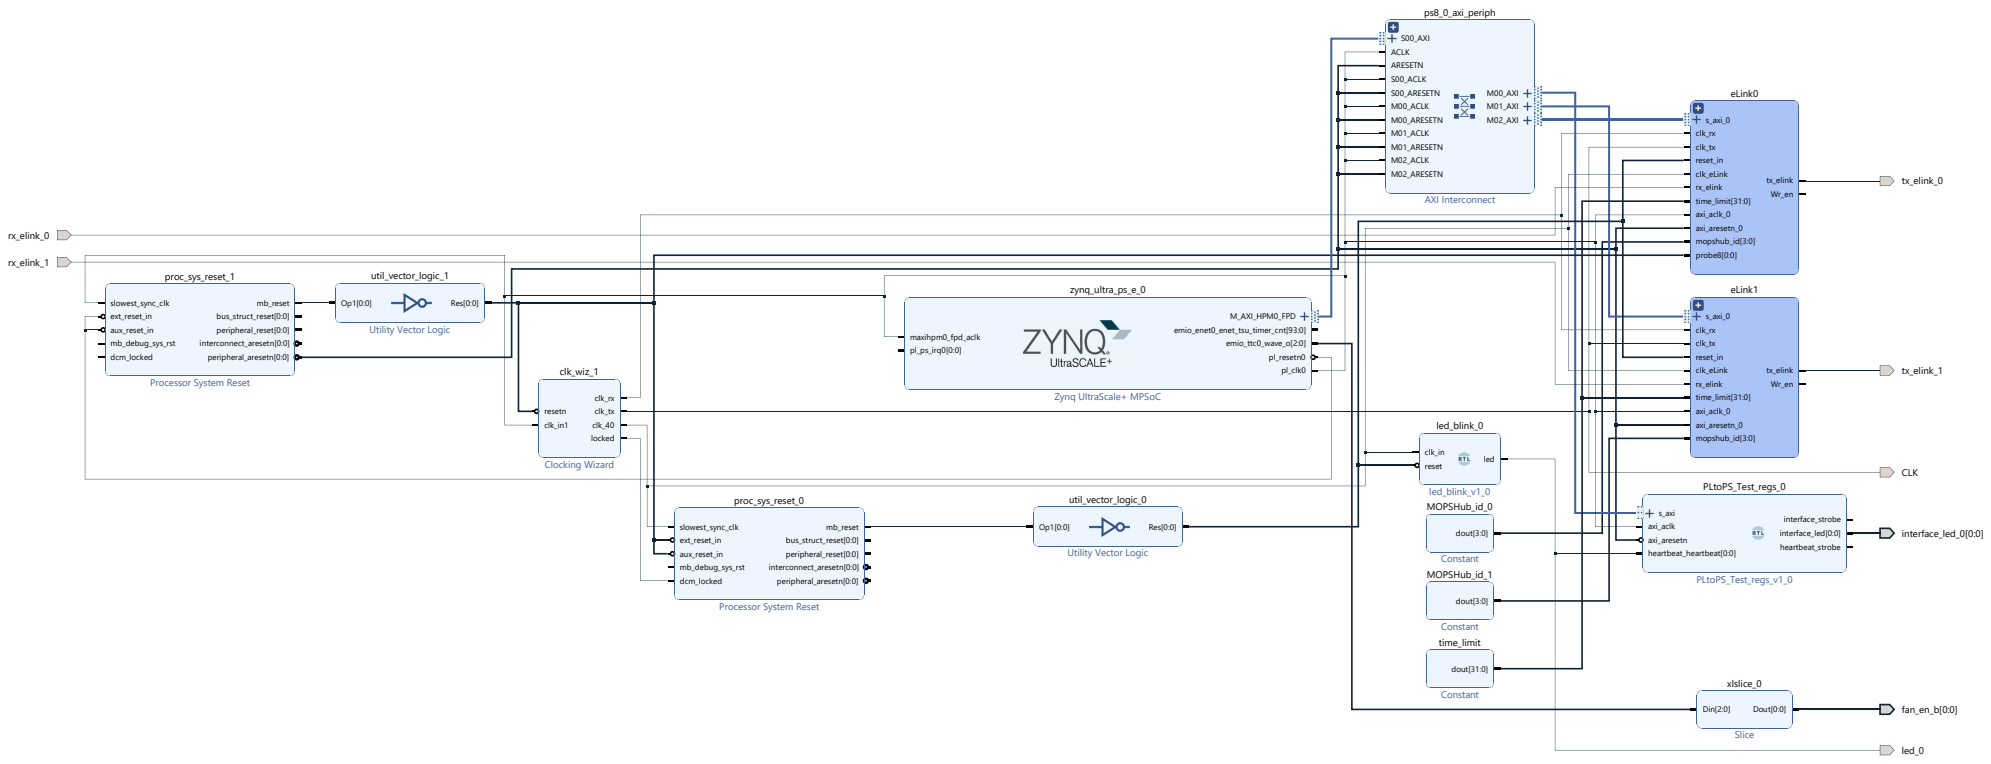
[picture p74: page 1]
MOPSHub_id_0 Constant dout[3:0] MOPSHub_id_1 Constant dout[3:0]; PLtoPS_Test_regs_0 PLtoPS_Test_regs_v1_0 s_axi axi_aclk axi_aresetn; interface_strobe interface_led[0:0] heartbeat_strobe heartbeat_heartbeat[0:0] clk_wiz_1 Clocking Wizard resetn clk_in1; clk_rx clk_tx clk_40 locked; eLink0 s_axi_0; tx_elink clk_rx clk_tx reset_in clk_eLink rx_elink; Wr_en time_limit[31:0] axi_aclk_0 axi_aresetn_0 mopshub_id[3:0] probe8[0:0] eLink1 s_axi_0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
