fsnitz/ATLAS-ITk-MOPS-Hub-readout-prototype/Hardware/KR260eLinkHat/rev02/eLinkHatPCB_Rev02.pdf

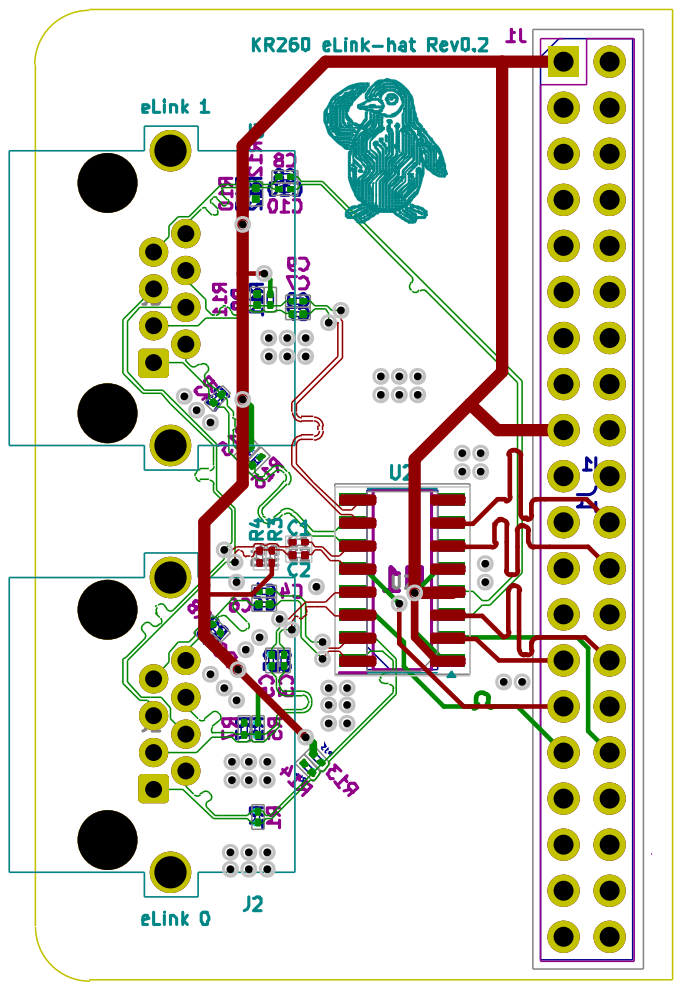
[picture p75: page 1]
