fsnitz/ATLAS-ITk-MOPS-Hub-readout-prototype/Hardware/KR260eLinkHat/rev01/KR260eLinkHatSchematics_Rev01.pdf

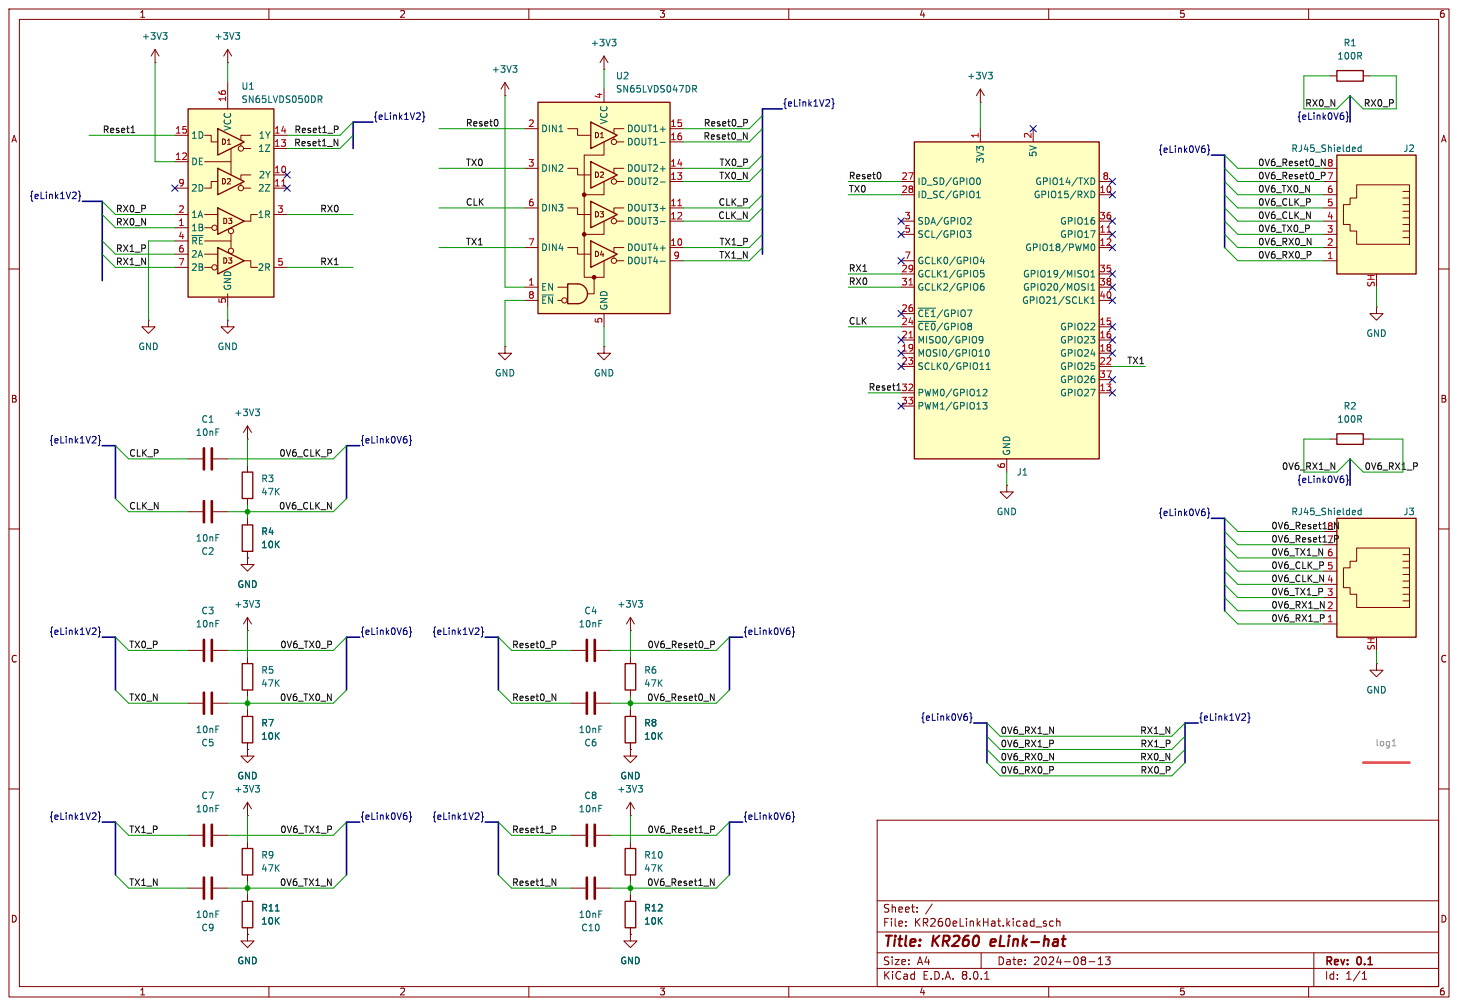
[picture p76: page 1]

Id: 1/1 Title: KR260 eLink-hat File: KR260eLinkHat.kicad_sch Sheet: / R6
