fsnitz/ATLAS-ITk-MOPS-Hub-readout-prototype/Hardware/KR260eLinkHat/rev01/eLinkHatPCB_Rev01.pdf

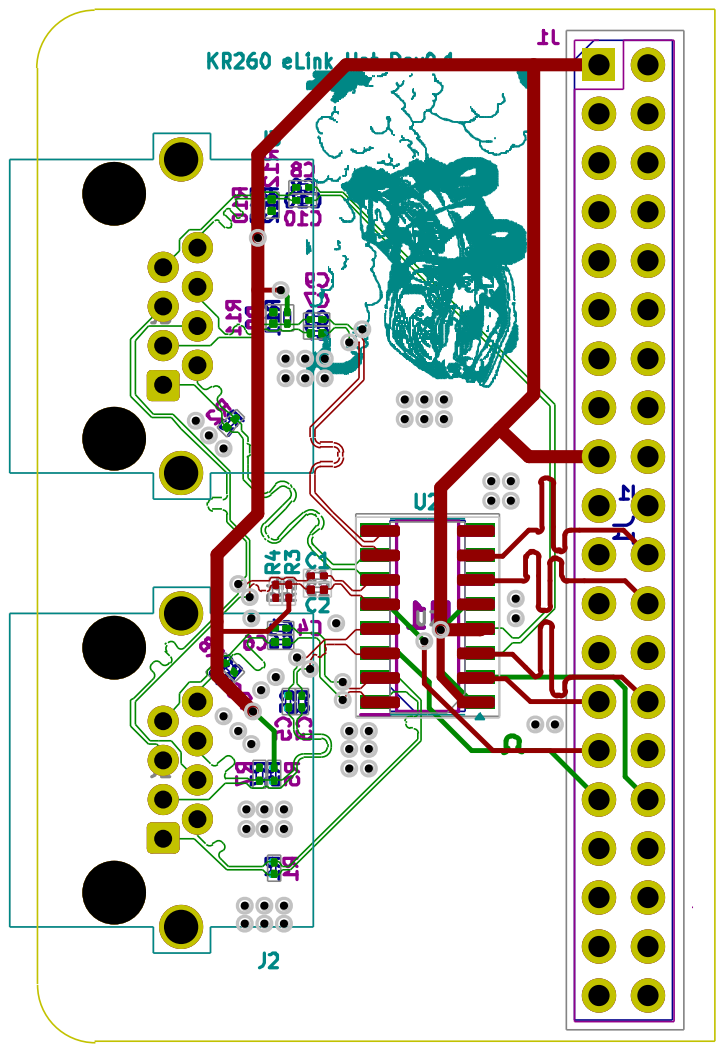
[picture p77: page 1]
