fsnitz/ATLAS-ITk-MOPS-Hub-readout-prototype/Hardware/KR260eLinkHat/rev01/KR260eLinkHat.kicad_pcb

## KiCad design Hardware/KR260eLinkHat/rev01/KR260eLinkHat.kicad_pcb (2026-10-13, an earlier design)

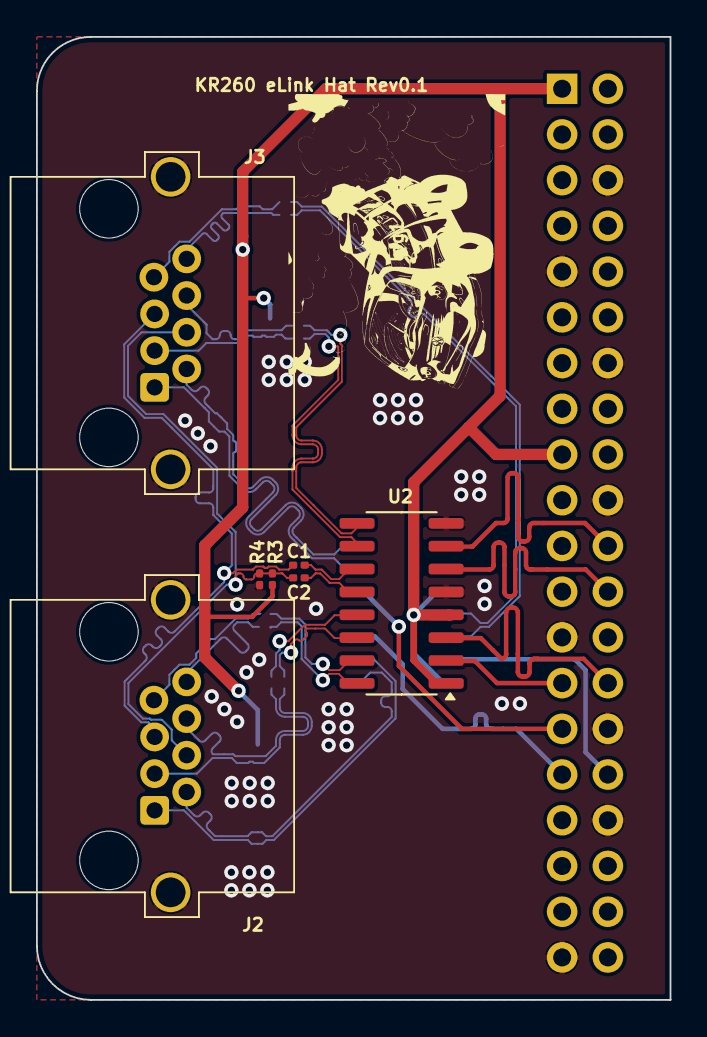
[picture p78: board KR260eLinkHat.kicad_pcb from above]

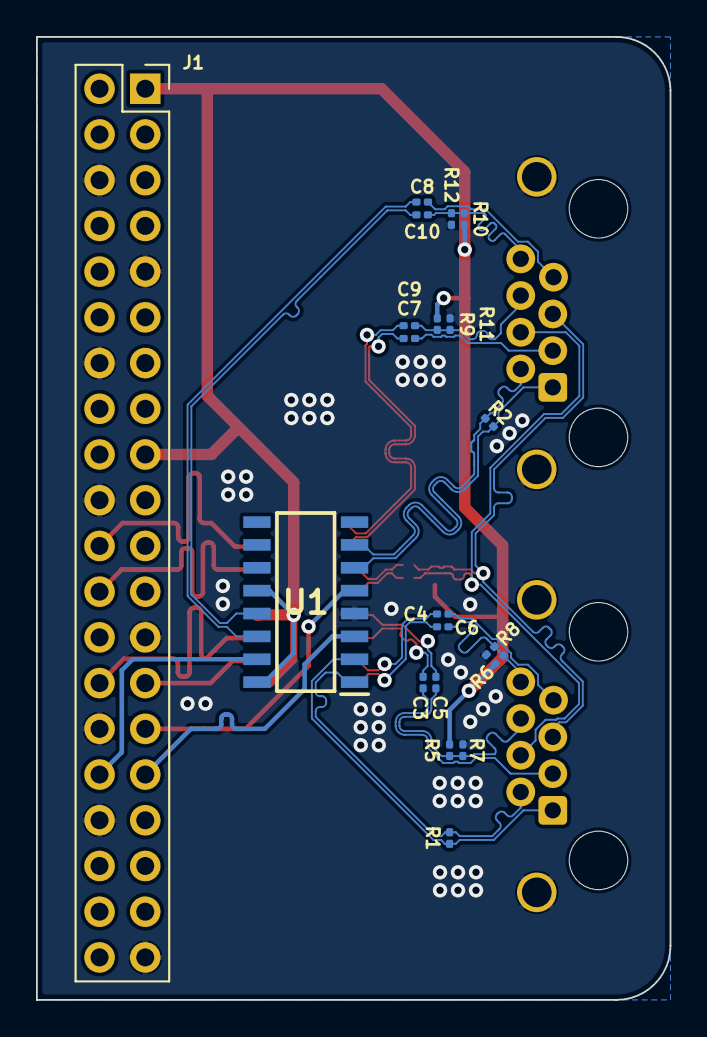
[picture p79: board KR260eLinkHat.kicad_pcb from below]

Board: 4 copper layers, 35.2 x 53.5 mm, 28 parts (20 on the bottom side), 33 nets.

Parts:
C1, C2, C3, C4, C5, C6, C7, C8, C9, C10: 10nF; C_0201_0603Metric
J1: PinSocket_2x20_P2.54mm; RpiHat
J2, J3: RJ45_Shielded; WR-MJ Modular Jack Horizontal Shielded_615008140621
R1, R2: 100R; R_0201_0603Metric
R3, R5, R6, R9, R10: 10K; R_0201_0603Metric
R4, R7, R8, R11, R12: 47K; R_0201_0603Metric
U1: SN65LVDS050DR; SOIC127P600X175-16N
U2: SN65LVDS047DR; SOIC-16_3.9x9.9mm_P1.27mm
log1: BulliLogo

Connections:
+3V3: J1.1 (3V3), J1.17 (3V3), R3.2, R5.2, R6.2, R9.2, R10.2, U1.12 (DE), U1.16 (VCC), U2.1 (EN), U2.4 (VCC)
/0V6_CLK_N: C2.2, J2.4, J3.4, R3.1, R4.2
/0V6_CLK_P: C1.2, J2.5, J3.5
/0V6_RX0_N: J2.2, R1.1, U1.1 (1B)
/0V6_RX0_P: J2.1, R1.2, U1.2 (1A)
/0V6_RX1_N: J3.2, R2.1, U1.7 (2B)
/0V6_RX1_P: J3.1, R2.2, U1.6 (2A)
/0V6_Reset0_N: C6.2, J2.8, R6.1, R8.2
/0V6_Reset0_P: C4.2, J2.7
/0V6_Reset1_N: C10.2, J3.8, R10.1, R12.2
/0V6_Reset1_P: C8.2, J3.7
/0V6_TX0_N: C5.2, J2.6, R5.1, R7.2
/0V6_TX0_P: C3.2, J2.3
/0V6_TX1_N: C9.2, J3.6, R9.1, R11.2
/0V6_TX1_P: C7.2, J3.3
/CLK: J1.24 (~CE0/GPIO8), U2.6 (DIN3)
/CLK_N: C2.1, U2.12 (DOUT3-)
/CLK_P: C1.1, U2.11 (DOUT3+)
/RX0: J1.31 (GCLK2/GPIO6), U1.3 (1R)
/RX1: J1.29 (GCLK1/GPIO5), U1.5 (2R)
/Reset0: J1.27 (ID_SD/GPIO0), U2.2 (DIN1)
/Reset0_N: C6.1, U2.16 (DOUT1-)
/Reset0_P: C4.1, U2.15 (DOUT1+)
/Reset1: J1.32 (PWM0/GPIO12), U1.15 (1D)
/Reset1_N: C10.1, U1.13 (1Z)
/Reset1_P: C8.1, U1.14 (1Y)
/TX0: J1.28 (ID_SC/GPIO1), U2.3 (DIN2)
/TX0_N: C5.1, U2.13 (DOUT2-)
/TX0_P: C3.1, U2.14 (DOUT2+)
/TX1: J1.22 (GPIO25), U2.7 (DIN4)
/TX1_N: C9.1, U2.9 (DOUT4-)
/TX1_P: C7.1, U2.10 (DOUT4+)
GND: J1.6 (GND), J1.9 (GND), J1.14 (GND), J1.20 (GND), J1.25 (GND), J1.30 (GND), J1.34 (GND), J1.39 (GND), J2.SH, J3.SH, R4.1, R7.1, R8.1, R11.1, R12.1, U1.4 (~RE), U2.5 (GND), U2.8 (~EN)
