fsnitz/ATLAS-ITk-MOPS-Hub-readout-prototype/Firmware/SourceFiles/Constraints/MopsHubReadoutBoard.xdc

set_property PACKAGE_PIN AC14 [get_ports CLK]
set_property IOSTANDARD LVTTL [get_ports CLK]
#set_property PACKAGE_PIN L3 [get_ports CLK_25MHz]
#set_property IOSTANDARD SSTL18_I [get_ports CLK_25MHz]
set_property PACKAGE_PIN AD14 [get_ports tx_elink_0]
set_property IOSTANDARD LVTTL [get_ports tx_elink_0]
set_property PACKAGE_PIN AG13 [get_ports rx_elink_0]
set_property IOSTANDARD LVTTL [get_ports rx_elink_0]
set_property PACKAGE_PIN AA8 [get_ports tx_elink_1]
set_property PACKAGE_PIN AH14 [get_ports rx_elink_1]
set_property IOSTANDARD LVTTL [get_ports rx_elink_1]
set_property IOSTANDARD LVTTL [get_ports tx_elink_1]


set_property PACKAGE_PIN A12 [get_ports {fan_en_b[0]}]
set_property IOSTANDARD LVCMOS18 [get_ports {fan_en_b[0]}]
