fsnitz/ATLAS-ITk-MOPS-Hub-readout-prototype/Firmware/SourceFiles/hdl/timeout_rst_watchdog.v

`resetall
`timescale 1ns/10ps
module timeout_rst_watchdog( 
   input   wire            clk, 
//   input   wire            enable_timeout0, 
//   input   wire            enable_timeout1, 
//   input   wire            enable_timeout2, 
   input   wire    [31:0]  time_limit, 
   input   wire            rst, 
   output  wire            rst_timeout
);

//40MHZ clock gives 25 ns
// Internal Declarations
reg [31:0] counter;
reg rst_timeoutreg;

assign rst_timeout = rst_timeoutreg;
//wire enable_timeout = enable_timeout0 ||enable_timeout1||enable_timeout2;

always@(posedge clk)
begin 
if(!rst)
  begin
   counter <= 0;
  end
else 
begin 
  if(!rst_timeout)
    counter <= {counter + 1};
  else 
    begin
     counter <= 0;
    end
  end
end


always@(posedge clk)
begin 
  if(counter >= time_limit)
      rst_timeoutreg <= 1'b1;
  else
      rst_timeoutreg <= 1'b0;
end 

endmodule // rst_timeout
