fsnitz/ATLAS-ITk-MOPS-Hub-readout-prototype/Firmware/SourceFiles/Constraints/PLtoPS_Test.xdc

set_property PACKAGE_PIN F8 [get_ports {interface_led_0[0]}]
set_property PACKAGE_PIN E8 [get_ports led_0]
set_property PACKAGE_PIN A12 [get_ports {fan_en_b[0]}]

set_property IOSTANDARD LVCMOS18 [get_ports {interface_led_0[0]}]
set_property IOSTANDARD LVCMOS18 [get_ports led_0]
set_property IOSTANDARD LVCMOS18 [get_ports {fan_en_b[0]}]
