fsnitz/ATLAS-ITk-MOPS-Hub-readout-prototype/(commit log)

2026-10-13 Added software for the MOPS-Hub readout board
2026-10-13 Added Board support packages for AMD SoM
