fsnitz/ATLAS-ITk-MOPS-Hub-readout-prototype/(notices)

Notices in the files:
parts and their libraries:
License: Apache-2.0
